mariofritzer/Trilumag/hardware/hauptplatine/vorschau.png

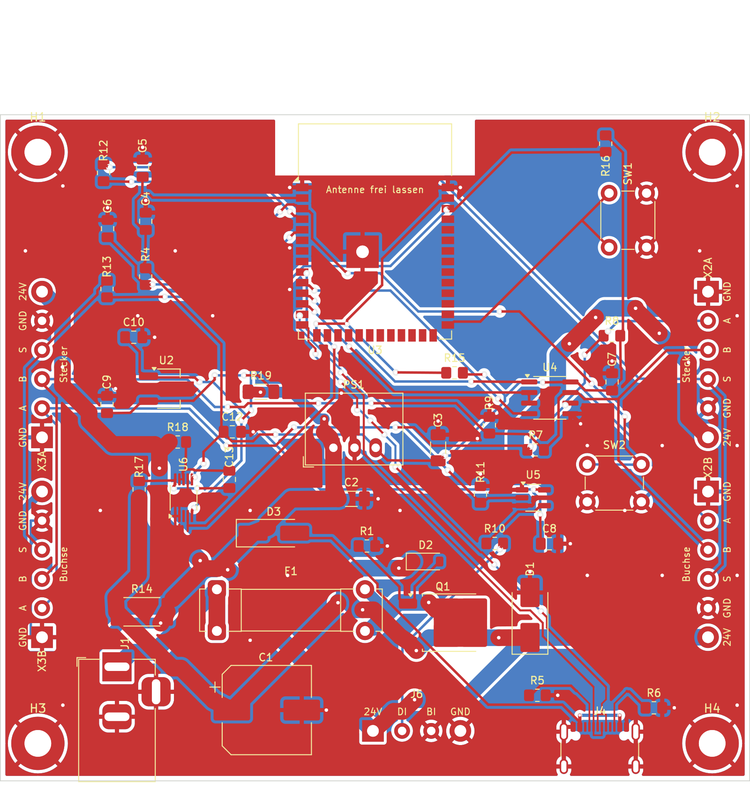
hardware/hauptplatine/vorschau.png
