mariofritzer/Trilumag/hardware/nebenplatine/vorschau.png

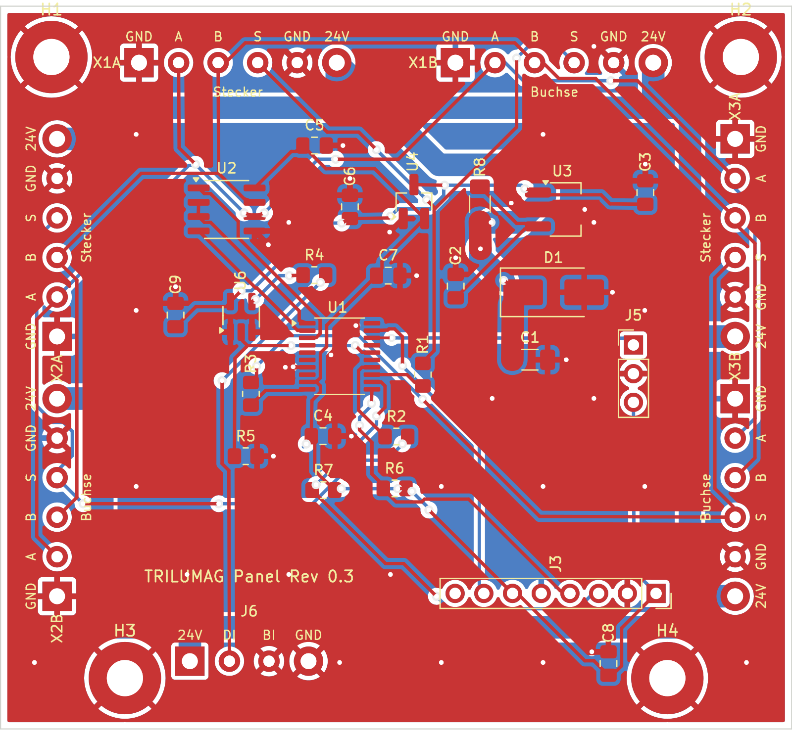
hardware/nebenplatine/vorschau.png
