mariofritzer/Trilumag/hardware/hauptplatine/stueckliste.csv

Menge | Referenzen | Wert | Footprint | Bestellhinweis
1 | C1 | 470µF 35V | CP_Elec_10x10.5 | Elko SMD 10×10,5 470 µF 35 V
1 | C2 | 10µF 50V | C_1206_3216Metric_Pad1.33x1.80mm_HandSolder
1 | C3 | 22µF | C_1206_3216Metric_Pad1.33x1.80mm_HandSolder
1 | C4 | 10µF | C_0805_2012Metric_Pad1.18x1.45mm_HandSolder
5 | C5 C7 C8 C12 C13 | 100nF | C_0805_2012Metric_Pad1.18x1.45mm_HandSolder
2 | C6 C10 | 1µF | C_0805_2012Metric_Pad1.18x1.45mm_HandSolder
1 | C9 | 1µF 50V | C_0805_2012Metric_Pad1.18x1.45mm_HandSolder
1 | D1 | SMBJ26A | D_SMB_Handsoldering | SMBJ26A
1 | D2 | 12V | D_SOD-123 | BZT52C12
1 | D3 | SS34 | D_SMA_Handsoldering | SS34
1 | F1 | 6.3A träge | Fuseholder_Clip-5x20mm_Bel_FC-203-22_Lateral_P17.80x5.00mm_D1.17mm_Horizontal | Sicherungshalter 5×20 + Feinsicherung T6,3A
1 | J1 | 24V DC 5.5/2.1 | BarrelJack_Horizontal | DC-Buchse 5,5/2,1 mm, ≥5 A
1 | J4 | USB-C | USB_C_Receptacle_GCT_USB4105-xx-A_16P_TopMnt_Horizontal | GCT USB4105-GF-A
1 | J6 | LED-Streifen 1 | Kabel_4P_LED
1 | PS1 | R-78E3.3-1.0 | Converter_DCDC_RECOM_R-78E-0.5_THT | RECOM R-78E3.3-1.0 (oder R-783.3-1.0)
1 | Q1 | AOD4185 | TO-252-2 | AOD4185 (P-MOSFET −40 V)
1 | R1 | 100k | R_0805_2012Metric_Pad1.20x1.40mm_HandSolder
2 | R4 R11 | 10k | R_0805_2012Metric_Pad1.20x1.40mm_HandSolder
2 | R5 R6 | 5.1k | R_0805_2012Metric_Pad1.20x1.40mm_HandSolder
1 | R7 | 120Ω | R_0805_2012Metric_Pad1.20x1.40mm_HandSolder
2 | R8 R9 | 680Ω | R_0805_2012Metric_Pad1.20x1.40mm_HandSolder
1 | R10 | 33Ω | R_0805_2012Metric_Pad1.20x1.40mm_HandSolder
2 | R12 R13 | 100Ω | R_0805_2012Metric_Pad1.20x1.40mm_HandSolder
1 | R14 | 5mΩ | R_2512_6332Metric_Pad1.40x3.35mm_HandSolder | Shunt 5 mΩ 2512 2 W
2 | R15 R16 | 4.7k | R_0805_2012Metric_Pad1.20x1.40mm_HandSolder
2 | R17 R18 | 10Ω | R_0805_2012Metric_Pad1.20x1.40mm_HandSolder
1 | R19 | 10Ω | R_1206_3216Metric_Pad1.30x1.75mm_HandSolder
1 | SW1 | BOOT | SW_PUSH_6mm
1 | SW2 | RESET | SW_PUSH_6mm
1 | U2 | 78L05 | SOT-89-3_Handsoldering
1 | U3 | ESP32-S3-WROOM-1-N8R2 | ESP32-S3-WROOM-1 | ESP32-S3-WROOM-1 (N8R2 oder N16R8)
1 | U4 | MAX3485 | SOIC-8_3.9x4.9mm_P1.27mm | MAX3485ESA / SP3485EN
1 | U5 | 74AHCT1G125 | SOT-23-5_HandSoldering
1 | U6 | INA226 | VSSOP-10_3x3mm_P0.5mm | INA226AIDGSR (I²C 0x40)
1 | X2A | Kante 2 Pogo Stecker | Kabel_6P_Stecker | Magnet-Pogo 6-pol. männlich
1 | X2B | Kante 2 Pogo Buchse | Kabel_6P_Buchse | Magnet-Pogo 6-pol. weiblich
1 | X3A | Kante 3 Pogo Stecker | Kabel_6P_Stecker | Magnet-Pogo 6-pol. männlich
1 | X3B | Kante 3 Pogo Buchse | Kabel_6P_Buchse | Magnet-Pogo 6-pol. weiblich
