mariofritzer/Trilumag/hardware/nebenplatine/stueckliste.csv

Menge | Referenzen | Wert | Footprint | Bestellhinweis
1 | C1 | 10µF 50V | C_1206_3216Metric_Pad1.33x1.80mm_HandSolder | X5R/X7R 1206 50 V
1 | C2 | 1µF 50V | C_0805_2012Metric_Pad1.18x1.45mm_HandSolder
3 | C3 C6 C7 | 1µF | C_0805_2012Metric_Pad1.18x1.45mm_HandSolder
4 | C4 C5 C8 C9 | 100nF | C_0805_2012Metric_Pad1.18x1.45mm_HandSolder
1 | D1 | SMBJ26A | D_SMB_Handsoldering | SMBJ26A
1 | J3 | LIS3DH-Modul | PinSocket_1x08_P2.54mm_Vertical
1 | J5 | SWD | PinHeader_1x03_P2.54mm_Vertical
1 | J6 | LED-Streifen 1 | Kabel_4P_LED
3 | R1 R2 R3 | 100Ω | R_0805_2012Metric_Pad1.20x1.40mm_HandSolder
1 | R4 | 33Ω | R_0805_2012Metric_Pad1.20x1.40mm_HandSolder
1 | R5 | 10k | R_0805_2012Metric_Pad1.20x1.40mm_HandSolder
2 | R6 R7 | 4.7k | R_0805_2012Metric_Pad1.20x1.40mm_HandSolder
1 | R8 | 10Ω | R_1206_3216Metric_Pad1.30x1.75mm_HandSolder
1 | U1 | CH32V003F4P6 | TSSOP-20_4.4x6.5mm_P0.65mm | CH32V003F4P6
1 | U2 | MAX3485 | SOIC-8_3.9x4.9mm_P1.27mm | MAX3485ESA / SP3485EN
1 | U3 | 78L05 | SOT-89-3_Handsoldering | 78L05 SOT-89 (≥30 V Eingang)
1 | U4 | XC6206P332MR | SOT-23_Handsoldering | XC6206P332MR (3,3 V)
1 | U6 | 74AHCT1G125 | SOT-23-5_HandSoldering | 74AHCT1G125 SOT-23-5
1 | X1A | Kante 1 Pogo Stecker | Kabel_6P_Stecker | Magnet-Pogo 6-pol. männlich
1 | X1B | Kante 1 Pogo Buchse | Kabel_6P_Buchse | Magnet-Pogo 6-pol. weiblich
1 | X2A | Kante 2 Pogo Stecker | Kabel_6P_Stecker | Magnet-Pogo 6-pol. männlich
1 | X2B | Kante 2 Pogo Buchse | Kabel_6P_Buchse | Magnet-Pogo 6-pol. weiblich
1 | X3A | Kante 3 Pogo Stecker | Kabel_6P_Stecker | Magnet-Pogo 6-pol. männlich
1 | X3B | Kante 3 Pogo Buchse | Kabel_6P_Buchse | Magnet-Pogo 6-pol. weiblich
