mariofritzer/Trilumag/installer/index.html

# Trilumag

Dreieckige Lichtpanels mit Magnetkontakten. Hier spielst du die Firmware für das Hauptpanel direkt aus dem Browser auf einen ESP32 und richtest gleich das WLAN ein.

## Installieren

Mit ESP32 verbinden und installieren Dieser Browser kann nicht auf USB zugreifen. Bitte Chrome, Edge oder Opera am Computer verwenden. Auf iPhone, iPad und in Firefox oder Safari geht es nicht. Die Seite muss über https geöffnet werden.

ESP32ESP32-S3ESP32-C3ESP32-C6Version __VERSION__

Der Installer erkennt selbst, welcher ESP32 angeschlossen ist, und wählt die passende Firmware.

## Ohne ESP32 ausprobieren

Die Trilumag-App läuft hier auch ganz ohne Hardware: mit einer simulierten Panelwand, die du anklipsen, einfärben und mit allen Effekten ausprobieren kannst. Das geht auch am Handy, in jedem Browser.

Simulation öffnen

Alles bleibt in deinem Browser, nichts davon steuert echte Panels. WLAN, Updates, Home Assistant und Hue gehen nur mit einem echten Hauptpanel.

## So geht’s

1. ESP32 per USB-Kabel an den Computer anschließen. Beim ESP32-S3-DevKitC die Buchse mit der Aufschrift COM oder UART nehmen.
2. Oben auf Installieren tippen und im Fenster den Anschluss auswählen, meist heißt er USB Serial, CP210x, CH340 oder USB JTAG/serial.
3. Trilumag installieren wählen. Beim ersten Mal den Speicher löschen lassen. Das Aufspielen dauert etwa eine Minute.
4. Danach fragt der Installer nach deinem WLAN. Netz auswählen, Passwort eingeben, fertig.
5. Mit Gerät besuchen öffnet sich die Trilumag-App. Später erreichst du sie unter http://trilumag.local.

## Simulation oder echte Panels

Nach dem Installieren läuft Trilumag im Simulationsmodus: Die Panels werden in der App angeklipst, ganz ohne Hardware. Unter Optionen in der App stellst du auf Bus um, sobald echte Panels über RS-485 angeschlossen sind. Dort wählst du auch dein Board, damit die Pins stimmen.

## Firmware für die Panels

Die Panels haben einen CH32V003 und werden einmalig mit dem WCH-LinkE programmiert (Pins SWIO, GND und 3V3).

panel.binpanel.hexVersion __VERSION__

1. Windows: Im WCH-LinkUtility als Chip CH32V003 wählen, panel.hex laden und auf Program klicken.
2. Linux, macOS, Windows: mit minichlink aus ch32fun: minichlink -w panel.bin flash -b
3. Ein frisch programmiertes Panel bleibt dunkel. Das ist richtig, es wartet darauf, vom Hauptpanel gefunden zu werden.

## Wenn es nicht klappt

Der ESP32 taucht nicht in der Liste auf

Anderes USB-Kabel probieren, viele Kabel laden nur und übertragen keine Daten. Unter Windows eventuell den Treiber für den USB-Chip installieren (CP210x oder CH340, steht meist auf dem Board).

Die Verbindung bricht beim Aufspielen ab

Taste BOOT gedrückt halten, kurz RESET drücken, BOOT loslassen und neu starten. Dann ist der ESP32 sicher im Programmiermodus.

Das WLAN lässt sich im Installer nicht einrichten

Kein Problem: Der ESP32 öffnet dann ein eigenes Netz Trilumag-Setup mit dem Passwort trilumag. Damit verbinden und http://192.168.4.1 öffnen, dort das WLAN eintragen.

Nur 2,4 GHz

Der ESP32 kann kein 5-GHz-WLAN. Dein Router muss ein 2,4-GHz-Netz anbieten.

Quellcode und Bauplan: github.com/mariofritzer/Trilumag · Versionsverlauf (https://github.com/mariofritzer/Trilumag/blob/main/CHANGELOG.md)
