mariofritzer/Trilumag/hardware/nebenplatine/schaltplan.pdf

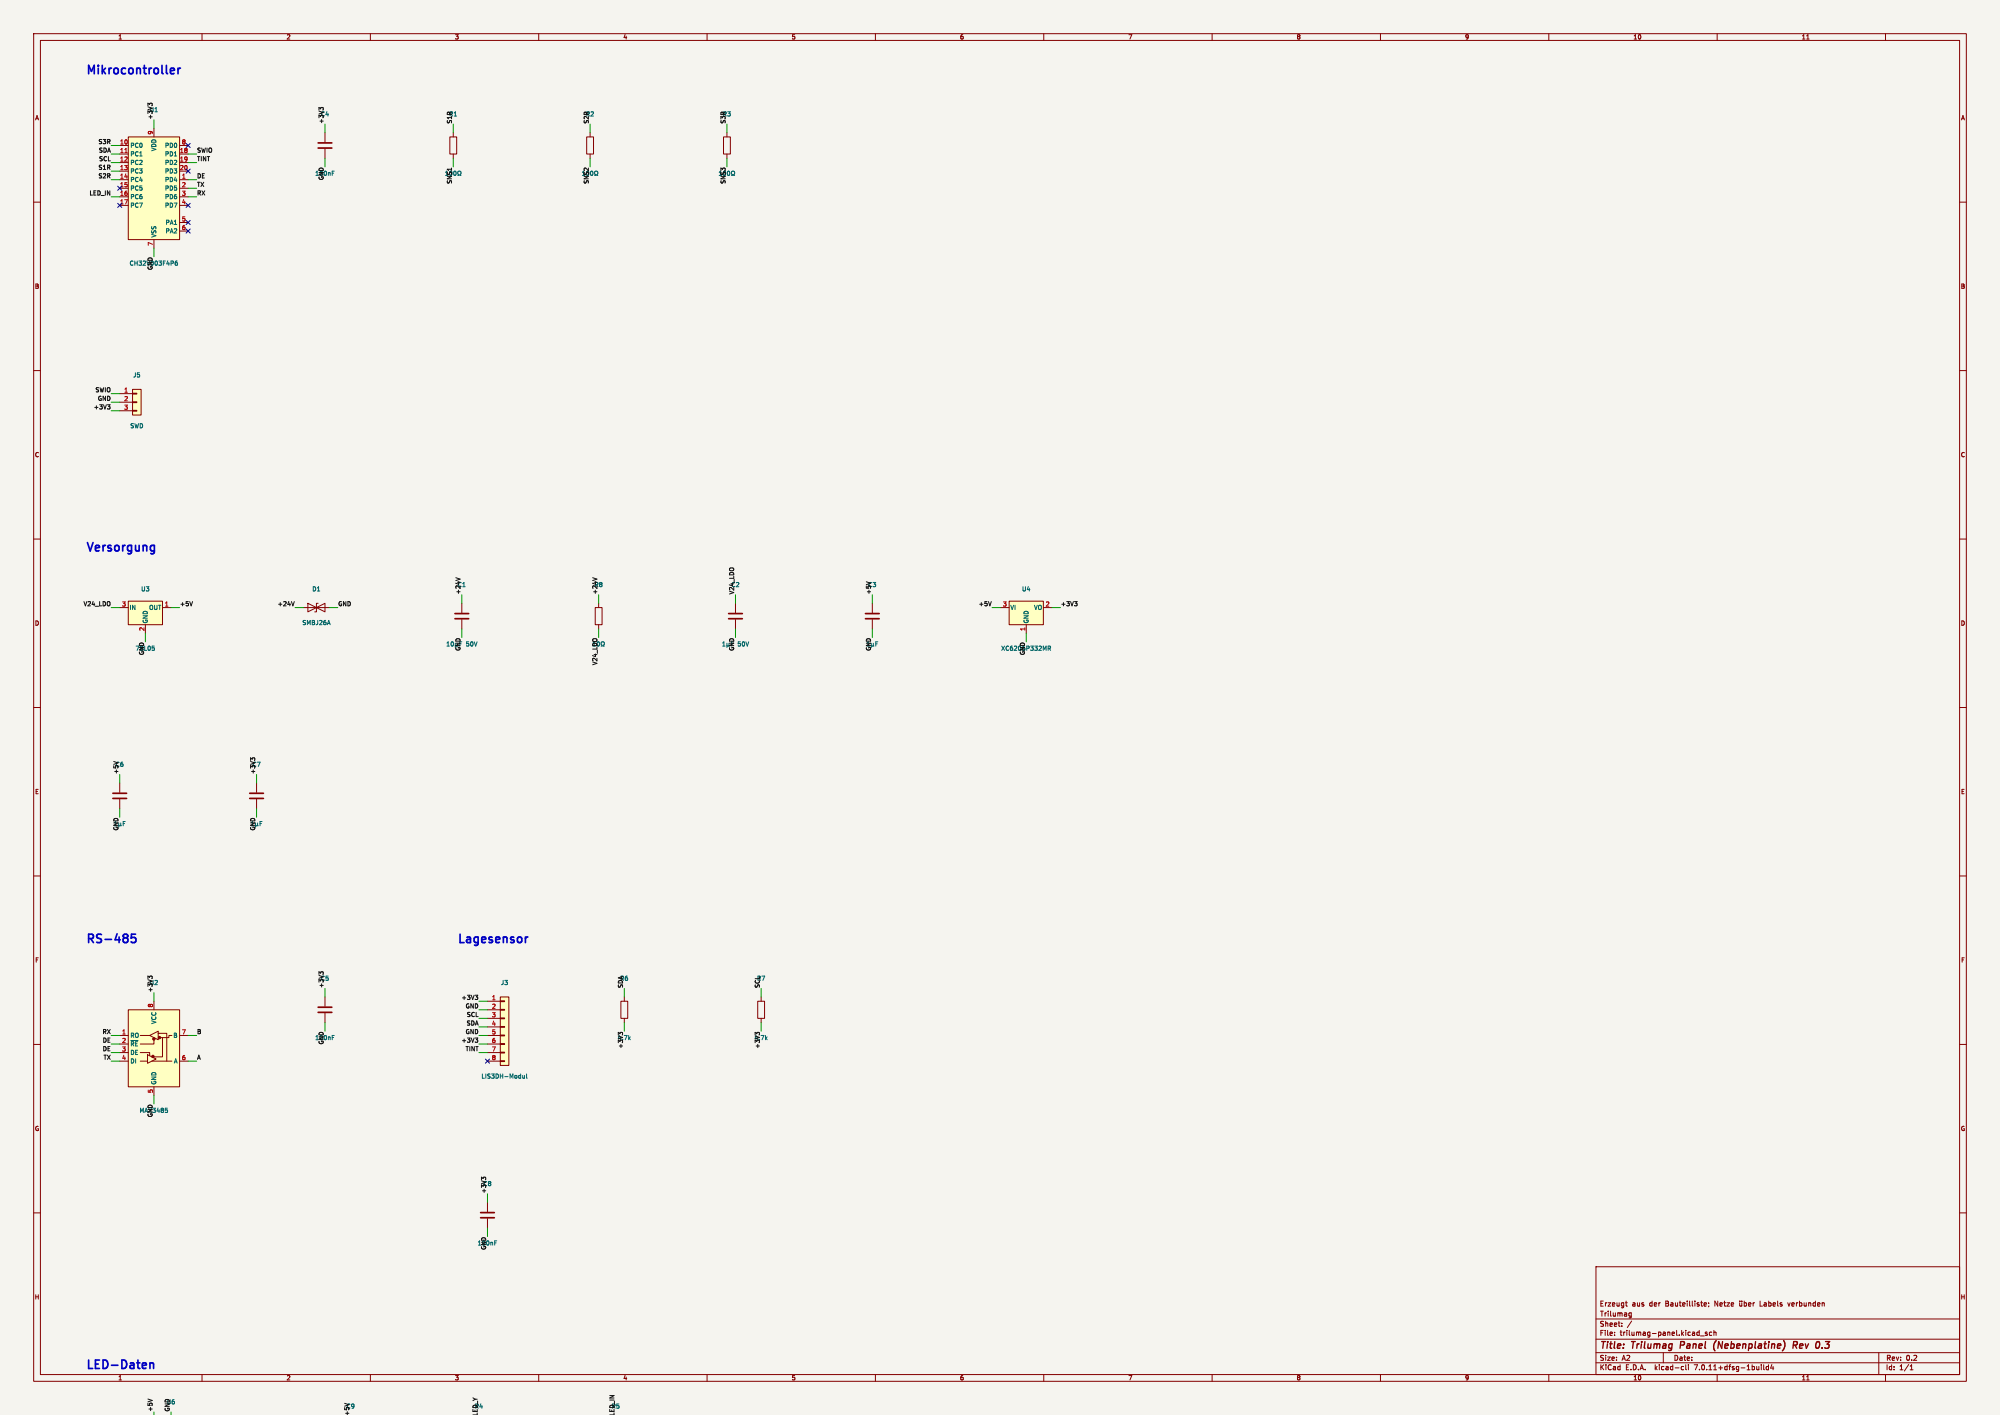
[picture p4: page 1]

File: trilumag-panel.kicad_sch Sheet: / Trilumag
