mariofritzer/Trilumag/hardware/hauptplatine/trilumag-hauptplatine.kicad_pcb

## KiCad design hardware/hauptplatine/trilumag-hauptplatine.kicad_pcb (2026-10-31)

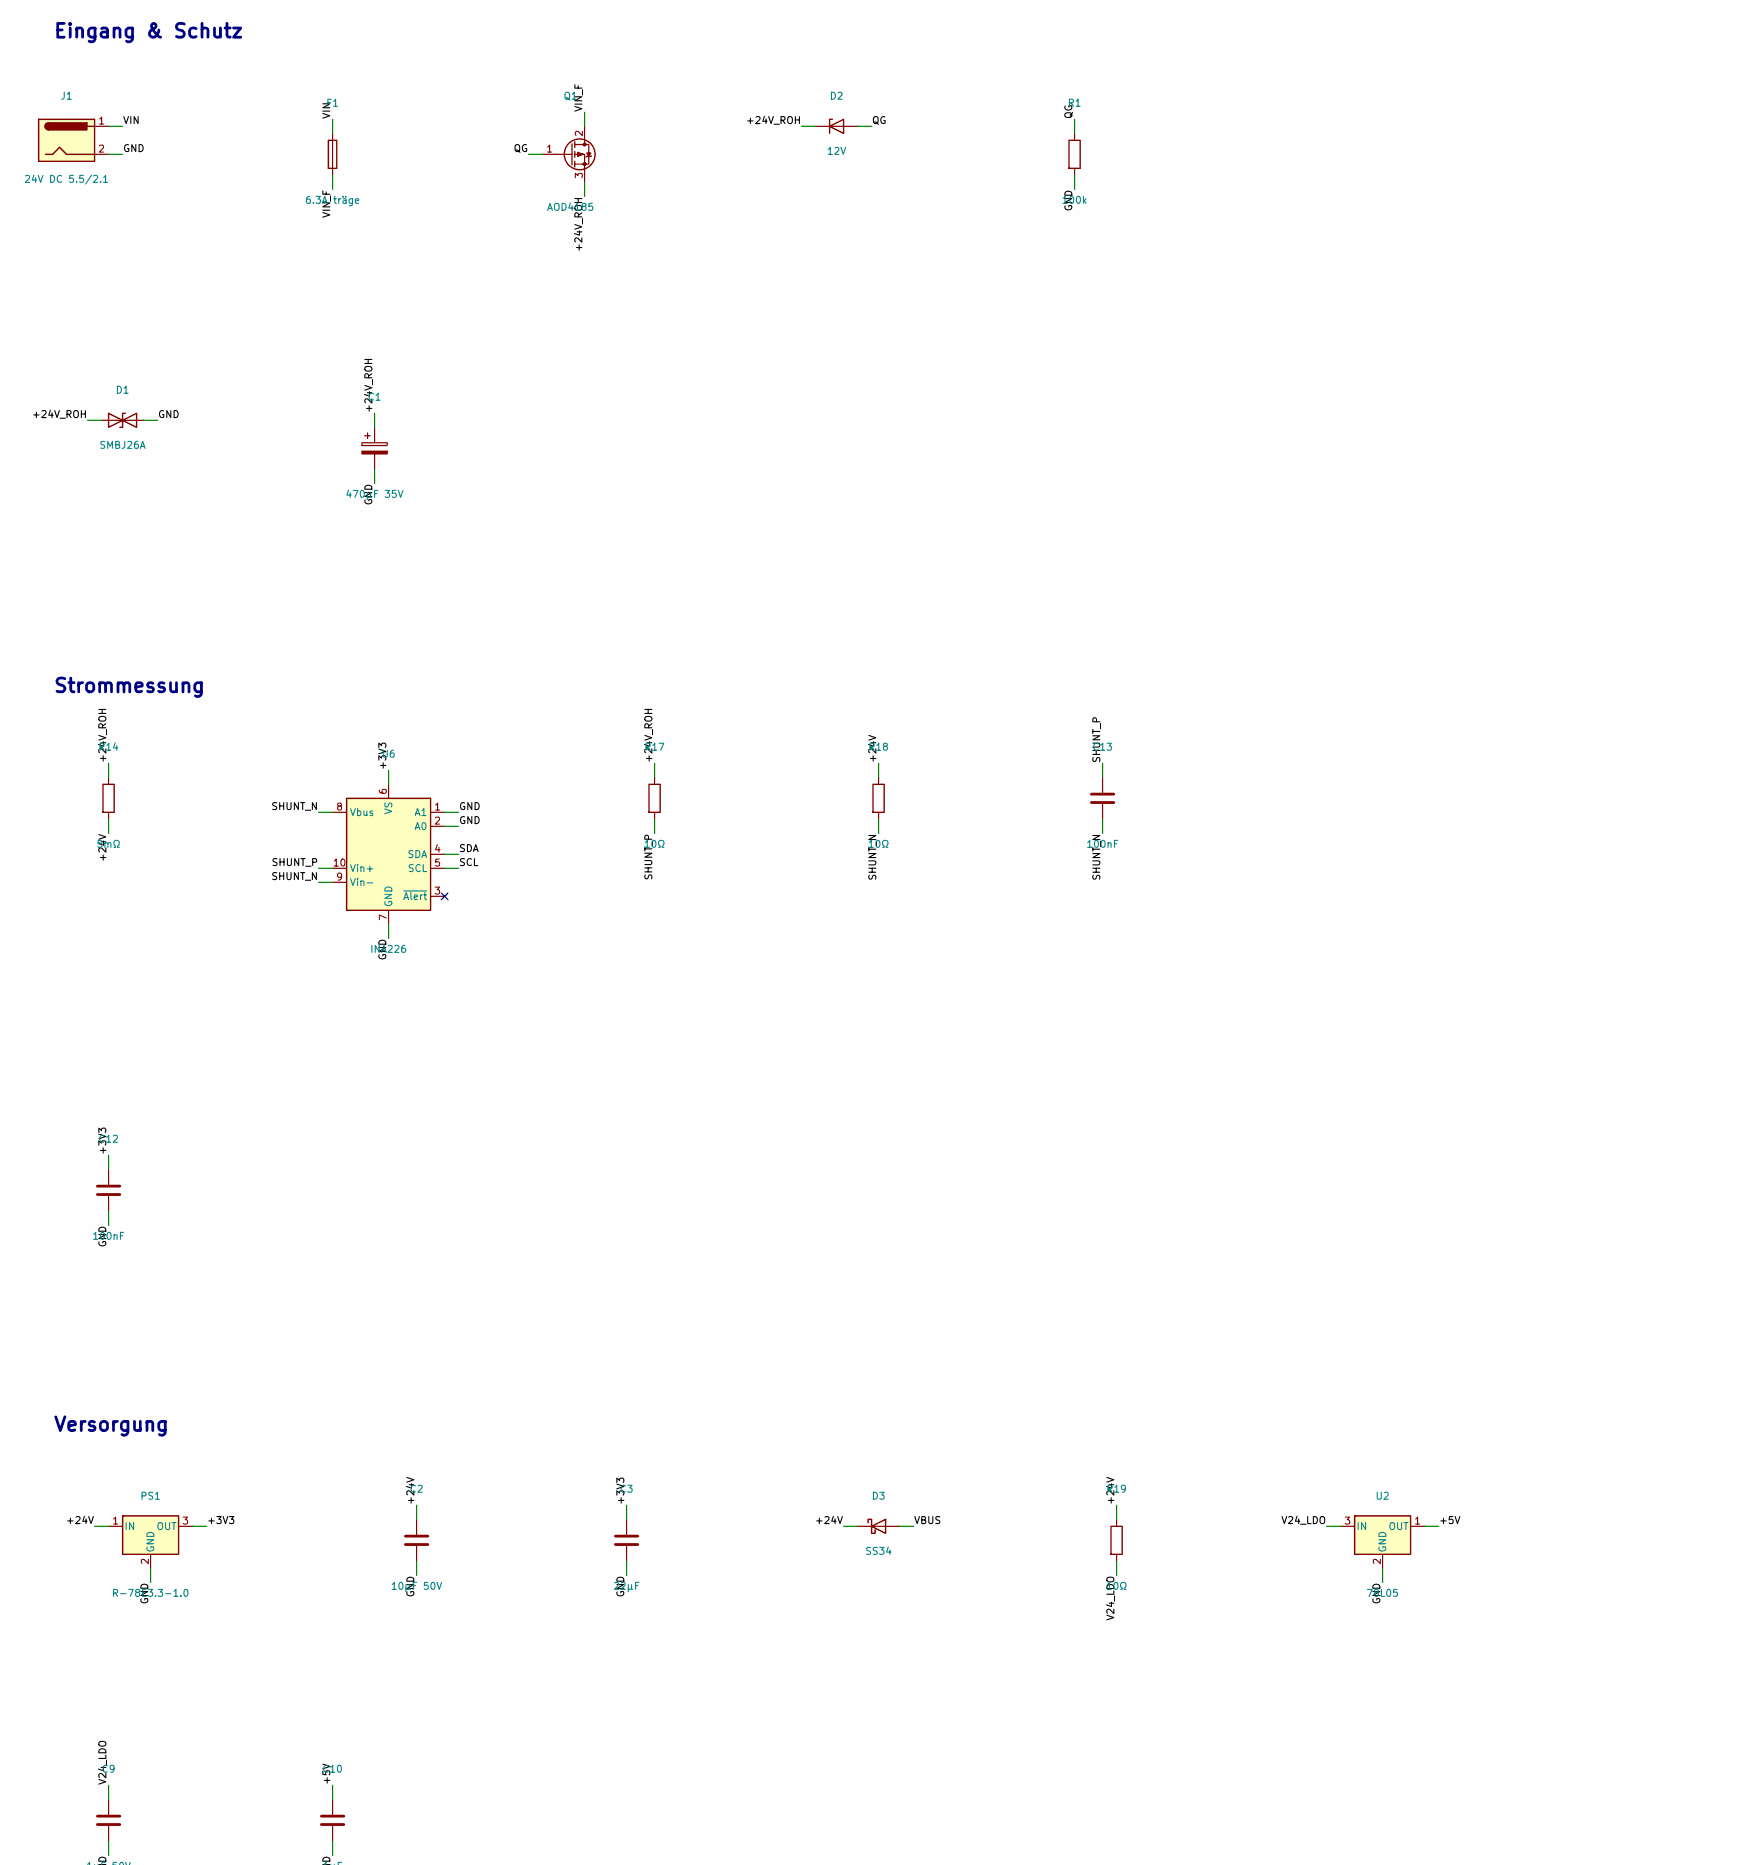
[picture p5: schematic trilumag-hauptplatine.kicad_sch, Trilumag Hauptplatine (ESP32-S3), part in row 1, column 1]

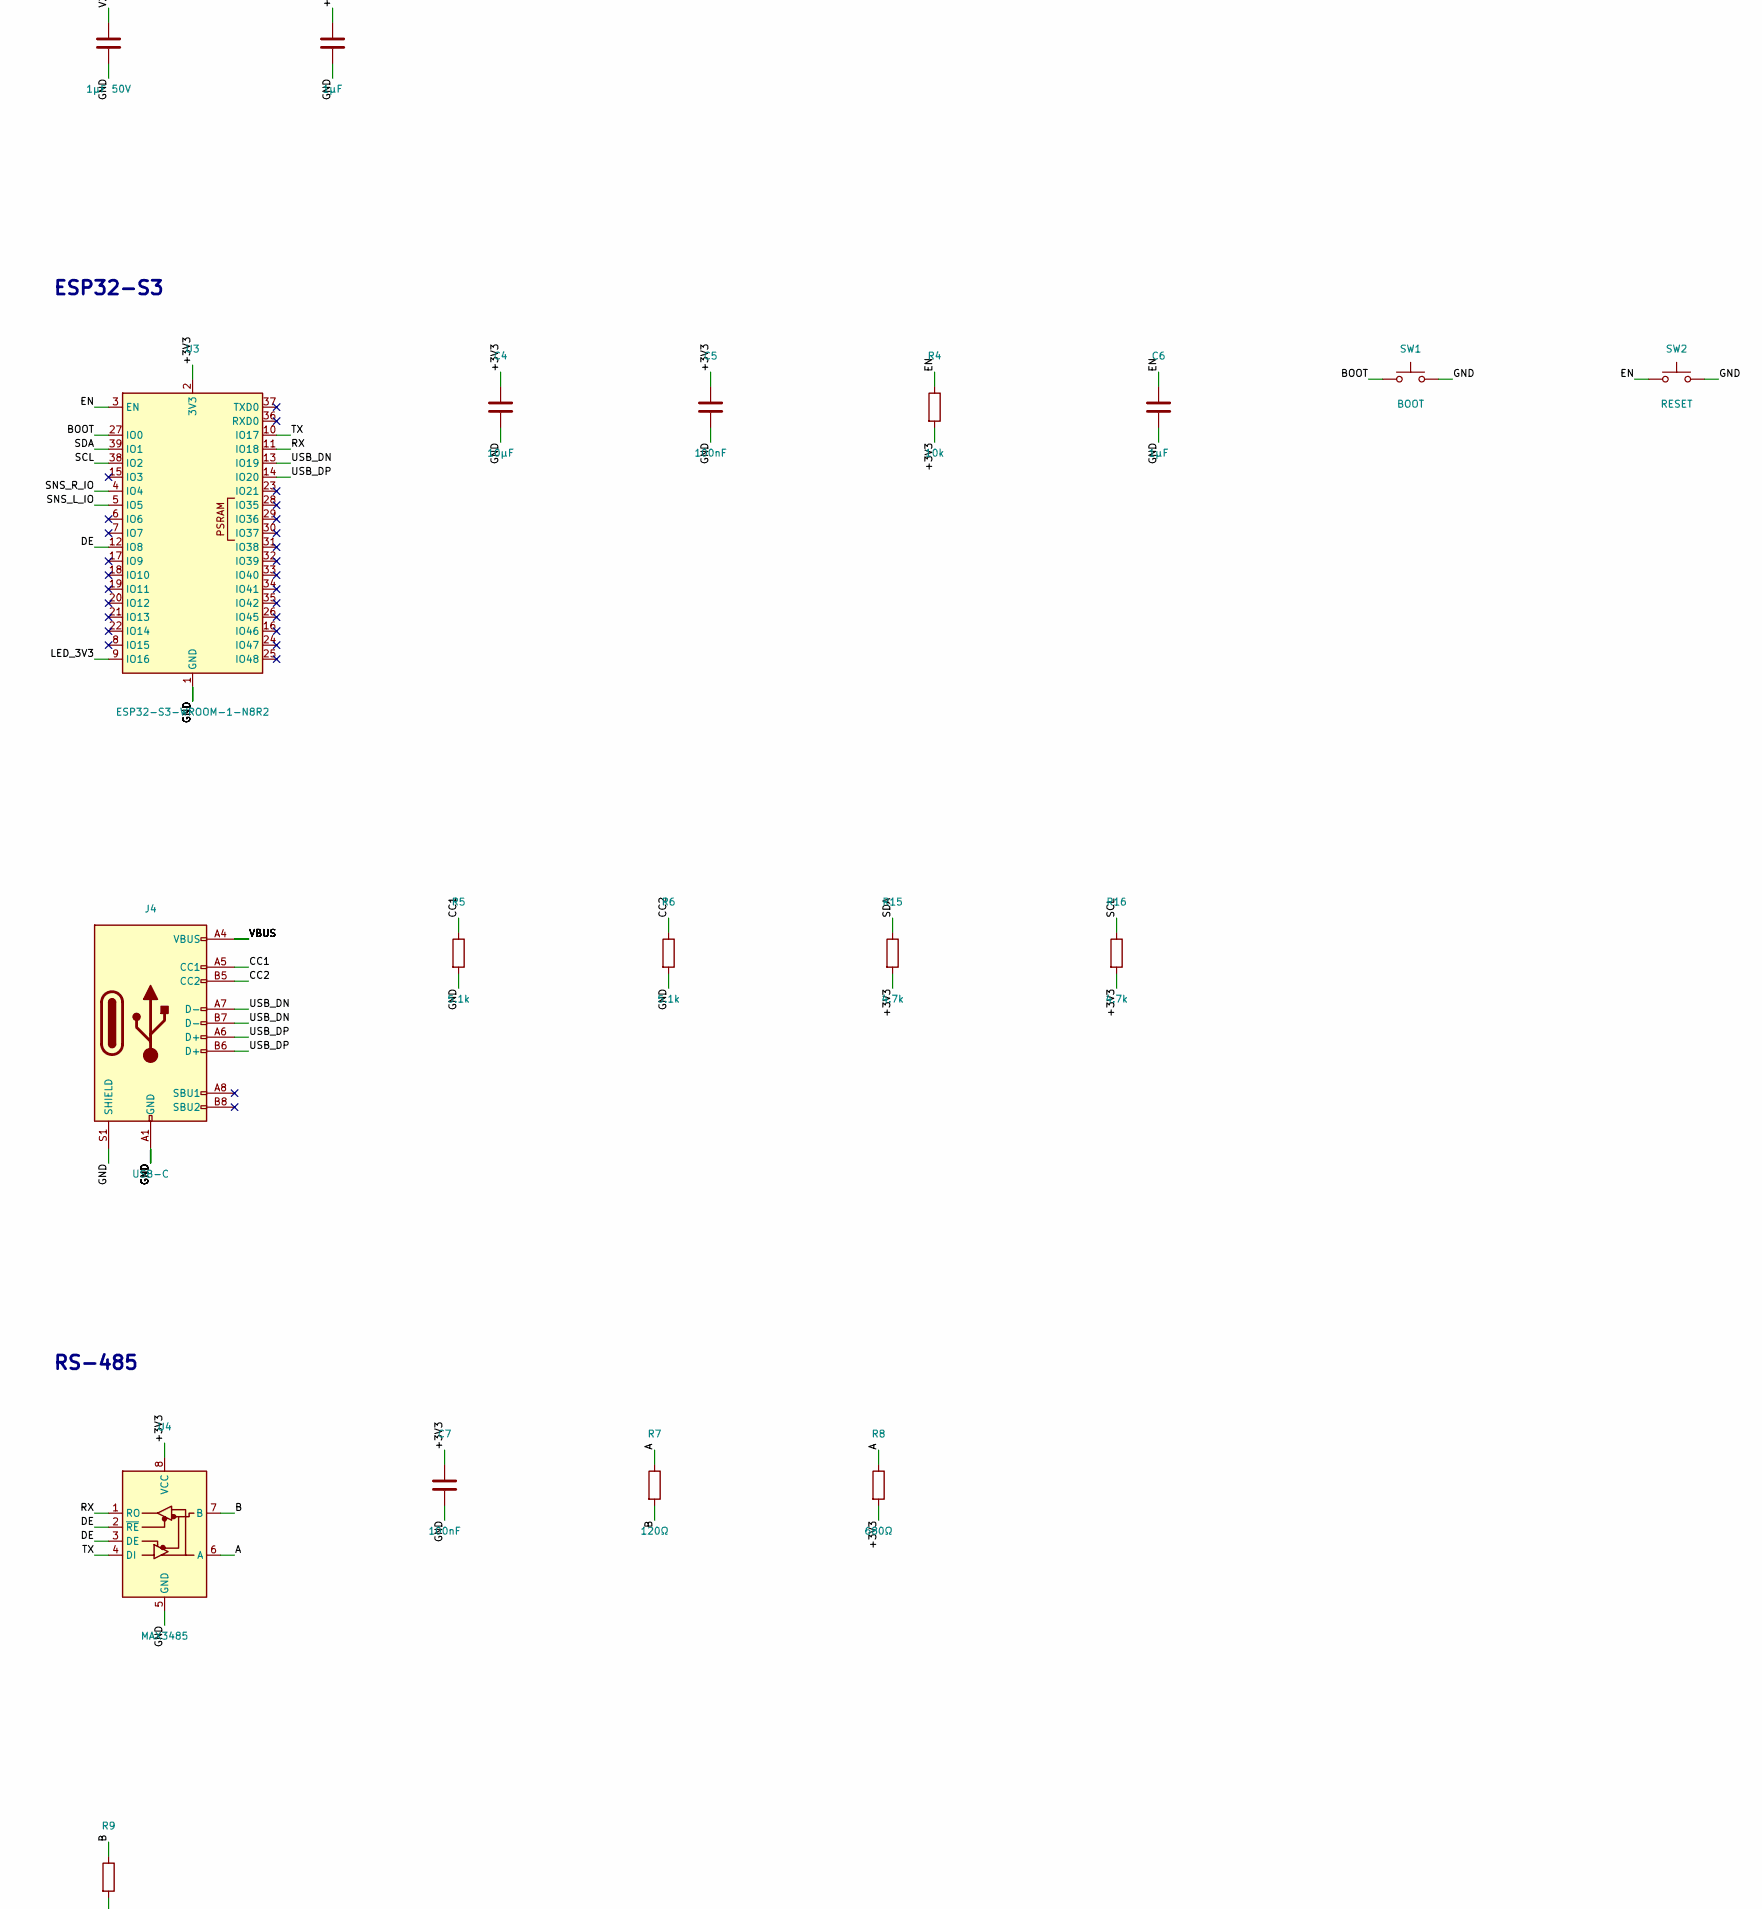
[picture p6: schematic trilumag-hauptplatine.kicad_sch, Trilumag Hauptplatine (ESP32-S3), part in row 2, column 1]

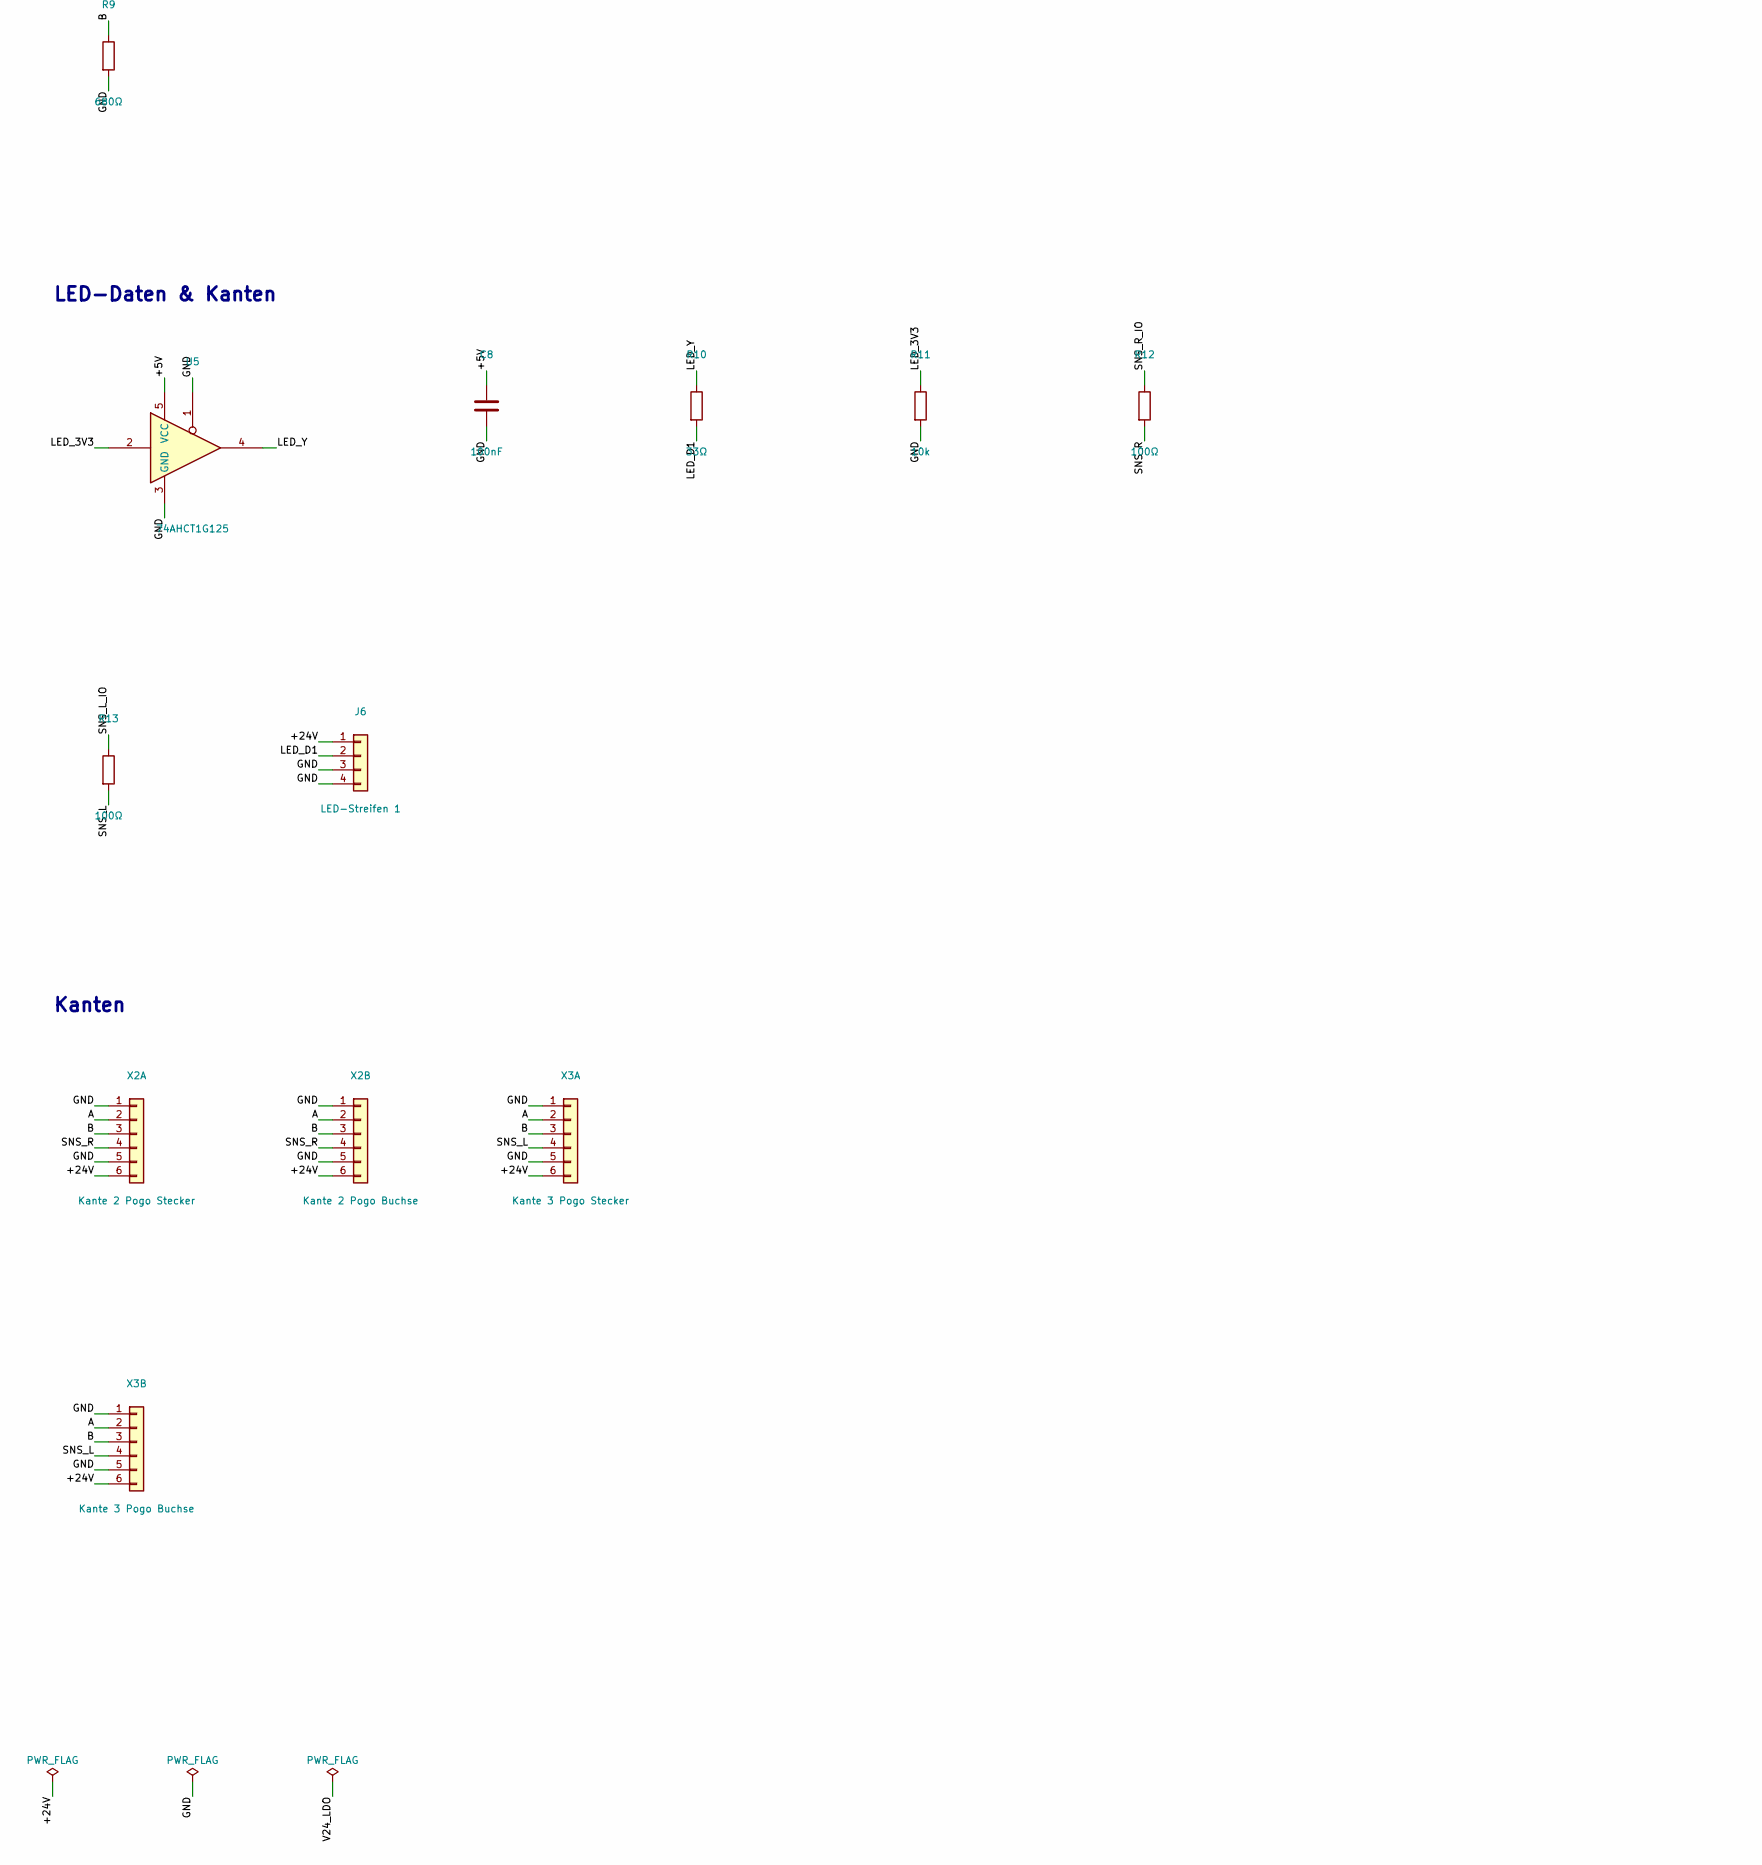
[picture p7: schematic trilumag-hauptplatine.kicad_sch, Trilumag Hauptplatine (ESP32-S3), part in row 3, column 1]

Parts:
C1: 470µF 35V; CP_Elec_10x10.5
C2: 10µF 50V; C_1206_3216Metric_Pad1.33x1.80mm_HandSolder
C3: 22µF; C_1206_3216Metric_Pad1.33x1.80mm_HandSolder
C4: 10µF; C_0805_2012Metric_Pad1.18x1.45mm_HandSolder
C5, C7, C8, C12, C13: 100nF; C_0805_2012Metric_Pad1.18x1.45mm_HandSolder
C6, C10: 1µF; C_0805_2012Metric_Pad1.18x1.45mm_HandSolder
C9: 1µF 50V; C_0805_2012Metric_Pad1.18x1.45mm_HandSolder
D1: SMBJ26A; D_SMB_Handsoldering
D2: 12V; D_SOD-123
D3: SS34; D_SMA_Handsoldering
F1: 6.3A träge; Fuseholder_Clip-5x20mm_Bel_FC-203-22_Lateral_P17.80x5.00mm_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
J1: 24V DC 5.5/2.1; BarrelJack_Horizontal
J4: USB-C; USB_C_Receptacle_GCT_USB4105-xx-A_16P_TopMnt_Horizontal
J6: LED-Streifen 1; Kabel_4P_LED
PS1: R-78E3.3-1.0; Converter_DCDC_RECOM_R-78E-0.5_THT
Q1: AOD4185; TO-252-2
R1: 100k; R_0805_2012Metric_Pad1.20x1.40mm_HandSolder
R4, R11: 10k; R_0805_2012Metric_Pad1.20x1.40mm_HandSolder
R5, R6: 5.1k; R_0805_2012Metric_Pad1.20x1.40mm_HandSolder
R7: 120Ω; R_0805_2012Metric_Pad1.20x1.40mm_HandSolder
R8, R9: 680Ω; R_0805_2012Metric_Pad1.20x1.40mm_HandSolder
R10: 33Ω; R_0805_2012Metric_Pad1.20x1.40mm_HandSolder
R12, R13: 100Ω; R_0805_2012Metric_Pad1.20x1.40mm_HandSolder
R14: 5mΩ; R_2512_6332Metric_Pad1.40x3.35mm_HandSolder
R15, R16: 4.7k; R_0805_2012Metric_Pad1.20x1.40mm_HandSolder
R17, R18: 10Ω; R_0805_2012Metric_Pad1.20x1.40mm_HandSolder
R19: 10Ω; R_1206_3216Metric_Pad1.30x1.75mm_HandSolder
SW1: BOOT; SW_PUSH_6mm
SW2: RESET; SW_PUSH_6mm
U2: 78L05; SOT-89-3_Handsoldering
U3: ESP32-S3-WROOM-1-N8R2; ESP32-S3-WROOM-1
U4: MAX3485; SOIC-8_3.9x4.9mm_P1.27mm
U5: 74AHCT1G125; SOT-23-5_HandSoldering
U6: INA226; VSSOP-10_3x3mm_P0.5mm
X2A: Kante 2 Pogo Stecker; Kabel_6P_Stecker
X2B: Kante 2 Pogo Buchse; Kabel_6P_Buchse
X3A: Kante 3 Pogo Stecker; Kabel_6P_Stecker
X3B: Kante 3 Pogo Buchse; Kabel_6P_Buchse

Connections:
+3V3: C3.1, C4.1, C5.1, C7.1, C12.1, PS1.3 (OUT), R4.2, R8.2, R15.2, R16.2, U3.2 (3V3), U4.8 (VCC), U6.6 (VS)
+5V: C8.1, C10.1, U2.1 (OUT), U5.5 (VCC)
+24V: C2.1, D3.1 (K), J6.1, PS1.1 (IN), R14.2, R18.1, R19.1, X2A.6, X2B.6, X3A.6, X3B.6
+24V_ROH: C1.1, D1.1 (A1), D2.1 (K), Q1.3 (S), R14.1, R17.1
A: R7.1, R8.1, U4.6 (A), X2A.2, X2B.2, X3A.2, X3B.2
B: R7.2, R9.1, U4.7 (B), X2A.3, X2B.3, X3A.3, X3B.3
BOOT: SW1.1, U3.27 (IO0)
CC1: J4.A5 (CC1), R5.1
CC2: J4.B5 (CC2), R6.1
DE: U3.12 (IO8), U4.2 (~RE), U4.3 (DE)
EN: C6.1, R4.1, SW2.1, U3.3 (EN)
GND: C1.2, C2.2, C3.2, C4.2, C5.2, C6.2, C7.2, C8.2, C9.2, C10.2, C12.2, D1.2 (A2), J1.2, J1.3, J4.A1 (GND), J4.A12 (GND), J4.B1 (GND), J4.B12 (GND), J4.S1 (SHIELD), J6.3, J6.4, PS1.2 (GND), R1.2, R5.2, R6.2, R9.2, R11.2, SW1.2, SW2.2, U2.2 (GND), U3.1 (GND), U3.40 (GND), U3.41 (GND), U4.5 (GND), U5.1, U5.3 (GND), U6.1 (A1), U6.2 (A0), U6.7 (GND), X2A.1, X2A.5, X2B.1, X2B.5, X3A.1, X3A.5, X3B.1, X3B.5; also elsewhere on the board
LED_3V3: R11.1, U3.9 (IO16), U5.2
LED_D1: J6.2, R10.2
LED_Y: R10.1, U5.4
QG: D2.2 (A), Q1.1 (G), R1.1
RX: U3.11 (IO18), U4.1 (RO)
SCL: R16.1, U3.38 (IO2), U6.5 (SCL)
SDA: R15.1, U3.39 (IO1), U6.4 (SDA)
SHUNT_N: C13.2, R18.2, U6.8 (Vbus), U6.9 (Vin-)
SHUNT_P: C13.1, R17.2, U6.10 (Vin+)
SNS_L: R13.2, X3A.4, X3B.4
SNS_L_IO: R13.1, U3.5 (IO5)
SNS_R: R12.2, X2A.4, X2B.4
SNS_R_IO: R12.1, U3.4 (IO4)
TX: U3.10 (IO17), U4.4 (DI)
USB_DN: J4.A7 (D-), J4.B7 (D-), U3.13 (IO19)
USB_DP: J4.A6 (D+), J4.B6 (D+), U3.14 (IO20)
V24_LDO: C9.1, R19.2, U2.3 (IN)
VBUS: D3.2 (A), J4.A4 (VBUS), J4.A9 (VBUS), J4.B4 (VBUS), J4.B9 (VBUS)
VIN: F1.1, J1.1
VIN_F: F1.2, Q1.2 (D)

Notes on the sheet:
Eingang & Schutz
Strommessung
Versorgung
ESP32-S3
RS-485
LED-Daten & Kanten
Kanten

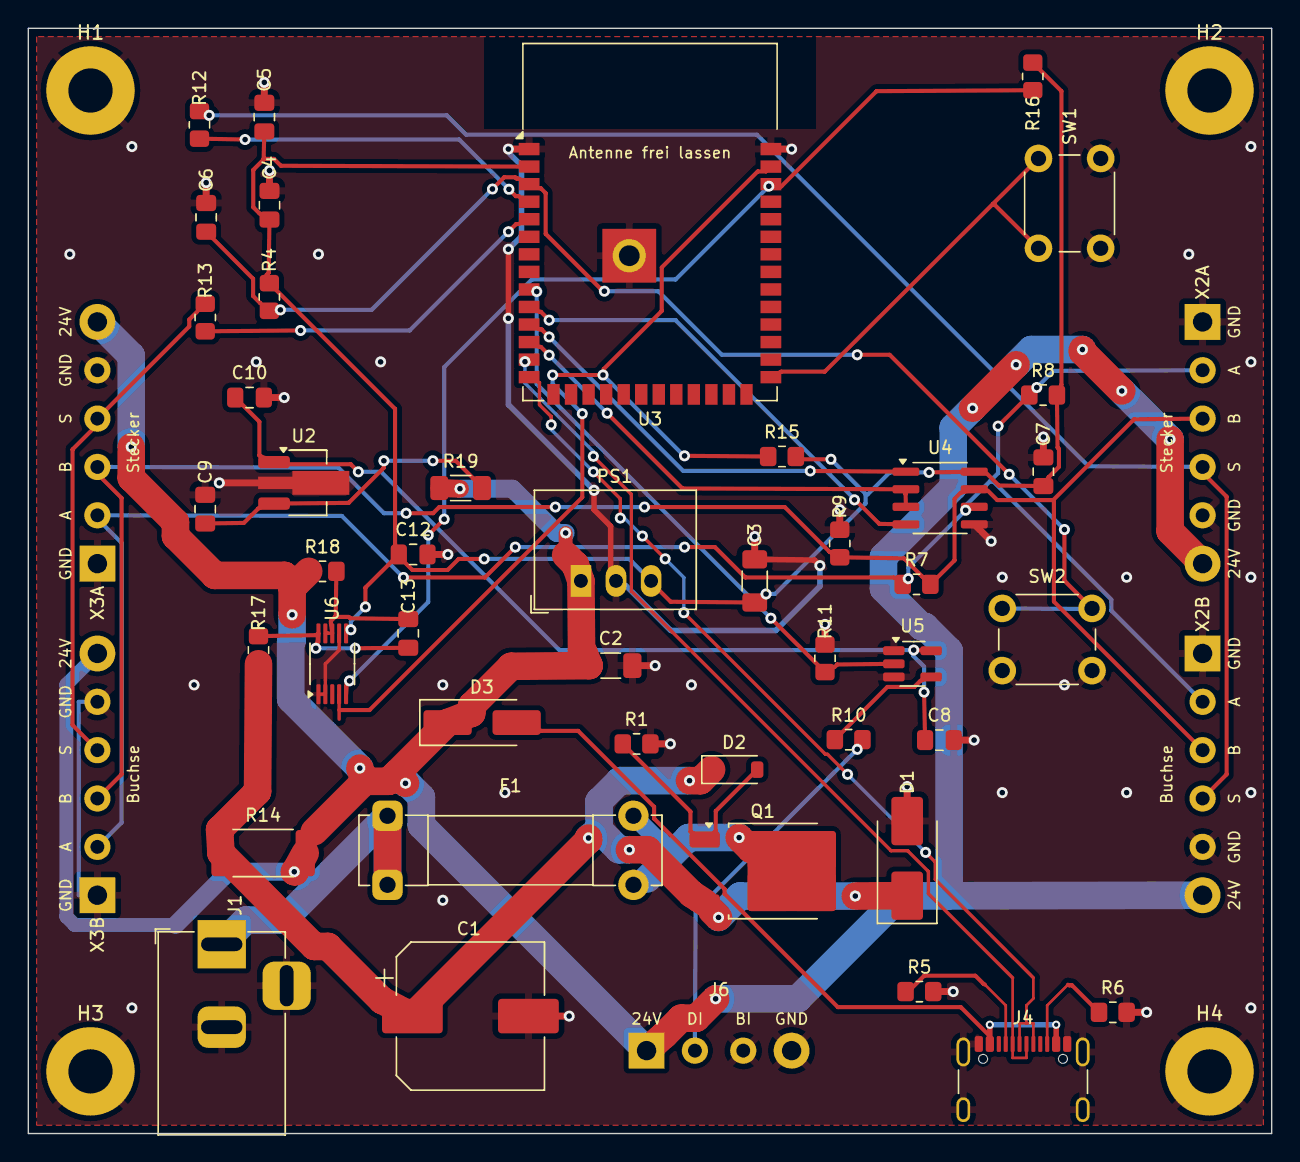
[picture p8: board trilumag-hauptplatine.kicad_pcb from above]

Board: 2 copper layers, 90.0 x 80.0 mm, 53 parts (0 on the bottom side), 32 nets.

Other parts of the board:
H1, H2, H3, H4: M3; MountingHole_3.2mm_M3_Pad

Their connections:
GND: H1.1, H2.1, H3.1, H4.1; also elsewhere on the board
