mariofritzer/Trilumag/hardware/nebenplatine/trilumag-panel.kicad_pcb

## KiCad design hardware/nebenplatine/trilumag-panel.kicad_pcb (2026-10-31)

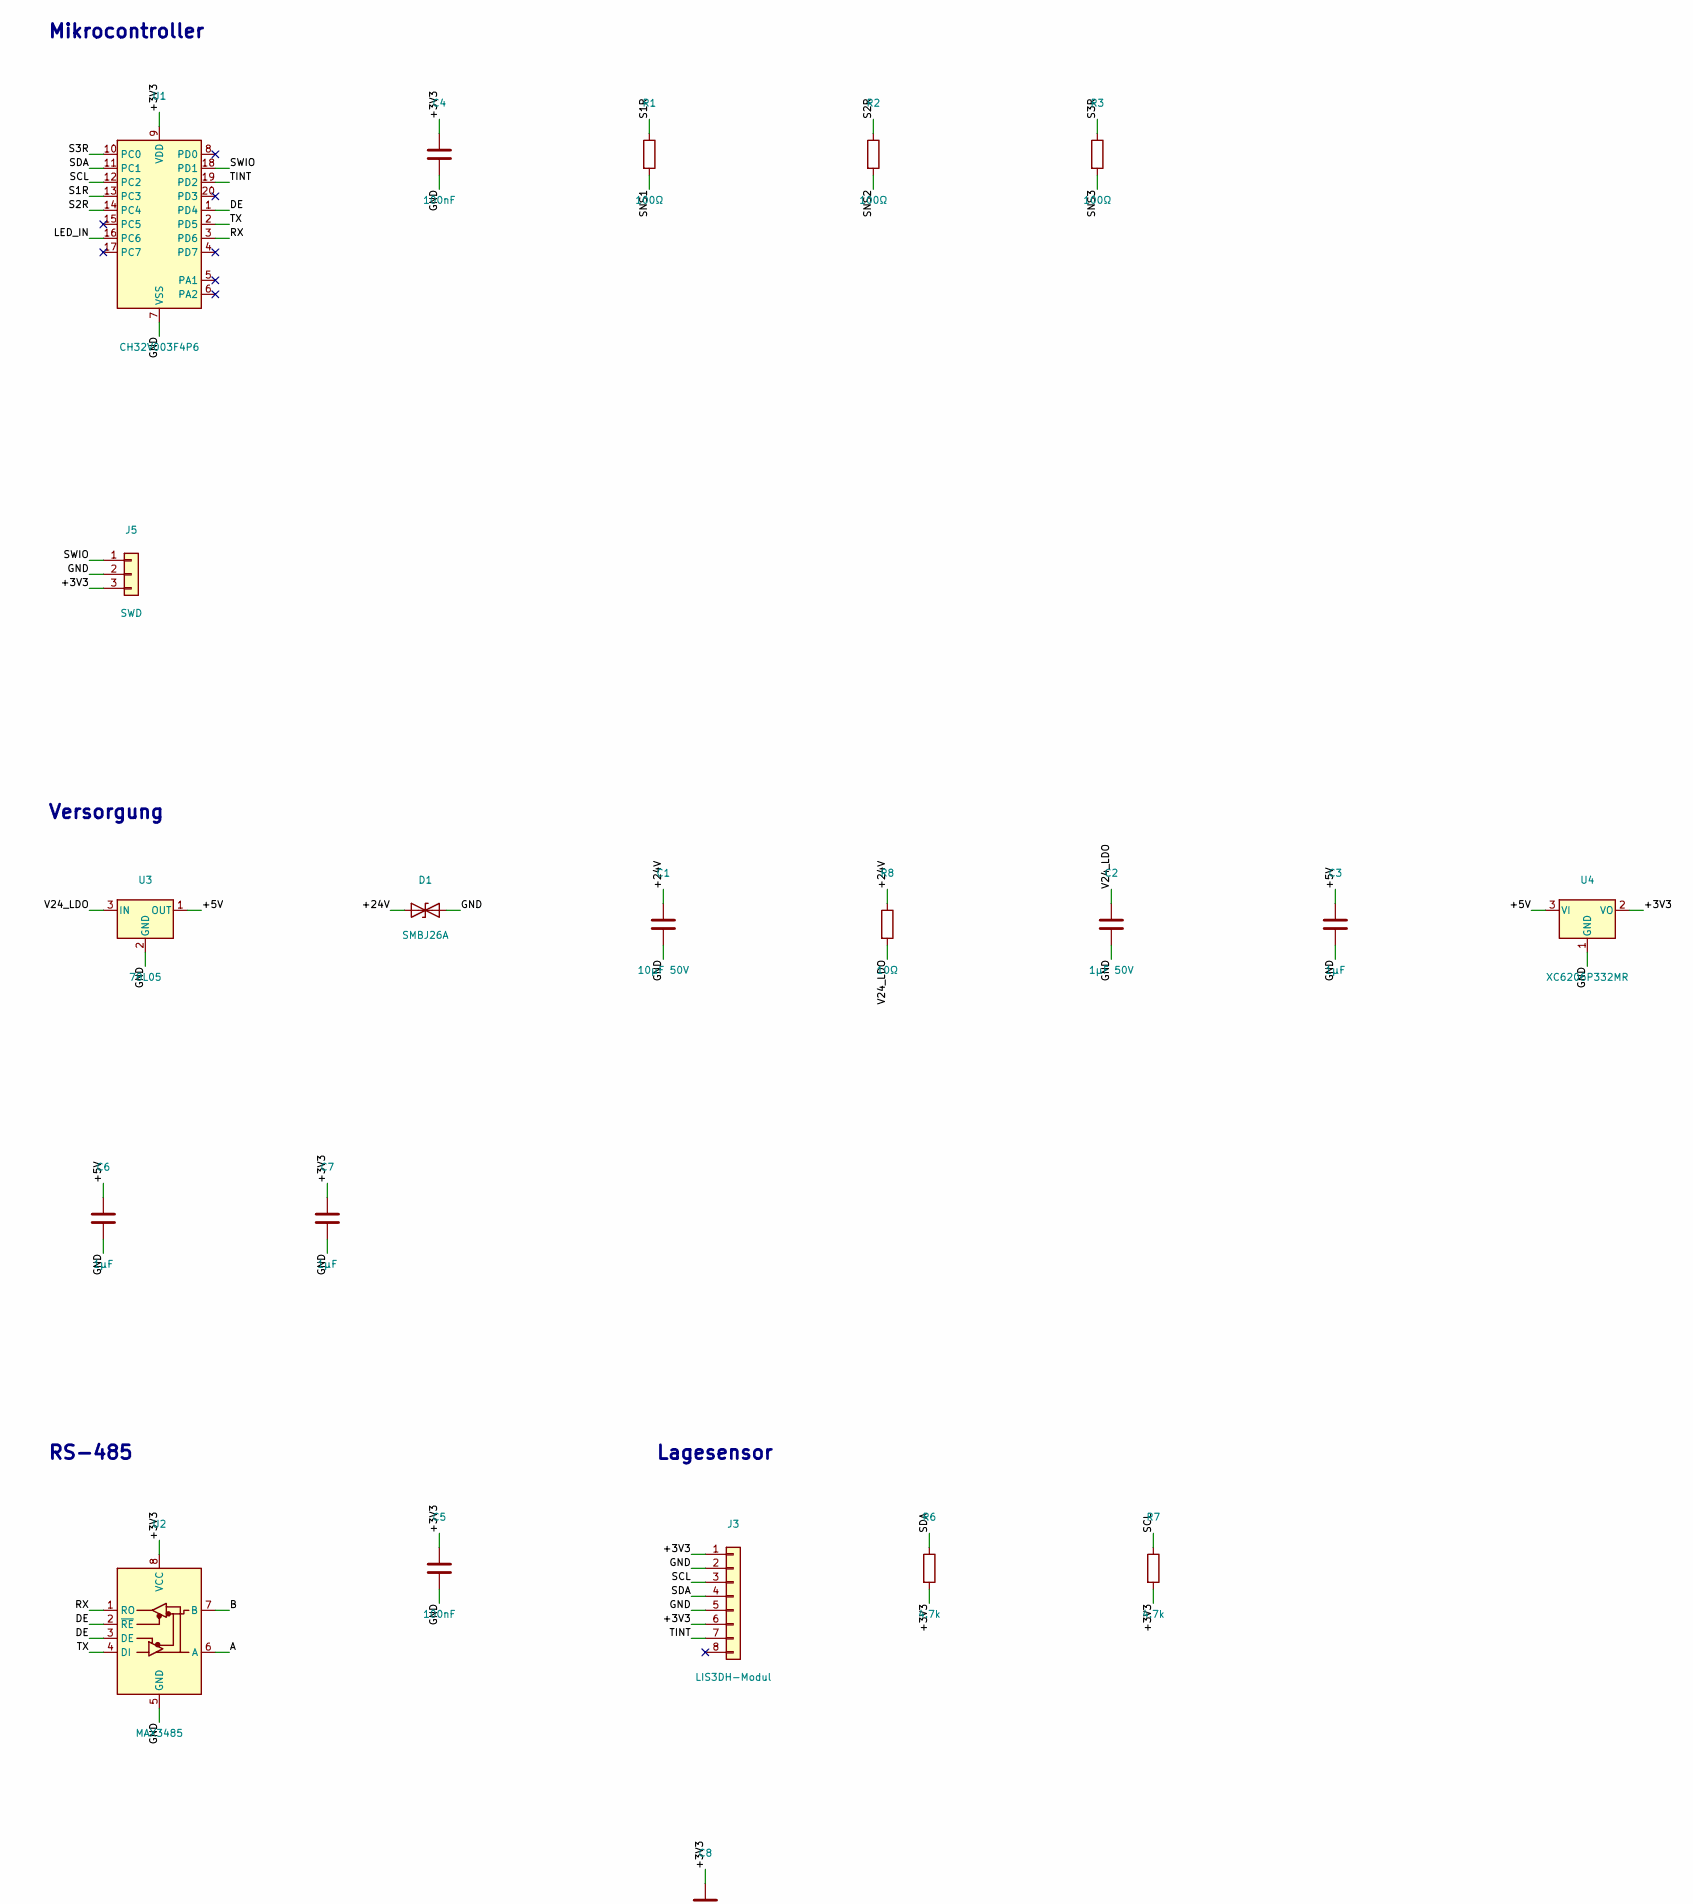
[picture p9: schematic trilumag-panel.kicad_sch, Trilumag Panel (Nebenplatine) Rev 0.3, part in row 1, column 1]

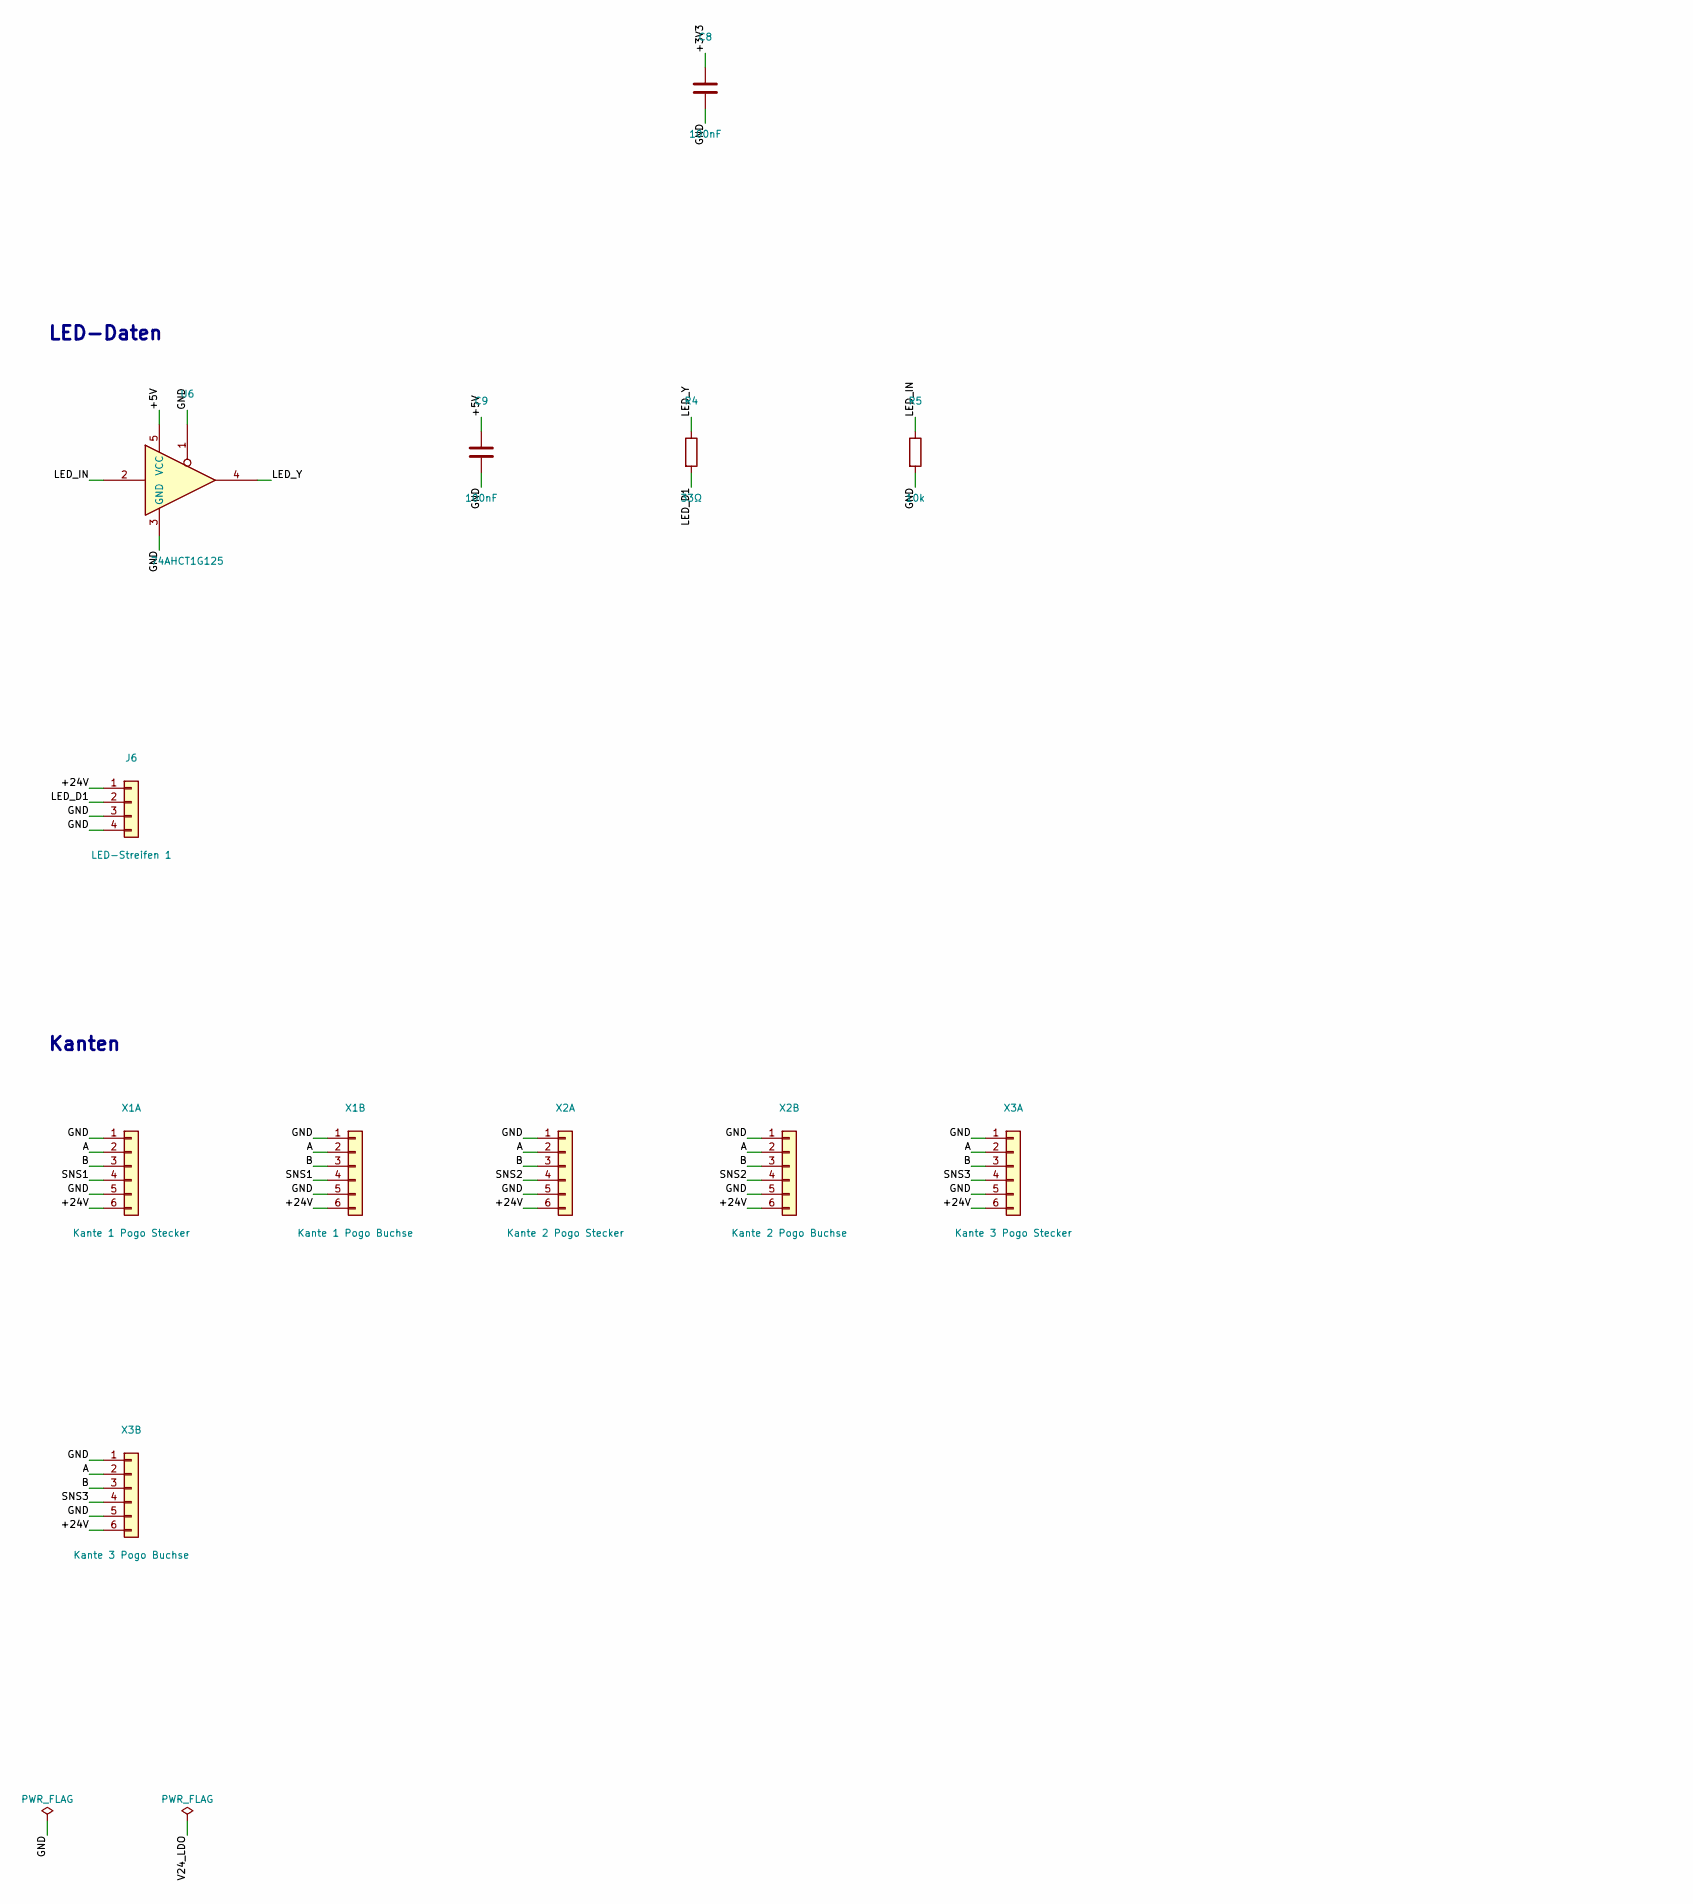
[picture p10: schematic trilumag-panel.kicad_sch, Trilumag Panel (Nebenplatine) Rev 0.3, part in row 2, column 1]

Parts:
C1: 10µF 50V; C_1206_3216Metric_Pad1.33x1.80mm_HandSolder
C2: 1µF 50V; C_0805_2012Metric_Pad1.18x1.45mm_HandSolder
C3, C6, C7: 1µF; C_0805_2012Metric_Pad1.18x1.45mm_HandSolder
C4, C5, C8, C9: 100nF; C_0805_2012Metric_Pad1.18x1.45mm_HandSolder
D1: SMBJ26A; D_SMB_Handsoldering
J3: LIS3DH-Modul; PinSocket_1x08_P2.54mm_Vertical
J5: SWD; PinHeader_1x03_P2.54mm_Vertical
J6: LED-Streifen 1; Kabel_4P_LED
R1, R2, R3: 100Ω; R_0805_2012Metric_Pad1.20x1.40mm_HandSolder
R4: 33Ω; R_0805_2012Metric_Pad1.20x1.40mm_HandSolder
R5: 10k; R_0805_2012Metric_Pad1.20x1.40mm_HandSolder
R6, R7: 4.7k; R_0805_2012Metric_Pad1.20x1.40mm_HandSolder
R8: 10Ω; R_1206_3216Metric_Pad1.30x1.75mm_HandSolder
U1: CH32V003F4P6; TSSOP-20_4.4x6.5mm_P0.65mm
U2: MAX3485; SOIC-8_3.9x4.9mm_P1.27mm
U3: 78L05; SOT-89-3_Handsoldering
U4: XC6206P332MR; SOT-23_Handsoldering
U6: 74AHCT1G125; SOT-23-5_HandSoldering
X1A: Kante 1 Pogo Stecker; Kabel_6P_Stecker
X1B: Kante 1 Pogo Buchse; Kabel_6P_Buchse
X2A: Kante 2 Pogo Stecker; Kabel_6P_Stecker
X2B: Kante 2 Pogo Buchse; Kabel_6P_Buchse
X3A: Kante 3 Pogo Stecker; Kabel_6P_Stecker
X3B: Kante 3 Pogo Buchse; Kabel_6P_Buchse

Connections:
+3V3: C4.1, C5.1, C7.1, C8.1, J3.1, J3.6, J5.3, R6.2, R7.2, U1.9 (VDD), U2.8 (VCC), U4.2 (VO)
+5V: C3.1, C6.1, C9.1, U3.1 (OUT), U4.3 (VI), U6.5 (VCC)
+24V: C1.1, D1.1 (A1), J6.1, R8.1, X1A.6, X1B.6, X2A.6, X2B.6, X3A.6, X3B.6
A: U2.6 (A), X1A.2, X1B.2, X2A.2, X2B.2, X3A.2, X3B.2
B: U2.7 (B), X1A.3, X1B.3, X2A.3, X2B.3, X3A.3, X3B.3
DE: U1.1 (PD4), U2.2 (~RE), U2.3 (DE)
GND: C1.2, C2.2, C3.2, C4.2, C5.2, C6.2, C7.2, C8.2, C9.2, D1.2 (A2), J3.2, J3.5, J5.2, J6.3, J6.4, R5.2, U1.7 (VSS), U2.5 (GND), U3.2 (GND), U4.1 (GND), U6.1, U6.3 (GND), X1A.1, X1A.5, X1B.1, X1B.5, X2A.1, X2A.5, X2B.1, X2B.5, X3A.1, X3A.5, X3B.1, X3B.5; also elsewhere on the board
LED_D1: J6.2, R4.2
LED_IN: R5.1, U1.16 (PC6), U6.2
LED_Y: R4.1, U6.4
RX: U1.3 (PD6), U2.1 (RO)
S1R: R1.1, U1.13 (PC3)
S2R: R2.1, U1.14 (PC4)
S3R: R3.1, U1.10 (PC0)
SCL: J3.3, R7.1, U1.12 (PC2)
SDA: J3.4, R6.1, U1.11 (PC1)
SNS1: R1.2, X1A.4, X1B.4
SNS2: R2.2, X2A.4, X2B.4
SNS3: R3.2, X3A.4, X3B.4
SWIO: J5.1, U1.18 (PD1)
TINT: J3.7, U1.19 (PD2)
TX: U1.2 (PD5), U2.4 (DI)
V24_LDO: C2.1, R8.2, U3.3 (IN)

Notes on the sheet:
Mikrocontroller
Versorgung
RS-485
Lagesensor
LED-Daten
Kanten
