mariofritzer/Trilumag/hardware/nebenplatine/trilumag-panel.kicad_pcb

## KiCad design hardware/nebenplatine/trilumag-panel.kicad_pcb (continued)

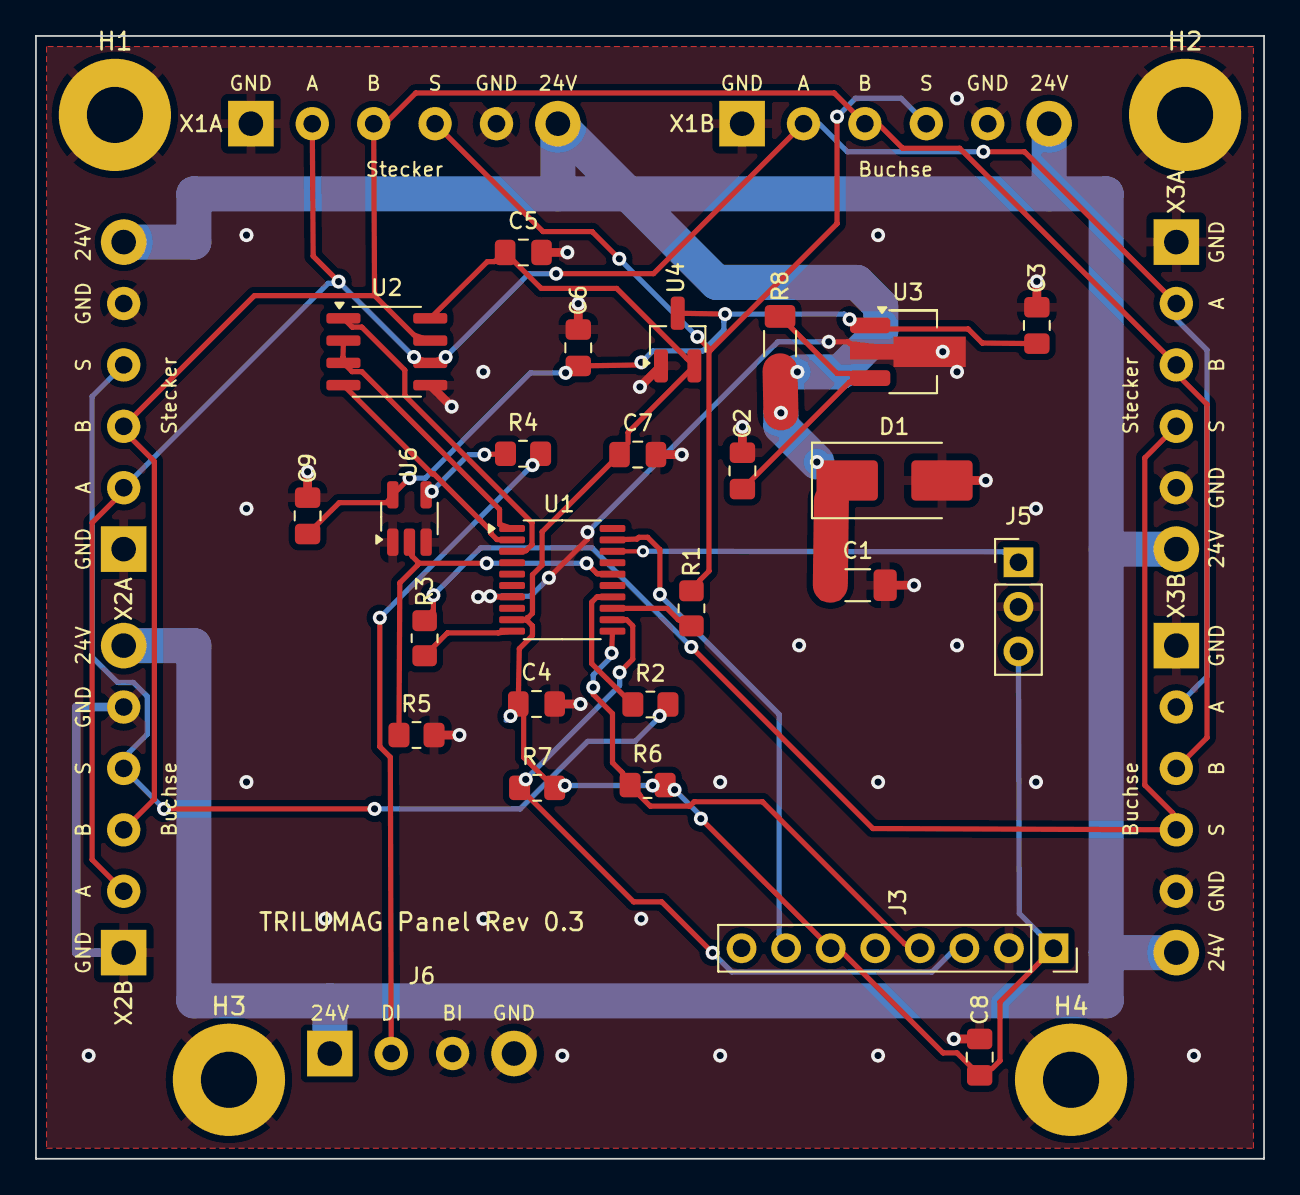
[picture p11: board trilumag-panel.kicad_pcb from above]

Board: 2 copper layers, 70.0 x 64.0 mm, 36 parts (0 on the bottom side), 23 nets.

Other parts of the board:
H1, H2, H3, H4: M3; MountingHole_3.2mm_M3_Pad

Their connections:
GND: H1.1, H2.1, H3.1, H4.1; also elsewhere on the board
