mariofritzer/Trilumag/firmware/trilumag/trilumag.ino

/*
  Trilumag – Firmware für das Hauptpanel, Version 0.4
  ---------------------------------------------------
  Läuft auf jedem ESP32 (klassischer ESP32, ESP32-S3, ESP32-C3, ESP32-C6).
  Am einfachsten über den Webinstaller: https://mariofritzer.github.io/Trilumag/

  Was sie kann:
   - WLAN-Einrichtung im Webinstaller (Improv) oder über das Setup-Netz "Trilumag-Setup"
   - Web-App unter http://trilumag.local
   - zwei Betriebsarten, umschaltbar in der App:
       Simulation: Panels werden in der App angeklipst
       Bus:        echte Panels über RS-485, Erkennung über die SNS-Leitungen (docs/protokoll.md)
   - Pinbelegung pro Board in der App einstellbar, mit Vorlagen und Prüfung
   - eigener WS2814-Strip des Hauptpanels
   - Effekte für die ganze Wand (Regenbogen, Atmen, Feuer …) mit Paletten und Intensität
   - Gesamthelligkeit und Ein/Aus für die ganze Wand, Presets (gespeicherte Szenen)
   - Web-App im Stil von WLED
   - Online-Updates von GitHub, auf Wunsch automatisch, auch Downgrades; Datei-Upload
   - Update-Absicherung: eine neue Version muss sich nach dem Start bewähren, sonst zurück zur alten
   - weiche Übergänge, Stromlimit (geschätzt oder mit Stromsensor INA226), Sichern und Wiederherstellen
   - Farben bleiben pro Panel (Chip-ID) gespeichert, auch über einen Neustart
   - HTTP-API und Home Assistant über MQTT mit Auto-Discovery, Broker in der App einstellbar

  Selbst kompilieren mit der Arduino IDE:
   - Boardverwalter: "esp32" von Espressif
   - Bibliotheken: ArduinoJson (ab 7), PubSubClient, Adafruit NeoPixel
   - ESP32-S3/C3/C6: "USB CDC On Boot" auf "Enabled" stellen
   - Partition Scheme: "Minimal SPIFFS (1.9MB APP with OTA)", sonst passen Online-Updates nicht
*/

#include <sys/time.h>
#include <WiFi.h>
#include <WebServer.h>
#include <ESPmDNS.h>
#include <Preferences.h>
#include <PubSubClient.h>
#include <ArduinoJson.h>
#include <Adafruit_NeoPixel.h>
#include <stdarg.h>
#include <math.h>
#include "webapp_gz.h"                  // die App (Quelle: webapp.h), gepackt
#include "improv.h"
#include "pins.h"
#include "ws.h"
#include "ota.h"
#include "zigbee.h"     // Philips Hue über Zigbee, nur ESP32-C6
#include "panel_fw.h"
#include "energy_types.h" // eigene Typen in einer Datei, sonst stolpern die automatischen Arduino-Prototypen   // aktuelle Panel-Firmware für Updates über den Bus (erzeugt beim Build)
#include <Wire.h>
#include <WiFiUdp.h>
#include <time.h>
#include "esp_system.h"
#include "esp_ota_ops.h"
#include "esp_timer.h"
#include <HTTPClient.h>

// ================= Voreinstellungen =================
// Alles hier lässt sich später in der App ändern. Diese Werte gelten nur, solange nichts gespeichert ist.
const char* WLAN_SSID = "";
const char* WLAN_PASS = "";
const uint8_t  MAX_ATTACHED = 30;     // höchstens so viele Panels an der Wand (inkl. Hauptpanel)
const uint32_t DETECT_MS    = 1200;   // simulierte Erkennungszeit nach dem Anklipsen
const uint32_t FX_JOIN_MS   = 5 * 1600; // bei laufendem Effekt pulsieren neue Panels erst 5-mal blau
// ====================================================

const char* FW_NAME    = "Trilumag";
const char* FW_VERSION = "0.7.0";   // die dritte Stelle setzt der Build
const char* HOSTNAME   = "trilumag";
const char* SETUP_SSID = "Trilumag-Setup";
const char* SETUP_PASS = "trilumag";

#if CONFIG_IDF_TARGET_ESP32S3
const char* CHIP_FAMILY = "ESP32-S3";
#elif CONFIG_IDF_TARGET_ESP32C3
const char* CHIP_FAMILY = "ESP32-C3";
#elif CONFIG_IDF_TARGET_ESP32S2
const char* CHIP_FAMILY = "ESP32-S2";
#elif CONFIG_IDF_TARGET_ESP32C6
const char* CHIP_FAMILY = "ESP32-C6";
#else
const char* CHIP_FAMILY = "ESP32";
#endif

// Zweiter Konsolenanschluss nur beim S3 (dort hat das DevKit eine eigene UART-Buchse)
#if ARDUINO_USB_CDC_ON_BOOT && CONFIG_IDF_TARGET_ESP32S3
#define HAS_UART_CONSOLE 1
#else
#define HAS_UART_CONSOLE 0
#endif

const uint8_t SLOTS = 40;             // Wand + Ablage

enum Dir : uint8_t { BOTTOM, RIGHT, LEFT, TOP };
// Kanten jedes Panels gegen den Uhrzeigersinn: Kante 1 unten, Kante 2 rechts, Kante 3 links (Spitze oben)
const Dir UP_EDGES[3]   = {BOTTOM, RIGHT, LEFT};
const Dir DOWN_EDGES[3] = {TOP, LEFT, RIGHT};

enum State : uint8_t { DARK = 0, PULSE = 1, ACTIVE = 2 };

struct Panel {
  bool used = false;
  bool attached = false;
  uint32_t chip = 0;
  int8_t x = 0, y = 0;
  uint8_t rot = 0;        // welche Weltkante die eigene Kante 1 ist
  int8_t parent = -1;
  uint8_t depth = 0;      // Schritte bis zum Hauptpanel
  uint8_t addr = 0;       // Kurzadresse auf dem Bus (nur Busbetrieb)
  uint8_t miss = 0;       // verpasste Antworten in Folge
  // Diagnose
  uint32_t pings = 0, missed = 0;   // Abfragen und verpasste Antworten seit dem Anklipsen
  uint16_t rtt = 0, rttMax = 0;     // Antwortzeit in µs (zuletzt, höchste)
  uint8_t fw = 0;                   // Firmware-Version des Panels (aus PING)
  uint16_t attaches = 0;            // wie oft seit dem Start erkannt
  uint32_t clips = 0;               // wie oft insgesamt angeklipst (dauerhaft gespeichert)
  uint8_t caps = 0;                 // vom Panel gemeldet: 1 = Touch-Sensor, 2 = Bootloader
  uint8_t touchSeq = 0; bool touchKnown = false;
  uint8_t upd = 0, updPct = 0, updFails = 0;   // Panel-Update: 0 nichts, 1 wartet, 2 läuft, 3 fehlgeschlagen
  uint32_t identUntil = 0;          // Panel finden: blinkt bis hierher weiß
  uint32_t litSec = 0, litSaved = 0;   // Betriebsstunden: so lange hat das Panel insgesamt geleuchtet (s)
  bool edges = false;               // Kanten einzeln: Effekte bekommen drei Farben pro Panel
  uint8_t state = DARK;
  uint32_t since = 0;
  uint32_t joinAt = 0;    // bei laufendem Effekt: bis hierher noch blau pulsieren (0 = nicht)
  bool hasColor = false;
  bool on = true;
  uint8_t r = 0, g = 0, b = 0, w = 0, bri = 255;
};

struct Config {
  bool bus = false;
  String board;
  PinSet pins;
  String order = "RGBW";
  bool autoUpdate = false; // Häkchen "Automatisch aktualisieren"
  uint16_t transMs = 700;   // Dauer weicher Übergänge
  uint16_t pwrMax = 0;      // Stromlimit in mA (0 = aus)
  uint8_t pwrCh = 12;       // mA pro Farbkanal und LED-Segment bei voller Helligkeit (WS2814 24V)
  int8_t i2cSda = -1, i2cScl = -1;   // Stromsensor INA226 (optional)
  uint16_t shuntUo = 50;    // Shunt in 0,1 mΩ (50 = 5 mΩ)
  bool mqttOn = false;     // Häkchen "MQTT aktiv"; Zugangsdaten bleiben auch ausgeschaltet gespeichert
  bool touchOn = true;      // Antippen der Panels (Beschleunigungssensor)
  uint8_t touchSens = 5;    // Empfindlichkeit 1 bis 10
  uint8_t tapA1 = 1, tapA2 = 2;   // Aktion für einmal und doppelt antippen (TapAction)
  bool panelAuto = true;    // Panels mit älterer Firmware automatisch aktualisieren
  bool zbOn = false;        // Zigbee für die Hue Bridge (nur ESP32-C6)
  String name = "Trilumag"; // Name der Wand: App, Home Assistant, WLED-Programme
  uint8_t bootMode = 0;     // nach Stromausfall: 0 wie vorher, 1 aus, 2 an, 3 Preset
  int8_t bootPreset = -1;
  bool syncOn = false;      // mit anderen Wänden im selben WLAN im Gleichtakt
  bool guard = true;        // Wächter: WLAN weg oder Hauptschleife hängt → neu verbinden bzw. neu starten
  uint8_t onAnim = 2;       // Einschalt-Animation: 0 aus, 1 langsam, 2 mittel, 3 schnell
  bool touchWave = true;    // Welle über die Wand beim Antippen
  bool daylight = false;    // Tageslicht-Kurve: abends wärmer und dunkler
  bool faultBlink = true;   // Störung (WLAN weg, Panel antwortet nicht): Hauptpanel blinkt kurz
  uint16_t viewRot = 0;     // so hängt die Wand: Drehung in Grad (Vielfache von 30), wirkt in App und Effekten
  bool viewMir = false;
  uint8_t syncGroup = 1;    // nur Wände derselben Gruppe (1 bis 9) laufen zusammen
  String mqttHost;
  uint16_t mqttPort = 1883;
  String mqttUser, mqttPass;
};

// Effekt für die ganze Wand (Liste FX[] weiter unten)
struct FxCfg { uint8_t id = 0, speed = 50, bri = 180, r = 255, g = 120, b = 30, w = 0, pal = 0, inten = 128; };

Panel P[SLOTS];
Config cfg;
FxCfg fx;
uint8_t master = 255;          // Gesamthelligkeit der Wand
bool masterOn = true;          // Ein/Aus der ganzen Wand
int8_t curPreset = -1;         // zuletzt geladenes Preset, -1 = keins oder verändert
uint8_t masterK() { return masterOn ? master : 0; }
// Der WebServer bedient nur eine Verbindung nach der anderen und wartet auf eine leere Verbindung
// bis zu 5 s. Browser öffnen solche Verbindungen gern auf Vorrat, dann hängt die App.
// Hier wird eine Verbindung, die nach 200 ms noch nichts geschickt hat, sofort freigegeben.
class AppServer : public WebServer {
public:
  using WebServer::WebServer;
  void handleClient() override {
    if (_currentStatus == HC_WAIT_READ && !_currentClient.available() && millis() - _statusChange > 200) {
      _currentClient.stop();
      _currentClient = NetworkClient();
      _currentStatus = HC_NONE;
    }
    WebServer::handleClient();
  }
};
AppServer server(80);
WiFiClient netClient;
PubSubClient mqtt(netClient);
Preferences prefs;
Adafruit_NeoPixel strip(3, -1, NEO_RGBW + NEO_KHZ800);
improv::Parser improvMain;
#if HAS_UART_CONSOLE
improv::Parser improvUart;
#endif
// WLAN-Verbindung im Hintergrund (siehe wifiLoop)
enum WifiPhase : uint8_t { W_IDLE, W_CONNECTING };
WifiPhase wPhase = W_IDLE;
uint32_t wDeadline = 0;
String wSsid, wPass;
bool wImprov = false;          // Verbindungsversuch kam aus dem Webinstaller
bool wSaveLate = false;        // verbindet es sich doch noch, die Zugangsdaten trotzdem speichern
Stream* wImprovStream = nullptr;
uint32_t lastMqttTry = 0, lastPoll = 0, lastDiscover = 0, colorsDirtyAt = 0;
bool wlanOk = false, apMode = false, colorsDirty = false;
uint8_t discoverRound = 0;

// ---------- Ausgabe ----------
void logf(const char* fmt, ...) {
  char b[320];
  va_list a; va_start(a, fmt); vsnprintf(b, sizeof b, fmt, a); va_end(a);
  Serial.print(b);
#if HAS_UART_CONSOLE
  Serial0.print(b);
#endif
}

// ---------- Diagnose: Zähler und Ereignisprotokoll ----------
struct DiagEvent { uint32_t t; char m[80]; };
const uint8_t DIAG_N = 40;
DiagEvent diagLogBuf[DIAG_N];
uint8_t diagHead = 0, diagCount = 0;
uint32_t busFramesSent = 0, busCrcErr = 0, busTimeouts = 0, busDiscovers = 0;
// schreibt ins serielle Log und ins Ereignisprotokoll der App
void diag(const char* fmt, ...) {
  char b[80];
  va_list a; va_start(a, fmt); vsnprintf(b, sizeof b, fmt, a); va_end(a);
  logf("%s\n", b);
  DiagEvent& e = diagLogBuf[diagHead];
  e.t = millis(); strncpy(e.m, b, sizeof e.m - 1); e.m[sizeof e.m - 1] = 0;
  diagHead = (diagHead + 1) % DIAG_N; if (diagCount < DIAG_N) diagCount++;
}

// Neustart-Grund: überlebt einen Software-Neustart im RTC-Speicher
RTC_NOINIT_ATTR uint32_t rstMagic, rstCode;
enum RstCode : uint8_t { R_NONE, R_UPDATE, R_APP, R_WLAN, R_HANG };
void restartWith(uint8_t code) { rstMagic = 0x7121A600; rstCode = code; ESP.restart(); }
String bootReason;                         // lesbar für Diagnose und Info
uint32_t loopBeat = 0;

void saveWifi(const String& ss, const String& pw);
void wifiStart(const String& ss, const String& pw, uint32_t timeout, bool fromImprov);
void startSetupAp();
void publishDiscovery(int i);
void publishAvail(int i, bool online);
void publishState(int i);
void publishFx();
void publishExtras();

// ---------- Raster ----------
bool isUp(int x, int y) { return ((((x + y) % 2) + 2) % 2) == 0; }
const Dir* slotEdges(bool up) { return up ? UP_EDGES : DOWN_EDGES; }
Dir worldDir(const Panel& p, uint8_t e) { return slotEdges(isUp(p.x, p.y))[(e + p.rot) % 3]; }
Dir opposite(Dir d) {
  switch (d) { case BOTTOM: return TOP; case TOP: return BOTTOM; case RIGHT: return LEFT; default: return RIGHT; }
}
void neighbor(int x, int y, Dir d, int& nx, int& ny) {
  nx = x; ny = y;
  if (d == BOTTOM) ny++; else if (d == TOP) ny--; else if (d == RIGHT) nx++; else nx--;
}
bool hasConnector(int i, uint8_t e) { return !(i == 0 && e == 0); }   // Hauptpanel: unten flach
int findAt(int x, int y) {
  for (int i = 0; i < SLOTS; i++) if (P[i].used && P[i].attached && P[i].x == x && P[i].y == y) return i;
  return -1;
}
int findChip(uint32_t c) {
  for (int i = 0; i < SLOTS; i++) if (P[i].used && P[i].chip == c) return i;
  return -1;
}
int findAddr(uint8_t a) {
  for (int i = 1; i < SLOTS; i++) if (P[i].used && P[i].attached && P[i].addr == a) return i;
  return -1;
}
int edgeFacing(int i, Dir d) {
  for (uint8_t e = 0; e < 3; e++) if (worldDir(P[i], e) == d) return e;
  return -1;
}
// Mitte von Kante e des Panels i (Seitenlänge 1) und ob sie zum Elternpanel zeigt: dd -0,33 (Eingang) oder +0,17
void edgePos(int i, int e, float& x, float& y, float& dd) {
  const Panel& p = P[i]; float dx = 0, dy = 0; dd = 0;
  if (e >= 0) {
    Dir w = worldDir(p, e);
    if (w == BOTTOM) dy = 0.289f; else if (w == TOP) dy = -0.289f;
    else { dx = w == RIGHT ? 0.25f : -0.25f; dy = isUp(p.x, p.y) ? -0.144f : 0.144f; }
    int nx, ny; neighbor(p.x, p.y, w, nx, ny);
    dd = (p.parent >= 0 && P[p.parent].x == nx && P[p.parent].y == ny) ? -0.33f : 0.17f;
  }
  x = p.x * 0.5f + dx; y = p.y * 0.866f + dy;
}
int countAttached() { int n = 0; for (int i = 0; i < SLOTS; i++) if (P[i].used && P[i].attached) n++; return n; }
String hex(uint32_t c) { char b[9]; snprintf(b, sizeof b, "%08X", c); return String(b); }
uint32_t parseHex(const char* s) { return (uint32_t)strtoul(s, nullptr, 16); }

// ---------- Farben dauerhaft merken ----------
void loadColor(int i) {
  P[i].edges = prefs.getBool(("e" + hex(P[i].chip)).c_str(), false);
  uint8_t c[6];
  if (prefs.getBytes(("c" + hex(P[i].chip)).c_str(), c, 6) == 6) {
    P[i].r = c[0]; P[i].g = c[1]; P[i].b = c[2]; P[i].w = c[3]; P[i].bri = c[4]; P[i].on = c[5];
    P[i].hasColor = true;
  }
}
void saveColors() {
  for (int i = 0; i < SLOTS; i++) {
    if (!P[i].used || !P[i].hasColor) continue;
    uint8_t c[6] = {P[i].r, P[i].g, P[i].b, P[i].w, P[i].bri, (uint8_t)P[i].on}, o[6];
    String k = "c" + hex(P[i].chip);
    if (prefs.getBytes(k.c_str(), o, 6) == 6 && !memcmp(c, o, 6)) continue;
    prefs.putBytes(k.c_str(), c, 6);
  }
  colorsDirty = false;
}

// ---------- Farbreihenfolge der LEDs ----------
const char* ORDERS[] = {"RGBW", "GRBW", "BRGW", "BGRW", "WRGB", "WGRB"};
uint16_t neoType(const String& o) {
  if (o == "GRBW") return NEO_GRBW;
  if (o == "BRGW") return NEO_BRGW;
  if (o == "BGRW") return NEO_BGRW;
  if (o == "WRGB") return NEO_WRGB;
  if (o == "WGRB") return NEO_WGRB;
  return NEO_RGBW;
}
void orderBytes(const String& o, uint8_t* out) {
  for (int k = 0; k < 4; k++) {
    char c = k < (int)o.length() ? o[k] : 'W';
    out[k] = c == 'R' ? 0 : c == 'G' ? 1 : c == 'B' ? 2 : 3;
  }
}

// ---------- Bus ----------
namespace bus {
const uint8_t SYNC = 0xA5, ALL = 0x00, BYID = 0x7F, REPLY = 0x80;
enum { C_PING = 0x01, C_COLOR = 0x02, C_EDGES = 0x03, C_FRAME = 0x04, C_PULSE = 0x05, C_ORDER = 0x06, C_FRAME3 = 0x07,
       C_TOUCH = 0x08,
       C_BEACON = 0x10, C_DISCOVER = 0x11, C_PROBE = 0x12, C_ASSIGN = 0x14, C_RESET = 0x15,
       C_BOOT = 0x20, BL_INFO = 0x21, BL_WRITE = 0x22, BL_DONE = 0x23, BL_SCAN = 0x24, BL_RUN = 0x25 };
enum { CAP_TOUCH = 1, CAP_BOOT = 2 };

HardwareSerial& port = Serial1;

uint8_t crc8(uint8_t c, uint8_t b) {
  c ^= b;
  for (int i = 0; i < 8; i++) c = (c & 0x80) ? (uint8_t)((c << 1) ^ 0x07) : (uint8_t)(c << 1);
  return c;
}

void send(uint8_t addr, uint8_t cmd, const uint8_t* d = nullptr, uint8_t len = 0) {
  while (port.available()) port.read();
  uint8_t buf[210]; uint8_t n = 0, c = 0;
  buf[n++] = SYNC; buf[n++] = addr; buf[n++] = cmd; buf[n++] = len;
  if (len) { memcpy(buf + n, d, len); n += len; }
  for (int i = 1; i < n; i++) c = crc8(c, buf[i]);
  buf[n++] = c;
  port.write(buf, n);
  port.flush();
}

void sendById(uint32_t chip, uint8_t cmd, uint8_t extra) {
  uint8_t d[5] = {(uint8_t)chip, (uint8_t)(chip >> 8), (uint8_t)(chip >> 16), (uint8_t)(chip >> 24), extra};
  send(BYID, cmd, d, 5);
}

struct Reply { uint8_t addr, cmd, len; uint8_t data[200]; };

// Wartet auf eine gültige Antwort; true, wenn eine kam
bool receive(Reply& r, uint32_t timeoutMs) {
  uint8_t f[206]; uint16_t pos = 0;
  uint32_t t0 = millis();
  while (millis() - t0 < timeoutMs) {
    while (port.available()) {
      uint8_t b = port.read();
      if (pos == 0 && b != SYNC) continue;
      f[pos++] = b;
      if (pos == 4 && f[3] > 200) { pos = 0; continue; }
      if (pos >= 4 && pos == 5 + f[3]) {
        uint8_t c = 0;
        for (int i = 1; i < pos - 1; i++) c = crc8(c, f[i]);
        if (c == f[pos - 1] && (f[1] & REPLY)) {
          r.addr = f[1] & 0x7F; r.cmd = f[2]; r.len = f[3]; memcpy(r.data, f + 4, f[3]);
          return true;
        }
        if (c != f[pos - 1]) busCrcErr++;          // gestörte Übertragung
        pos = 0;
      }
    }
    delay(0);
  }
  return false;
}

// Eigene SNS-Pins des Hauptpanels: Leuchtfeuer (Low) oder Fühler (Pull-up)
void ownBeacon(bool on) {
  int8_t pins[2] = {cfg.pins.snsR, cfg.pins.snsL};
  for (int8_t p : pins) {
    if (on) { pinMode(p, OUTPUT); digitalWrite(p, LOW); }
    else pinMode(p, INPUT_PULLUP);
  }
}

void beacons(bool on) {
  uint8_t v = on;
  send(ALL, C_BEACON, &v, 1);
  ownBeacon(on);
}

void sendColor(int i) {
  const Panel& p = P[i];
  if (!p.addr) return;
  if (p.state == ::PULSE) { send(p.addr, C_PULSE); return; }
  uint8_t c[4] = {0, 0, 0, 0};
  if (p.on && p.state == ::ACTIVE) {
    uint32_t k = (uint32_t)p.bri * masterK();
    c[0] = p.r * k / 65025; c[1] = p.g * k / 65025; c[2] = p.b * k / 65025; c[3] = p.w * k / 65025;
  }
  send(p.addr, C_COLOR, c, 4);
}

void sendOrder(uint8_t addr) {
  uint8_t o[4]; orderBytes(cfg.order, o);
  send(addr, C_ORDER, o, 4);
}

// Empfindlichkeit 1..10 als Schwelle des Sensors (16 mg je Schritt), 0 = aus
uint8_t touchThreshold() { return cfg.touchOn ? 66 - 6 * constrain((int)cfg.touchSens, 1, 10) : 0; }
void sendTouch(uint8_t addr) { uint8_t t = touchThreshold(); send(addr, C_TOUCH, &t, 1); }

void begin() {
  port.begin(250000, SERIAL_8N1, cfg.pins.rx, cfg.pins.tx);
  port.setPins(cfg.pins.rx, cfg.pins.tx, -1, cfg.pins.de);
  port.setMode(UART_MODE_RS485_HALF_DUPLEX);
  delay(50);
  send(ALL, C_RESET);
  delay(5);
  sendOrder(ALL);
  sendTouch(ALL);
  beacons(true);
  logf("[BUS] gestartet: RX %d, TX %d, DE %d, SNS rechts %d, SNS links %d\n",
       cfg.pins.rx, cfg.pins.tx, cfg.pins.de, cfg.pins.snsR, cfg.pins.snsL);
}
}  // namespace bus

void reconcile();
void simChanged();
bool timeOk();
bool safeBoot = false;         // nach wiederholten Abstürzen beim Start: Netz-Nachahmen nicht starten
uint32_t faultPanelAt = 0;     // wann zuletzt ein Panel nicht mehr geantwortet hat
// Während Updates ruhen die Abfragen an Hue und WLED: zwei verschlüsselte Verbindungen gleichzeitig brauchen zu viel Speicher
volatile bool netQuiet = false, hueInReq = false, wledInReq = false;
volatile bool otaBusy = false;   // Installation läuft: alle Verbindungen nach außen getrennt (MQTT, Hue, WLED, Wetter, Suche)
void netQuietOn() { netQuiet = true; for (int i = 0; i < 600 && (hueInReq || wledInReq); i++) delay(10); }
namespace wx { extern String place, err; extern volatile bool busy; void json(JsonObject o); }
namespace mirror { extern String ip; void json(JsonObject o); }
namespace hueb { void json(JsonObject o); void closeConn(); }
extern bool outForce, testMode;
void transition();
bool placePanel(int i, int parent, uint8_t edge, uint8_t own);

// ---------- Anklips-Zähler (dauerhaft im NVS, je Chip-ID) ----------
String clipKey(uint32_t chip) { return "n" + hex(chip); }
void clipsLoad(int i) { P[i].clips = prefs.getUInt(clipKey(P[i].chip).c_str(), 0); }
void clipCount(int i) { P[i].clips++; prefs.putUInt(clipKey(P[i].chip).c_str(), P[i].clips); }
// Beim Einschalten der ganzen Wand melden sich alle Panels als frisch versorgt. Das ist kein Anklipsen:
// Bis 5 s nach dem letzten gefundenen Panel (mindestens 15 s nach dem Start) wird nicht gezählt.
uint32_t busQuietUntil = 15000;

namespace pupd { bool busy(uint32_t chip); void loop(); }
void touchEvent(int i, uint8_t kind);
void wsKick();
void litLoad(int i);
extern uint32_t sleepEnd; uint32_t sleepLeft();
namespace wallsync { void json(JsonObject o); extern uint32_t lastSig; }

// Neues Panel gefunden: Nachbarn orten, Adresse vergeben, Farbe oder Pulsieren
void busHandleNew(uint32_t chip, uint8_t mask) {
  if (pupd::busy(chip)) return;                // startet gerade nach einem Update neu, bekommt seine alte Adresse
  int i = findChip(chip);
  if (i >= 0 && P[i].attached) { P[i].attached = false; P[i].addr = 0; }   // Panel wurde neu gestartet
  if (i < 0) {
    for (int k = 1; k < SLOTS; k++) if (!P[k].used) { i = k; break; }
    if (i < 0) { logf("[BUS] kein Platz mehr für %s\n", hex(chip).c_str()); return; }
    P[i] = Panel(); P[i].used = true; P[i].chip = chip;
    loadColor(i); clipsLoad(i); litLoad(i);
  }
  if (countAttached() >= MAX_ATTACHED) { logf("[BUS] Höchstzahl erreicht, %s wird ignoriert\n", hex(chip).c_str()); return; }

  int parent = -1, parentEdge = -1, ownEdge = -1;
  bus::beacons(false);
  delay(2);
  for (uint8_t k = 0; k < 3 && parent < 0; k++) {
    if (!(mask & (1 << k))) continue;
    bus::sendById(chip, bus::C_PROBE, k);
    bus::Reply r;
    if (!bus::receive(r, 5)) continue;
    delay(1);
    if (digitalRead(cfg.pins.snsR) == LOW) { parent = 0; parentEdge = 1; ownEdge = k; break; }
    if (digitalRead(cfg.pins.snsL) == LOW) { parent = 0; parentEdge = 2; ownEdge = k; break; }
    for (int j = 1; j < SLOTS && parent < 0; j++) {
      if (!P[j].used || !P[j].attached || !P[j].addr) continue;
      bus::send(P[j].addr, bus::C_PING);
      if (bus::receive(r, 4) && r.addr == P[j].addr && r.len >= 2 && r.data[1]) {
        for (uint8_t e = 0; e < 3; e++) if (r.data[1] & (1 << e)) { parent = j; parentEdge = e; ownEdge = k; break; }
      }
    }
  }
  bus::sendById(chip, bus::C_PROBE, 0xFF);
  { bus::Reply r; bus::receive(r, 5); }
  bus::beacons(true);

  if (parent < 0) { diag("Panel %s meldet Kontakt, Nachbar nicht gefunden (SNS prüfen)", hex(chip).substring(4).c_str()); return; }

  uint8_t addr = 0;
  for (uint8_t a = 1; a <= 0x3E; a++) if (findAddr(a) < 0) { addr = a; break; }
  if (!addr || !placePanel(i, parent, parentEdge, ownEdge)) {
    diag("Panel %s lässt sich nicht einordnen", hex(chip).substring(4).c_str()); return;
  }
  bus::sendById(chip, bus::C_ASSIGN, addr);
  bus::Reply r;
  if (!bus::receive(r, 5) || r.addr != addr) {
    diag("Panel %s hat die Adresse nicht bestätigt", hex(chip).substring(4).c_str());
    P[i].attached = false; reconcile(); return;
  }
  bool fresh = r.len >= 1 ? r.data[0] : true;   // Panel-Firmware ab 3: 1 = gerade erst Strom bekommen
  P[i].addr = addr; P[i].miss = 0; P[i].touchKnown = false;
  P[i].joinAt = (millis() + FX_JOIN_MS) | 1;
  bus::sendOrder(addr);
  bus::sendTouch(addr);
  if ((int32_t)(millis() - busQuietUntil) < 0) busQuietUntil = millis() + 5000;
  else if (fresh) clipCount(i);
  P[i].state = P[i].hasColor ? ACTIVE : PULSE;
  P[i].since = millis();
  transition();                       // weich einblenden, das nächste Bild enthält das neue Panel
  diag("Panel %s an Kante %d von %s (eigene Kante %d), Adresse %u", hex(chip).substring(4).c_str(), parentEdge + 1,
       parent == 0 ? "Haupt" : hex(P[parent].chip).substring(4).c_str(), ownEdge + 1, addr);
  P[i].pings = P[i].missed = 0; P[i].rttMax = 0; P[i].attaches++;
  publishDiscovery(i); publishAvail(i, true); publishState(i);
}

void busLoop() {
  uint32_t now = millis();
  if (now - lastPoll > 150) {
    lastPoll = now;
    bool lost = false;
    for (int i = 1; i < SLOTS; i++) {
      Panel& p = P[i];
      if (!p.used || !p.attached || !p.addr || p.upd == 2) continue;   // während des Updates im Bootloader
      uint32_t t0 = micros();
      bus::send(p.addr, bus::C_PING);
      bus::Reply r;
      p.pings++;
      if (bus::receive(r, 4) && r.addr == p.addr) {
        p.miss = 0;
        uint32_t us = micros() - t0; p.rtt = us > 65535 ? 65535 : us; if (p.rtt > p.rttMax) p.rttMax = p.rtt;
        if (r.len >= 3) p.fw = r.data[2];
        if (r.len >= 5) {                       // ab Panel-Firmware 3: Antippen und Fähigkeiten
          p.caps = r.data[4];
          if (p.touchKnown && r.data[3] != p.touchSeq && (r.data[3] & 3)) touchEvent(i, r.data[3] & 3);
          p.touchSeq = r.data[3]; p.touchKnown = true;
        }
        if (r.len >= 1 && r.data[0] == DARK && p.state != DARK) outForce = true;   // Panel hat Zustand verloren: alles neu schicken   // Panel hat Zustand verloren
      } else if (p.missed++, busTimeouts++, ++p.miss >= 3) {
        diag("Panel %s antwortet nicht mehr, gilt als abgeklipst", hex(p.chip).substring(4).c_str());
        faultPanelAt = millis() | 1;
        bus::send(p.addr, bus::C_RESET);
        p.attached = false; p.addr = 0; p.state = DARK; publishAvail(i, false); lost = true;
      }
    }
    if (lost) reconcile();
  }
  if (now - lastDiscover > 400 && countAttached() < MAX_ATTACHED) {
    lastDiscover = now;
    const uint8_t slots = 8;
    uint8_t d[2] = {++discoverRound, slots};
    busDiscovers++;
    bus::send(bus::ALL, bus::C_DISCOVER, d, 2);
    uint32_t found[8]; uint8_t masks[8]; uint8_t n = 0;
    uint32_t t0 = millis();
    bus::Reply r;
    while (n < 8) {
      uint32_t el = millis() - t0;
      if (el >= (uint32_t)slots + 4) break;
      if (bus::receive(r, slots + 4 - el) && r.cmd == bus::C_DISCOVER && r.len >= 5) {
        found[n] = (uint32_t)r.data[0] | ((uint32_t)r.data[1] << 8) | ((uint32_t)r.data[2] << 16) | ((uint32_t)r.data[3] << 24);
        masks[n++] = r.data[4];
      }
    }
    for (uint8_t k = 0; k < n; k++) busHandleNew(found[k], masks[k]);
  }
  pupd::loop();
}

// ---------- Panel-Updates über den Bus ----------
// Das Hauptpanel trägt die aktuelle Panel-Firmware (panel_fw.h) in sich. Ein Panel mit älterer Version
// springt auf BOOT in seinen Bootloader, bekommt die Firmware Seite für Seite (64 Bytes) und startet neu.
// Danach bekommt es seine alte Adresse zurück, ohne Neuerkennung. Panels, die nach einem abgebrochenen Update
// im Bootloader hängen, melden sich auf BL_SCAN und werden automatisch neu bespielt.
namespace pupd {
enum Step : uint8_t { IDLE, ENTER, INFO, WRITE, DONE, ASSIGN, SIM };
struct Job { int8_t i = -1; uint32_t chip = 0; uint8_t addr = 0; Step step = IDLE; uint16_t page = 0; uint8_t tries = 0; uint32_t at = 0; bool rescue = false; };
Job job;
uint32_t lastScan = 0;
uint8_t scanRound = 0;

bool busy(uint32_t chip) { return job.step != IDLE && job.chip == chip; }
bool canUpdate(const Panel& p) {
  if (!p.used || !p.attached || !p.fw || p.fw >= PANEL_FW_VERSION) return false;
  return cfg.bus ? (p.caps & bus::CAP_BOOT) && p.addr : true;
}

void sendBl(uint32_t chip, uint8_t cmd, const uint8_t* extra, uint8_t n) {
  uint8_t d[4 + 65] = {(uint8_t)chip, (uint8_t)(chip >> 8), (uint8_t)(chip >> 16), (uint8_t)(chip >> 24)};
  if (n) memcpy(d + 4, extra, n);
  bus::send(bus::BYID, cmd, d, 4 + n);
}

void end(bool ok, const char* why) {
  int i = job.i;
  String name = hex(job.chip).substring(4);
  if (i >= 0) {
    P[i].upd = ok ? 0 : 3; P[i].updPct = ok ? 100 : 0; P[i].miss = 0;
    if (!ok) P[i].updFails++;
    if (ok && !cfg.bus) { P[i].fw = PANEL_FW_VERSION; prefs.putUChar(("f" + hex(P[i].chip)).c_str(), PANEL_FW_VERSION); }
  }
  if (ok) diag("Panel %s hat jetzt Firmware %u", name.c_str(), PANEL_FW_VERSION);
  else diag("Update von Panel %s fehlgeschlagen: %s", name.c_str(), why);
  job = Job();
  wsKick();
}

void start(int i) {
  job = Job(); job.i = i; job.chip = P[i].chip; job.addr = P[i].addr;
  job.step = cfg.bus ? ENTER : SIM; job.at = millis();
  P[i].upd = 2; P[i].updPct = 0;
  diag("Panel %s: Update auf Firmware %u beginnt", hex(P[i].chip).substring(4).c_str(), PANEL_FW_VERSION);
}

// Ein Schritt pro Aufruf, damit App und Effekte weiterlaufen
void step() {
  if ((int32_t)(millis() - job.at) < 0) return;
  bus::Reply r;
  switch (job.step) {
  case IDLE: return;
  case SIM:                                          // Simulation: gleiche Dauer wie am Bus, etwa 15 ms pro Seite
    job.at = millis() + 15;
    if (++job.page >= PANEL_FW_PAGES) end(true, nullptr);
    break;
  case ENTER:
    bus::send(job.addr, bus::C_BOOT);
    if (bus::receive(r, 5) && r.cmd == bus::C_BOOT && r.len >= 1) {
      if (!r.data[0]) { end(false, "kein Bootloader"); return; }
      job.step = INFO; job.tries = 0; job.at = millis() + 30;
    } else if (++job.tries > 5) end(false, "antwortet nicht");
    return;
  case INFO:
    sendBl(job.chip, bus::BL_INFO, nullptr, 0);
    if (bus::receive(r, 5) && r.cmd == bus::BL_INFO) { job.step = WRITE; job.page = 0; job.tries = 0; }
    else if (++job.tries > 50) end(false, "Bootloader meldet sich nicht");
    else job.at = millis() + 20;
    return;
  case WRITE: {
    uint8_t d[65]; d[0] = job.page;
    memcpy(d + 1, PANEL_FW + job.page * 64, 64);
    sendBl(job.chip, bus::BL_WRITE, d, 65);
    if (bus::receive(r, 30) && r.cmd == bus::BL_WRITE && r.len >= 1 && r.data[0]) { job.page++; job.tries = 0; }
    else if (++job.tries > 5) { end(false, "Schreiben fehlgeschlagen"); return; }
    if (job.page >= PANEL_FW_PAGES) { job.step = DONE; job.tries = 0; }
    break;
  }
  case DONE: {
    uint8_t d[4] = {(uint8_t)PANEL_FW_PAGES, (uint8_t)PANEL_FW_CRC, (uint8_t)(PANEL_FW_CRC >> 8), PANEL_FW_VERSION};
    sendBl(job.chip, bus::BL_DONE, d, 4);
    if (bus::receive(r, 60) && r.cmd == bus::BL_DONE && r.len >= 1 && r.data[0]) {
      if (job.rescue) { end(true, nullptr); return; }  // ohne bekannte Adresse: die normale Erkennung übernimmt
      job.step = ASSIGN; job.tries = 0; job.at = millis() + 30;
    } else if (++job.tries > 3) end(false, "Prüfsumme passt nicht");
    return;
  }
  case ASSIGN:                                       // neue Firmware läuft: alte Adresse zurück
    bus::sendById(job.chip, bus::C_ASSIGN, job.addr);
    if (bus::receive(r, 5) && r.cmd == bus::C_ASSIGN && r.addr == job.addr) {
      bus::sendOrder(job.addr); bus::sendTouch(job.addr);
      if (job.i >= 0) { P[job.i].touchKnown = false; P[job.i].fw = 0; }   // Version kommt mit dem nächsten PING
      outForce = true;
      end(true, nullptr);
    } else if (++job.tries > 50) end(false, "startet nach dem Update nicht");
    else job.at = millis() + 20;
    return;
  }
  if (job.i >= 0 && job.step != IDLE) P[job.i].updPct = job.page * 100 / PANEL_FW_PAGES;
}

void loop() {
  if (job.step != IDLE) { step(); return; }
  for (int i = 1; i < SLOTS; i++) if (P[i].upd == 1) {
    if (canUpdate(P[i])) { start(i); return; }
    P[i].upd = 0;
  }
  if (cfg.panelAuto)
    for (int i = 1; i < SLOTS; i++) if (P[i].upd == 0 && P[i].updFails < 2 && canUpdate(P[i])) { start(i); return; }
  if (!cfg.bus || millis() - lastScan < 5000) return;
  lastScan = millis();                               // hängt ein Panel nach abgebrochenem Update im Bootloader?
  uint8_t d[2] = {++scanRound, 4};
  bus::send(bus::ALL, bus::BL_SCAN, d, 2);
  bus::Reply r;
  if (bus::receive(r, 8) && r.cmd == bus::BL_SCAN && r.len >= 5) {
    uint32_t chip = (uint32_t)r.data[0] | ((uint32_t)r.data[1] << 8) | ((uint32_t)r.data[2] << 16) | ((uint32_t)r.data[3] << 24);
    job = Job(); job.chip = chip; job.i = findChip(chip); job.rescue = true; job.step = INFO; job.at = millis();
    if (job.i >= 0) {
      P[job.i].upd = 2; P[job.i].updPct = 0;
      if (P[job.i].attached && P[job.i].addr) { job.addr = P[job.i].addr; job.rescue = false; }   // steht noch an der Wand: alte Adresse zurück
    }
    diag("Panel %s hängt im Bootloader, Firmware wird neu aufgespielt", hex(chip).substring(4).c_str());
  }
}
}  // namespace pupd


// ---------- Effekte ----------
// Das Hauptpanel rechnet jeden Effekt selbst und schickt etwa 25 Bilder pro Sekunde
// mit einem einzigen FRAME-Befehl an alle Panels. Die Panel-Firmware braucht dafür nichts Neues.
// color: mit der Palette "Standard" benutzt der Effekt die gewählte Effektfarbe
struct FxDef { const char* id; const char* name; bool color; };
const FxDef FX[] = {
  {"aus",         "Einfarbig",       false},
  {"regenbogen",  "Regenbogen",      false},
  {"welle",       "Regenbogenwelle", false},
  {"atmen",       "Atmen",           true},
  {"farbwechsel", "Farbwechsel",     false},
  {"funkeln",     "Funkeln",         true},
  {"ausbreiten",  "Ausbreiten",      true},
  {"feuer",       "Feuer",           false},
  {"polarlicht",  "Polarlicht",      false},
  {"lauflicht",   "Lauflicht",       true},
  {"spirale",     "Spirale",         false},
  {"gewitter",    "Gewitter",        false},
  {"kerzen",      "Kerzenlicht",     false},
  {"disco",       "Disco",           false},
  {"komet",       "Komet",           true},
  {"lava",        "Lava",            false},
  {"verlauf",     "Farbverlauf",     true},
  {"herz",        "Herzschlag",      true},
  {"plasma",      "Plasma",          false},
  {"regen",       "Regen",           false},
  {"sterne",      "Sternenhimmel",   false},
  {"feuerwerk",   "Feuerwerk",       false},
  {"matrix",      "Matrix",          false},
  {"wetter",      "Wetter",          false},
  {"raum-komet",  "Raum-Komet",      true},     // laufen über alle Wände im Raum
  {"raum-regenbogen", "Raum-Regenbogen", false},
  {"raum-welle",  "Raum-Welle",      true},
  {"raum-feuerwerk", "Raum-Feuerwerk", false},
  {"raum-pingpong", "Raum-Pingpong",  true},
  {"raum-atmen",  "Raum-Atmen",      true},
};
const uint8_t FX_COUNT = sizeof(FX) / sizeof(FX[0]);

// Paletten wie bei WLED: Farbverläufe, aus denen die Effekte ihre Farben nehmen
struct PalDef { const char* id; const char* name; uint8_t n; uint32_t c[6]; };
const PalDef PALS[] = {
  {"standard",        "Standard",        0, {0}},       // jeder Effekt mit seinen eigenen Farben
  {"regenbogen",      "Regenbogen",      6, {0xFF0000, 0xFFFF00, 0x00FF00, 0x00FFFF, 0x0000FF, 0xFF00FF}},
  {"effektfarbe",     "Effektfarbe",     0, {0}},       // dunkel, hell und aufgehellt aus der Effektfarbe
  {"ozean",           "Ozean",           5, {0x001E64, 0x0050C8, 0x00B4E6, 0x50F0FF, 0x0064B4}},
  {"lava",            "Lava",            5, {0x3C0000, 0xB40000, 0xFF3C00, 0xFFA000, 0xFF1E00}},
  {"wald",            "Wald",            5, {0x003C00, 0x1E7814, 0x64B41E, 0xA0D23C, 0x145A28}},
  {"sonnenuntergang", "Sonnenuntergang", 5, {0x3C0A64, 0xA01E64, 0xF03C32, 0xFFA028, 0xFFD264}},
  {"party",           "Party",           6, {0x5500AB, 0xFF0055, 0xFF9900, 0xFFFF00, 0x00FF99, 0x0066FF}},
  {"pastell",         "Pastell",         5, {0xFFB3BA, 0xFFDFBA, 0xFFFFBA, 0xBAFFC9, 0xBAE1FF}},
  {"eis",             "Eis",             5, {0xFFFFFF, 0xC8F0FF, 0x64C8FF, 0x1E78FF, 0xE6FAFF}},
};
const uint8_t PAL_COUNT = sizeof(PALS) / sizeof(PALS[0]);
// Eigene Paletten: 4 feste Plätze (eigen1 … eigen4) mit 2 bis 6 Farben, Index nach den eingebauten
struct CPal { bool used; String name; uint8_t n; uint32_t c[6]; };
const uint8_t CPAL_MAX = 4, PAL_ALL = PAL_COUNT + CPAL_MAX;
CPal cpal[CPAL_MAX];
// Mitgenommene Palette: kommt mit den Farben von einer anderen Wand (Gleichtakt, Raum-Effekt), ohne die eigenen zu ändern
const uint8_t PAL_X = PAL_ALL;
CPal xpal;
bool palValid(uint8_t k) { return k < PAL_COUNT || (k < PAL_ALL && cpal[k - PAL_COUNT].used) || (k == PAL_X && xpal.used); }
String palId(uint8_t k) { return k < PAL_COUNT ? String(PALS[k].id) : k == PAL_X ? String("mitgenommen") : "eigen" + String(k - PAL_COUNT + 1); }
String palName(uint8_t k) { return k < PAL_COUNT ? String(PALS[k].name) : !palValid(k) ? String("Standard") : k == PAL_X ? xpal.name : cpal[k - PAL_COUNT].name; }
namespace pl { const CPal* custom(uint8_t k) { return k == PAL_X ? (xpal.used ? &xpal : nullptr) : (k >= PAL_COUNT && k < PAL_ALL && cpal[k - PAL_COUNT].used) ? &cpal[k - PAL_COUNT] : nullptr; } }   // im Namensraum: sonst setzt Arduino den Prototyp vor CPal
#define palCustom pl::custom
// Farben einer anderen Wand übernehmen: gibt es dieselben schon als eigene Palette, die nehmen, sonst als mitgenommene
void palAdopt(uint8_t n, const uint32_t* c, const String& name);
void cpalSave() {
  JsonDocument d; JsonArray a = d.to<JsonArray>();
  for (uint8_t i = 0; i < CPAL_MAX; i++) {
    if (!cpal[i].used) { a.add(nullptr); continue; }
    JsonObject o = a.add<JsonObject>(); o["n"] = cpal[i].name; JsonArray c = o["c"].to<JsonArray>();
    for (uint8_t k = 0; k < cpal[i].n; k++) c.add(cpal[i].c[k]);
  }
  String s; serializeJson(d, s); prefs.putString("cpal", s);
}
void palAdopt(uint8_t n, const uint32_t* c, const String& name) {
  if (n < 2) return; if (n > 6) n = 6;
  for (uint8_t i = 0; i < CPAL_MAX; i++) if (cpal[i].used && cpal[i].n == n && !memcmp(cpal[i].c, c, n * 4)) { fx.pal = PAL_COUNT + i; return; }
  if (!(xpal.used && xpal.n == n && !memcmp(xpal.c, c, n * 4) && xpal.name == name)) {
    xpal.used = true; xpal.n = n; memcpy(xpal.c, c, n * 4); xpal.name = name.length() ? name.substring(0, 24) : String("Mitgenommen");
    JsonDocument d; d["n"] = xpal.name; JsonArray a = d["c"].to<JsonArray>(); for (uint8_t k = 0; k < n; k++) a.add(c[k]);
    String s; serializeJson(d, s); prefs.putString("xpal", s);
  }
  fx.pal = PAL_X;
}
// Farben der aktuellen Palette als Liste (nur eigene und mitgenommene), damit andere Wände sie übernehmen können
bool palCarry(JsonObject o) {
  const CPal* q = palCustom(fx.pal); if (!q) return false;
  JsonArray a = o["palColors"].to<JsonArray>(); for (uint8_t k = 0; k < q->n; k++) a.add(q->c[k]);
  o["palName"] = q->name; return true;
}
void cpalLoad() {
  { JsonDocument d; String x = prefs.getString("xpal", "");
    if (x.length() && !deserializeJson(d, x)) { xpal.n = 0; xpal.name = (const char*)(d["n"] | "Mitgenommen");
      for (JsonVariant v : d["c"].as<JsonArray>()) if (xpal.n < 6) xpal.c[xpal.n++] = v.as<uint32_t>();
      xpal.used = xpal.n >= 2; } }
  String s = prefs.getString("cpal", "");
  if (!s.length()) {                                   // zum Start eine Vorlage: Rot, Gold, Weiß
    cpal[0].used = true; cpal[0].name = "Rot-Gold-Weiß"; cpal[0].n = 3; cpal[0].c[0] = 0xFF0000; cpal[0].c[1] = 0xFFB000; cpal[0].c[2] = 0xFFFFFF;
    return;
  }
  JsonDocument d; if (deserializeJson(d, s)) return;
  for (uint8_t i = 0; i < CPAL_MAX; i++) {
    JsonVariant o = d[i]; cpal[i].used = o.is<JsonObject>();
    if (!cpal[i].used) continue;
    cpal[i].name = (const char*)(o["n"] | "Eigene"); cpal[i].n = 0;
    for (JsonVariant v : o["c"].as<JsonArray>()) if (cpal[i].n < 6) cpal[i].c[cpal[i].n++] = v.as<uint32_t>();
    if (cpal[i].n < 2) cpal[i].used = false;
  }
}
int palFind(const char* key) {
  for (uint8_t k = 0; k < PAL_COUNT; k++) if (!strcasecmp(key, PALS[k].id) || !strcasecmp(key, PALS[k].name)) return k;
  for (uint8_t k = PAL_COUNT; k < PAL_ALL; k++) if (palValid(k) && (!strcasecmp(key, palId(k).c_str()) || !strcasecmp(key, palName(k).c_str()))) return k;
  return -1;
}
bool fxUsesColor() { return fx.id && (fx.pal == 2 || (fx.pal == 0 && FX[fx.id].color)); }
const uint32_t FX_FRAME_MS = 40;

float fxPhase = 0, fxA[SLOTS * 3], fxB[SLOTS * 3], fxT[SLOTS * 3];   // Zustand pro Punkt (Panel oder Kante)
float fxFlash = 0, fxFlashX = 0, fxFlashY = 0;      // Gewitter: aktueller Blitz
int fxHead = 0, fxHeadE = 0; uint8_t fxPlan[3], fxPlanN = 0, fxPlanP = 0; float fxStep = 0; int fxBeat = -1;  // Komet: Kopf (Panel, Kante); Disco: Takt
float fwX = 0, fwY = 0, fwT = 9, fwH = 0;          // Feuerwerk: Mitte, Alter und Farbe der aktuellen Rakete
float wxTemp = 15; uint8_t wxKind = 0; bool wxOk = false;   // Wetter: Temperatur, 0 trocken, 1 Regen, 2 Schnee
uint16_t fxDir = 0;            // Richtung der Effekte in Grad (Lauflicht, Wellen, Lava …)
uint8_t fxC2[4] = {0, 80, 255, 0};   // zweite Farbe für den Farbverlauf
uint32_t fxFavs = 0;                 // Favoriten: Bit pro Effekt
uint8_t fxSpin = 0;            // Richtung dreht sich: 0 nein, 1 langsam, 2 schnell
float fxSpinAng = 0;
float fxAng = 0;               // aktueller Winkel (Richtung + Drehung), pro Bild berechnet
// Wandansicht: so hängt die Wand wirklich (Drehung, Spiegelung). Effekte laufen danach links/rechts, oben/unten.
void viewXY(float x, float y, float& rx, float& ry) {
  float a = cfg.viewRot * 0.01745329f, c = cosf(a), s = sinf(a);
  rx = x * c - y * s; ry = x * s + y * c;
  if (cfg.viewMir) rx = -rx;
}
// wie die Wand hängt, dann um die Effekt-Richtung gedreht: u läuft immer "in Effektrichtung"
void effXY(float x, float y, float& rx, float& ry) {
  float vx, vy; viewXY(x, y, vx, vy);
  float a = fxAng * 0.01745329f, c = cosf(a), s = sinf(a);
  rx = vx * c + vy * s; ry = -vx * s + vy * c;
}
uint32_t fxLast = 0, fxDirtyAt = 0, fxLastFrame = 0;
bool fxDirty = false;
uint8_t TGT[SLOTS][3][4];       // Ziel pro Panel und Kante (Effekt oder feste Farbe), Helligkeit schon eingerechnet
uint8_t CUR[SLOTS][3][4];       // was die Panels gerade zeigen (nach Übergang und Stromlimit)

int fxFind(const char* key) {
  for (uint8_t k = 0; k < FX_COUNT; k++) if (!strcasecmp(key, FX[k].id) || !strcasecmp(key, FX[k].name)) return k;
  return -1;
}
float frand() { return (esp_random() & 0xFFFFFF) / 16777216.0f; }

// Farbton 0..1 → RGB 0..255
void hue(float h, float* c) {
  h = h - floorf(h);
  float x = h * 6; int k = (int)x; float f = x - k;
  float q = 1 - f;
  float r = 0, g = 0, b = 0;
  switch (k % 6) {
    case 0: r = 1; g = f; break;   case 1: r = q; g = 1; break;
    case 2: g = 1; b = f; break;   case 3: g = q; b = 1; break;
    case 4: r = f; b = 1; break;   default: r = 1; b = q;
  }
  c[0] = r * 255; c[1] = g * 255; c[2] = b * 255; c[3] = 0;
}
void base(float k, float* c) { c[0] = fx.r * k; c[1] = fx.g * k; c[2] = fx.b * k; c[3] = fx.w * k; }

enum PalDefault : uint8_t { D_HUE, D_COLOR, D_FIRE, D_AURORA };
void fireColor(float h, float* c) { c[0] = 255 * h; c[1] = 85 * h * h; c[2] = 0; c[3] = 20 * h * h * h; }

// Farbe an Stelle t (0..1, wiederholt sich) aus der gewählten Palette
void pcol(float t, float* c, uint8_t def) {   // def: PalDefault (als uint8_t, wegen der automatischen Arduino-Prototypen)
  t = t - floorf(t);
  if (fx.pal == 0) {
    switch (def) {
      case D_HUE: hue(t, c); return;
      case D_COLOR: base(1, c); return;
      case D_FIRE: fireColor(0.35f + 0.65f * t, c); return;
      default: hue(0.36f + 0.36f * (0.5f + 0.5f * sinf(t * 6.2831853f)), c); return;
    }
  }
  if (fx.pal == 1) { hue(t, c); return; }
  float st[3][4];
  const float* stops[6]; uint8_t n;
  float tmp[6][4];
  if (fx.pal == 2) {                                   // aus der Effektfarbe: dunkel → Farbe → aufgehellt
    float col[4] = {(float)fx.r, (float)fx.g, (float)fx.b, (float)fx.w};
    for (int k = 0; k < 4; k++) { st[0][k] = col[k] * 0.25f; st[1][k] = col[k]; st[2][k] = col[k] * 0.6f + (k < 3 ? 102 : 0); }
    for (int k = 0; k < 3; k++) stops[k] = st[k];
    n = 3;
  } else {
    const uint32_t* cs;
    if (const CPal* q = palCustom(fx.pal)) { n = q->n; cs = q->c; }
    else { const PalDef& p = PALS[fx.pal < PAL_COUNT ? fx.pal : 1]; n = p.n; cs = p.c; }
    for (int k = 0; k < n; k++) {
      tmp[k][0] = (cs[k] >> 16) & 0xFF; tmp[k][1] = (cs[k] >> 8) & 0xFF; tmp[k][2] = cs[k] & 0xFF; tmp[k][3] = 0;
      stops[k] = tmp[k];
    }
  }
  float x = t * n; int a = (int)x % n, b = (a + 1) % n; float f = x - floorf(x);
  f = f * f * (3 - 2 * f);
  for (int k = 0; k < 4; k++) c[k] = stops[a][k] + (stops[b][k] - stops[a][k]) * f;
}
// Temperatur in °C → Farbe: -10 tiefblau, 0 hellblau, 10 türkis, 20 gelb, 30 rot
void tempColor(float t, float* c) {
  static const float T[][4] = {{-10, 0, 30, 255}, {0, 0, 150, 255}, {10, 0, 220, 140}, {20, 255, 200, 0}, {30, 255, 30, 0}};
  if (t <= T[0][0]) { c[0] = T[0][1]; c[1] = T[0][2]; c[2] = T[0][3]; c[3] = 0; return; }
  for (int k = 0; k < 4; k++) if (t <= T[k + 1][0]) {
    float f = (t - T[k][0]) / 10;
    for (int j = 0; j < 3; j++) c[j] = T[k][j + 1] + (T[k + 1][j + 1] - T[k][j + 1]) * f;
    c[3] = 0; return;
  }
  c[0] = 255; c[1] = 30; c[2] = 0; c[3] = 0;
}
void mul(float* c, float k) { for (int i = 0; i < 4; i++) c[i] *= k; }


// ---------- Raum: mehrere Wände im Grundriss ----------
// Der Grundriss (Ecken von oben, in cm, im Uhrzeigersinn) und wo jede Wand hängt, liegt auf allen Wänden gleich.
// Raum-Effekte rechnen mit der Stelle im Raum (abgewickelt entlang der Raumwände) und der gemeinsamen Uhrzeit:
// so laufen sie über alle Wände, ohne dass dafür Bilder verschickt werden.
const char* apiCall(const char* path, JsonDocument& d);
namespace room {
const uint8_t MAXC = 16, MAXD = 12;
struct Dev { String id, name, ip; uint8_t w = 0; float x = 0, y = 0, bw = 0, bh = 0; uint32_t g = 0; };
float cx[MAXC], cy[MAXC], U[MAXC + 1]; uint8_t nC = 0;
Dev dev[MAXD]; uint8_t nD = 0;
float H = 250, S = 23, Ptot = 0;
double ver = 0;
String raw;                         // alle Räume so, wie sie die App geschickt hat: {"v":…,"r":[{id,n,h,s,c,d,sc}, …]}
int me = -1;                        // diese Panelwand in ihrem Raum (-1: in keinem Raum)
// Mehrere Räume: jeder Raum hat eigene Panelwände; diese Panelwand rechnet mit dem Raum, in dem sie steht
const uint8_t MAXR = 6;
String rId[MAXR], rName[MAXR], rIp[MAXR][MAXD]; uint8_t rN[MAXR], nR = 0;
int ridx = -1;                      // Raum dieser Panelwand
// Abbildung "Stelle im Raum" → "Effekt-Strecke": lange Lücken zwischen den Wänden werden kurz
struct Seg { float u0, c0, len, k; };
Seg seg[2 * MAXD + 2]; uint8_t nS = 0; float Lc = 0, uStart = 0;
float ocx = 0, ocy = 0;             // Mitte der eigenen Panels (Wandansicht), pro Bild

// eigene Panels: Mitte der Mittelpunkte und Größe (Seitenlänge 1), wie die Wand hängt
void ownBox(float& mx, float& my, float& bw, float& bh) {
  float x0 = 1e9, x1 = -1e9, y0 = 1e9, y1 = -1e9;
  for (int i = 0; i < SLOTS; i++) if (P[i].used && P[i].attached) {
    float vx, vy; viewXY(P[i].x * 0.5f, P[i].y * 0.866f, vx, vy);
    x0 = fminf(x0, vx); x1 = fmaxf(x1, vx); y0 = fminf(y0, vy); y1 = fmaxf(y1, vy);
  }
  if (x0 > x1) { mx = my = 0; bw = bh = 1; return; }
  mx = (x0 + x1) / 2; my = (y0 + y1) / 2; bw = x1 - x0 + 1; bh = y1 - y0 + 1.16f;
}
uint32_t geoSig() {
  uint32_t h = 2166136261u ^ cfg.viewRot ^ (cfg.viewMir << 9);
  for (int i = 0; i < SLOTS; i++) if (P[i].used && P[i].attached) h = (h ^ (uint32_t)(P[i].x * 131 + P[i].y * 7 + P[i].rot * 3 + P[i].edges)) * 16777619u;
  return h ? h : 1;
}
// Panels dieser Panelwand: Mitte, Winkel der Spitze, Kanten einzeln (für den Raum) – mit Farbe für die App
void packP(JsonArray a, bool col = false) {
  float mx, my, bw, bh; ownBox(mx, my, bw, bh);
  for (int i = 0; i < SLOTS; i++) if (P[i].used && P[i].attached) {
    float vx, vy; viewXY(P[i].x * 0.5f, P[i].y * 0.866f, vx, vy);
    int ang = (isUp(P[i].x, P[i].y) ? 270 : 90) + cfg.viewRot; if (cfg.viewMir) ang = 180 - ang; ang = ((ang % 360) + 360) % 360;
    JsonArray q = a.add<JsonArray>(); q.add(roundf((vx - mx) * 100) / 100); q.add(roundf((vy - my) * 100) / 100); q.add(ang); q.add(P[i].edges ? 1 : 0);
    if (col) {
      const uint8_t* c = CUR[i][0]; char b[8];
      auto cl = [](int v) { return v > 255 ? 255 : v; };
      snprintf(b, sizeof b, "#%02X%02X%02X", cl(c[0] + c[3]), cl(c[1] + c[3]), cl(c[2] + c[3])); q.add(b);
    }
  }
}
// Geometrie dieser Panelwand für die App: [x, y, Winkel, Kanten, Farbe] je Panel
String geoJson() {
  JsonDocument d; float mx, my, bw, bh; ownBox(mx, my, bw, bh);
  d["id"] = hex(P[0].chip); d["n"] = cfg.name; d["ip"] = WiFi.localIP().toString(); d["ver"] = FW_VERSION; d["g"] = geoSig();
  d["bw"] = bw; d["bh"] = bh; d["room"] = ridx >= 0 ? rId[ridx] : String();
  packP(d["p"].to<JsonArray>(), true);
  String s; serializeJson(d, s); return s;
}
void build() {
  // Wandlängen und wo jede Raumwand in der Abwicklung beginnt
  Ptot = 0;
  for (uint8_t i = 0; i < nC; i++) { U[i] = Ptot; uint8_t j = (i + 1) % nC; Ptot += hypotf(cx[j] - cx[i], cy[j] - cy[i]); }
  U[nC] = Ptot;
  // belegte Stücke, sortiert und zusammengefasst
  float a[MAXD], b[MAXD]; uint8_t n = 0;
  for (uint8_t i = 0; i < nD; i++) if (dev[i].w < nC) { a[n] = U[dev[i].w] + dev[i].x - dev[i].bw / 2; b[n] = a[n] + fmaxf(1, dev[i].bw); n++; }
  for (uint8_t i = 0; i < n; i++) for (uint8_t j = i + 1; j < n; j++) if (a[j] < a[i]) { float t = a[i]; a[i] = a[j]; a[j] = t; t = b[i]; b[i] = b[j]; b[j] = t; }
  uint8_t m = 0; for (uint8_t i = 0; i < n; i++) { if (m && a[i] <= b[m - 1]) b[m - 1] = fmaxf(b[m - 1], b[i]); else { a[m] = a[i]; b[m] = b[i]; m++; } }
  nS = 0; Lc = 0;
  if (!m || Ptot <= 0) return;
  uStart = a[0];
  float G = 1.5f * S;                                   // längere Lücken werden so kurz wie 1,5 Panels
  for (uint8_t i = 0; i < m; i++) {
    seg[nS++] = {a[i], Lc, b[i] - a[i], 1}; Lc += b[i] - a[i];
    float nx = i + 1 < m ? a[i + 1] : a[0] + Ptot, g = nx - b[i];
    if (g > 0) { float cg = fminf(g, G); seg[nS++] = {b[i], Lc, g, cg / g}; Lc += cg; }
  }
}
// Stelle im Raum (cm entlang der Wände) → Stelle auf der Effekt-Strecke (0 … Lc)
float cu(float u) {
  if (!nS) return u;
  while (u < uStart) u += Ptot; while (u >= uStart + Ptot) u -= Ptot;
  for (uint8_t i = 0; i < nS; i++) if (u < seg[i].u0 + seg[i].len || i == nS - 1) return seg[i].c0 + fminf(u - seg[i].u0, seg[i].len) * seg[i].k;
  return 0;
}
// alte Speicherung (ein Raum ohne "r") in die neue umwandeln
void normalize(JsonDocument& d) {
  if (d["r"].is<JsonArray>() || !d["c"].is<JsonArray>()) { if (!d["r"].is<JsonArray>()) d["r"].to<JsonArray>(); return; }
  JsonDocument o; o.set(d);
  JsonArray r = d["r"].to<JsonArray>(); JsonObject q = r.add<JsonObject>();
  q["id"] = "r1"; q["n"] = "Raum";
  for (JsonPair kv : o.as<JsonObject>()) if (strcmp(kv.key().c_str(), "v") && strcmp(kv.key().c_str(), "r")) q[kv.key()] = kv.value();
  for (const char* k : {"c", "d", "h", "s"}) d.remove(k);
  if (!q["c"].size()) r.remove(0);                       // gelöschter Raum
}
bool parse(const String& js) {
  JsonDocument d; if (deserializeJson(d, js)) return false;
  normalize(d);
  ver = d["v"] | 0.0;
  nC = 0; nD = 0; me = -1; ridx = -1; nR = 0; H = 250; S = 23;
  String my = hex(P[0].chip);
  for (JsonVariant q : d["r"].as<JsonArray>()) {
    if (nR >= MAXR) break;
    rId[nR] = (const char*)(q["id"] | ""); rName[nR] = (const char*)(q["n"] | "Raum"); rN[nR] = 0;
    for (JsonVariant v : q["d"].as<JsonArray>()) {
      if (rN[nR] < MAXD) rIp[nR][rN[nR]++] = (const char*)(v["ip"] | "");
      if (my == (const char*)(v["id"] | "") && ridx < 0) ridx = nR;
    }
    nR++;
  }
  if (ridx >= 0) {
    JsonVariant q = d["r"][ridx];
    for (JsonVariant c : q["c"].as<JsonArray>()) if (nC < MAXC) { cx[nC] = c[0] | 0.0f; cy[nC] = c[1] | 0.0f; nC++; }
    H = q["h"] | 250.0f; S = constrain(q["s"] | 23.0f, 5.0f, 100.0f);
    for (JsonVariant v : q["d"].as<JsonArray>()) {
      if (nD >= MAXD) break;
      Dev& e = dev[nD]; e = Dev();
      e.id = (const char*)(v["id"] | ""); e.name = (const char*)(v["n"] | ""); e.ip = (const char*)(v["ip"] | "");
      e.w = v["w"] | 0; e.x = v["x"] | 0.0f; e.y = v["y"] | 0.0f; e.bw = v["bw"] | 0.0f; e.bh = v["bh"] | 0.0f; e.g = v["g"] | 0u;
      if (e.id == my) me = nD;
      nD++;
    }
    if (nC < 3) { nC = 0; nD = 0; me = -1; }
  }
  build();
  return true;
}
int roomFind(const String& id) { for (uint8_t i = 0; i < nR; i++) if (rId[i] == id) return i; return -1; }
void load() { size_t n = prefs.getBytesLength("room"); if (n && n < 16000) { char* b = (char*)malloc(n + 1); if (b) { prefs.getBytes("room", b, n); b[n] = 0; raw = b; free(b); parse(raw); } } }
void store() { prefs.putBytes("room", raw.c_str(), raw.length()); }

// an andere Panelwände schicken (der Reihe nach, im Hintergrund): an einen Raum (-1: den eigenen) oder an alle (-2)
struct Job { String path, body; String ips[MAXR * MAXD]; uint8_t n = 0; };
const uint8_t QN = 4; Job q[QN]; volatile uint8_t qHead = 0, qTail = 0; volatile bool sending = false;
String oldIps[MAXR * MAXD]; uint8_t nOld = 0;          // Panelwände, die bis eben in einem Raum waren (z. B. vor dem Löschen)
void sendTask(void*) {
  while (qHead != qTail) {
    Job& j = q[qHead];
    for (uint8_t i = 0; i < j.n && !netQuiet && !otaBusy; i++) {
      HTTPClient h; h.setTimeout(2500);
      if (h.begin("http://" + j.ips[i] + j.path)) { h.addHeader("Content-Type", "application/json"); h.POST(j.body); }
      h.end();
    }
    j.body = ""; qHead = (qHead + 1) % QN;
  }
  sending = false;
  vTaskDelete(nullptr);
}
void fanout(const char* path, const String& body, int room = -1) {
  if ((qTail + 1) % QN == qHead) return;                 // Warteschlange voll
  Job& j = q[qTail]; j.path = path; j.body = body; j.n = 0;
  String my = WiFi.localIP().toString();
  auto add = [&](const String& ip) { if (ip.length() < 7 || ip == my) return; for (uint8_t k = 0; k < j.n; k++) if (j.ips[k] == ip) return; if (j.n < MAXR * MAXD) j.ips[j.n++] = ip; };
  if (room == -1) room = ridx;
  for (uint8_t r = 0; r < nR; r++) if (room == -2 || r == room) for (uint8_t i = 0; i < rN[r]; i++) add(rIp[r][i]);
  for (uint8_t i = 0; i < nOld; i++) add(oldIps[i]);
  nOld = 0;
  if (!j.n) return;
  qTail = (qTail + 1) % QN;
  if (sending) return;
  sending = true;
  if (xTaskCreate(sendTask, "raum", 6144, nullptr, 1, nullptr) != pdPASS) sending = false;
}
double nowV() { if (timeOk()) { struct timeval tv; gettimeofday(&tv, nullptr); return (double)tv.tv_sec * 1000 + tv.tv_usec / 1000; } return millis(); }
// neuen Grundriss übernehmen (nur, wenn er neuer ist) und auf Wunsch an die anderen weitergeben
const char* save(JsonVariantConst lay, bool fwd) {
  double v = lay["v"] | 0.0;
  if (v < ver) return nullptr;                          // älterer Stand: ignorieren
  String js; serializeJson(lay, js);
  if (js.length() > 9000) return "Räume zu groß";              // muss in den Einstellungsspeicher passen
  if (fwd) { nOld = 0; for (uint8_t r = 0; r < nR; r++) for (uint8_t i = 0; i < rN[r] && nOld < MAXR * MAXD; i++) oldIps[nOld++] = rIp[r][i]; }
  if (!parse(js)) return "Raum unlesbar";
  { JsonDocument d; deserializeJson(d, js); normalize(d); js = ""; serializeJson(d, js); }
  raw = js; store();
  if (fwd) fanout("/api/room", "{\"action\":\"save\",\"fwd\":false,\"layout\":" + raw + "}", -2);
  return nullptr;
}
// Abgleich: jede Minute bei den anderen Wänden nachsehen, ob sie denselben Raum haben (z. B. nach einem Update
// oder wenn eine Wand beim Speichern aus war). Älteren schicken wir unseren, einen neueren übernehmen wir.
volatile bool healing = false; String healNew;
void healTask(void*) {
  String ips[MAXR * MAXD]; uint8_t n = 0; double v0 = ver; String mine = raw, myIp = WiFi.localIP().toString();
  for (uint8_t r = 0; r < nR; r++) for (uint8_t i = 0; i < rN[r]; i++) {
    const String& ip = rIp[r][i]; bool dup = ip.length() < 7 || ip == myIp;
    for (uint8_t k = 0; k < n && !dup; k++) if (ips[k] == ip) dup = true;
    if (!dup) ips[n++] = ip;
  }
  for (uint8_t i = 0; i < n && !netQuiet && !otaBusy; i++) {
    HTTPClient h; h.setTimeout(2500); String r;
    if (h.begin("http://" + ips[i] + "/api/room") && h.GET() == 200) r = h.getString();
    h.end();
    if (!r.length()) continue;
    JsonDocument f; f["layout"]["v"] = true; JsonDocument d;
    if (deserializeJson(d, r, DeserializationOption::Filter(f))) continue;
    double v = d["layout"]["v"] | 0.0;
    if (v < v0) {
      HTTPClient p; p.setTimeout(3000);
      if (p.begin("http://" + ips[i] + "/api/room")) { p.addHeader("Content-Type", "application/json"); p.POST("{\"action\":\"save\",\"fwd\":false,\"layout\":" + mine + "}"); }
      p.end();
    } else if (v > v0 && !healNew.length()) {
      JsonDocument full; if (!deserializeJson(full, r) && full["layout"].is<JsonObject>()) serializeJson(full["layout"], healNew);
    }
  }
  healing = false;
  vTaskDelete(nullptr);
}
// eigene Panels geändert (abgeklipst, gedreht …): den eigenen Eintrag im Raum nachziehen und weitergeben
void loop() {
  static uint32_t last = 0, lastHeal = 0;
  if (healNew.length() && !healing) { JsonDocument d; String js = healNew; healNew = ""; if (!deserializeJson(d, js)) save(d.as<JsonVariantConst>(), false); }
  if (nR && wlanOk && !healing && !sending && !netQuiet && !otaBusy && (!lastHeal || millis() - lastHeal > 60000)) {
    lastHeal = millis() | 1; healing = true;
    if (xTaskCreate(healTask, "raumabgl", 6144, nullptr, 1, nullptr) != pdPASS) healing = false;
  }
  if (me < 0 || millis() - last < 5000) return;
  last = millis();
  uint32_t g = geoSig(); if (dev[me].g == g) return;
  JsonDocument d; if (deserializeJson(d, raw)) return;
  normalize(d);
  String my = hex(P[0].chip);
  for (JsonVariant v : d["r"][ridx]["d"].as<JsonArray>()) if (my == (const char*)(v["id"] | "")) {
    float mx, my2, bw, bh; ownBox(mx, my2, bw, bh);
    JsonArray pa = v["p"].to<JsonArray>(); packP(pa);
    v["bw"] = roundf(bw * S); v["bh"] = roundf(bh * S); v["g"] = g; v["ip"] = WiFi.localIP().toString(); v["n"] = cfg.name;
  }
  d["v"] = (uint64_t)fmax(ver + 1, nowV());           // als ganze Zahl: Millisekunden passen nicht genau in eine Kommazahl
  save(d.as<JsonVariantConst>(), true);
}
// Sekunden seit Mitternacht (gemeinsame Uhr über das Internet), ohne Uhrzeit die Laufzeit
double tsec() { if (timeOk()) { struct timeval tv; gettimeofday(&tv, nullptr); return (double)(tv.tv_sec % 86400) + tv.tv_usec / 1e6; } return millis() / 1000.0; }
// vor jedem Bild: Mitte der eigenen Panels; ohne Raum wirkt der Effekt nur auf dieser Wand
// ----- Raum-Komet: wie der Komet einer Wand, aber über alle Wände im Raum -----
// Alle Wände bauen aus demselben Raum dasselbe Netz und rechnen denselben Weg: Schritt n hängt nur vom Raum und
// von der Uhrzeit ab, darum gibt es genau einen Kopf, ohne dass etwas gesendet wird.
// Panels mit "Kanten einzeln": alle drei Kanten nacheinander, dann über die zuletzt leuchtende Kante hinüber.
const uint16_t MAXU = 160, MAXN = 480;
const int32_t BLK = 20000;
struct Unit { float u, h, a; uint16_t n0; bool ed; uint8_t dv; int16_t acU[3]; int8_t acS[3]; int16_t jmp[2]; };
Unit un[MAXU]; uint16_t nU = 0;
uint16_t nodeU[MAXN]; int8_t nodeS[MAXN]; int32_t lastV[MAXN]; uint16_t nN = 0;
int16_t ownU[SLOTS], ownE[SLOTS][3];
uint32_t gSig = 0; bool gRoom = false;
int32_t curStep = -1; uint16_t head = 0; uint8_t plan[3], planN = 0, planP = 0;
uint32_t mix(uint32_t a, uint32_t b) { uint32_t h = a * 2654435761u ^ (b + 0x9E3779B9u + (a << 6) + (a >> 2)); h ^= h >> 15; h *= 2246822519u; h ^= h >> 13; return h; }
// Kantenmitte s: der Schwerpunkt liegt 0,144 hinter der Rastermitte (weg von der Spitze), die Kantenmitten 0,289 um ihn herum
void sideMid(const Unit& q, int s, float& u, float& h) {
  float t = q.a * 0.01745329f, a = (q.a + 60 + 120 * s) * 0.01745329f;
  float x = -0.1443f * cosf(t) + 0.2887f * cosf(a), y = -0.1443f * sinf(t) + 0.2887f * sinf(a);
  u = q.u + x * S; h = q.h - y * S;
}
void addUnit(float u, float h, float a, bool ed, uint8_t dv) {
  if (nU >= MAXU || nN + (ed ? 3 : 1) > MAXN) return;
  Unit& q = un[nU]; q.u = u; q.h = h; q.a = a; q.ed = ed; q.dv = dv; q.n0 = nN;
  for (int s = 0; s < 3; s++) { q.acU[s] = -1; q.acS[s] = -1; } q.jmp[0] = q.jmp[1] = -1;
  for (int s = 0; s < (ed ? 3 : 1); s++) { nodeU[nN] = nU; nodeS[nN] = ed ? s : -1; nN++; }
  nU++;
}
// Nachbarn in einer Wand: zwei Panels teilen eine Kante, wenn die Kantenmitten aufeinander liegen
void linkWithin(uint16_t a0, uint16_t a1) {
  for (uint16_t i = a0; i < a1; i++) for (int s = 0; s < 3; s++) {
    float u1, h1; sideMid(un[i], s, u1, h1);
    for (uint16_t j = a0; j < a1; j++) if (j != i) for (int t = 0; t < 3; t++) {
      float u2, h2; sideMid(un[j], t, u2, h2);
      if (fabsf(u1 - u2) + fabsf(h1 - h2) < 0.15f * S) { un[i].acU[s] = j; un[i].acS[s] = t; }
    }
  }
}
void jump(uint16_t a, uint16_t b) {
  if (a == b) return;
  for (int k = 0; k < 2; k++) if (un[a].jmp[k] == (int16_t)b) return;
  for (int k = 0; k < 2; k++) if (un[a].jmp[k] < 0) { un[a].jmp[k] = b; break; }
  for (int k = 0; k < 2; k++) if (un[b].jmp[k] < 0) { un[b].jmp[k] = a; break; }
}
void addP(JsonArrayConst p, float u0, float h0, uint8_t dv) {
  for (JsonVariantConst q : p) addUnit(u0 + (q[0] | 0.0f) * S, h0 - (q[1] | 0.0f) * S, q[2] | 270.0f, (q[3].is<const char*>() ? (q[4] | 0) : (q[3] | 0)) != 0, dv);
}
void graph() {
  nU = nN = 0; curStep = -1;
  for (int i = 0; i < SLOTS; i++) { ownU[i] = -1; ownE[i][0] = ownE[i][1] = ownE[i][2] = -1; }
  float mx, my, bw, bh; ownBox(mx, my, bw, bh);
  JsonDocument d; uint16_t first[MAXD], cnt[MAXD]; float lo[MAXD]; uint8_t k = 0;
  gRoom = me >= 0 && !deserializeJson(d, raw);
  if (gRoom) normalize(d);
  float ou = 0, oh = 0;                                     // wo die eigene Wand im Raum liegt
  if (gRoom) {
    for (JsonVariant v : d["r"][ridx]["d"].as<JsonArray>()) {
      if (k >= nD) break;
      const Dev& e = dev[k]; first[k] = nU;
      if (e.w < nC) addP(v["p"].as<JsonArrayConst>(), U[e.w] + e.x, e.y, k);
      cnt[k] = nU - first[k]; lo[k] = 1e9; for (uint16_t q = first[k]; q < nU; q++) lo[k] = fminf(lo[k], un[q].u);
      linkWithin(first[k], nU); k++;
    }
    // die Wände der Reihe nach entlang der Raumwände verbinden: rechtes Ende der einen mit dem linken der nächsten
    uint8_t ord[MAXD], n = 0; for (uint8_t i = 0; i < k; i++) if (cnt[i]) ord[n++] = i;
    for (uint8_t i = 0; i < n; i++) for (uint8_t j = i + 1; j < n; j++) if (lo[ord[j]] < lo[ord[i]]) { uint8_t t = ord[i]; ord[i] = ord[j]; ord[j] = t; }
    for (uint8_t i = 0; n > 1 && i < n; i++) {
      uint8_t A = ord[i], B = ord[(i + 1) % n]; float wrap = i + 1 == n ? Ptot : 0;
      uint16_t a = first[A]; for (uint16_t q = first[A]; q < first[A] + cnt[A]; q++) if (un[q].u > un[a].u) a = q;
      uint16_t b = first[B]; float best = 1e9;
      for (uint16_t q = first[B]; q < first[B] + cnt[B]; q++) { float c = (un[q].u + wrap - lo[B]) + 0.5f * fabsf(un[q].h - un[a].h); if (c < best) { best = c; b = q; } }
      jump(a, b);
    }
    ou = U[dev[me].w] + dev[me].x; oh = dev[me].y;
  } else {                                                  // ohne Raum: nur die eigenen Panels
    JsonDocument g; deserializeJson(g, geoJson());
    addP(g["p"].as<JsonArrayConst>(), 0, 0, 0); linkWithin(0, nU);
  }
  // eigene Panels und Kanten den Knoten zuordnen (nächster Punkt)
  uint16_t a0 = gRoom ? first[me] : 0, a1 = gRoom ? first[me] + cnt[me] : nU;
  for (int i = 0; i < SLOTS; i++) if (P[i].used && P[i].attached) {
    float vx, vy; viewXY(P[i].x * 0.5f, P[i].y * 0.866f, vx, vy);
    float u = ou + (vx - mx) * S, h = oh - (vy - my) * S, bd = 1e9; int bi = -1;
    for (uint16_t q = a0; q < a1; q++) { float dd = fabsf(un[q].u - u) + fabsf(un[q].h - h); if (dd < bd) { bd = dd; bi = q; } }
    if (bi < 0 || bd > 0.4f * S) continue;
    ownU[i] = bi;
    if (un[bi].ed) for (int e = 0; e < 3; e++) {
      float px, py, dd2; edgePos(i, e, px, py, dd2); viewXY(px, py, vx, vy);
      float eu = ou + (vx - mx) * S, eh = oh - (vy - my) * S, b2 = 1e9;
      for (int s = 0; s < 3; s++) { float su, sh; sideMid(un[bi], s, su, sh); float x = fabsf(su - eu) + fabsf(sh - eh); if (x < b2) { b2 = x; ownE[i][e] = un[bi].n0 + s; } }
    }
  }
  gSig = geoSig() ^ (uint32_t)ver;
}
int32_t seen(uint16_t q) { int32_t m = -1000000; const Unit& x = un[q]; for (int s = 0; s < (x.ed ? 3 : 1); s++) { if (lastV[x.n0 + s] > m) m = lastV[x.n0 + s]; } return m; }
bool onward(uint16_t q, int s) { return un[q].acU[s] >= 0 || un[q].jmp[0] >= 0; }
int32_t onwardSeen(uint16_t q, int s) { int16_t t = un[q].acU[s] >= 0 ? un[q].acU[s] : un[q].jmp[0]; return t >= 0 ? seen(t) : 0x7FFFFFFF; }
// ein Schritt des Kopfes (wie fxCompute beim Komet einer Wand)
void step() {
  uint16_t Q = nodeU[head]; const Unit& q = un[Q];
  if (q.ed && planP < planN) { head = q.n0 + plan[planP++]; return; }        // nächste Kante im Panel
  int16_t cu[5]; int8_t cs[5]; uint8_t n = 0;
  if (q.ed) { int s = nodeS[head]; if (q.acU[s] >= 0) { cu[n] = q.acU[s]; cs[n] = q.acS[s]; n++; } }
  else for (int s = 0; s < 3; s++) if (q.acU[s] >= 0) { cu[n] = q.acU[s]; cs[n] = q.acS[s]; n++; }
  for (int k = 0; k < 2; k++) if (q.jmp[k] >= 0) { cu[n] = q.jmp[k]; cs[n] = -1; n++; }      // hinüber zur nächsten Wand
  if (!n) {
    if (q.ed) { int s = nodeS[head]; plan[0] = (s + 1) % 3; plan[1] = (s + 2) % 3; planN = 2; planP = 0; return; }   // erst die anderen Kanten
    head = mix(curStep, 7) % nN; planN = planP = 0; return;
  }
  int pick = 0; int32_t best = 0x7FFFFFFF; uint32_t tie = 0;
  for (int k = 0; k < n; k++) { int32_t v = seen(cu[k]); uint32_t r = mix(curStep, cu[k]); if (v < best || (v == best && r > tie)) { best = v; tie = r; pick = k; } }
  uint16_t R = cu[pick]; const Unit& r = un[R]; int t = cs[pick];
  if (t < 0) {                                              // Sprung: Eingang ist die Kante, die zur alten Wand zeigt
    float bd = 1e9; for (int s = 0; s < 3; s++) { float su, sh; sideMid(r, s, su, sh); float x = fabsf(su - q.u) + fabsf(sh - q.h); if (x < bd) { bd = x; t = s; } }
  }
  planN = planP = 0;
  if (!r.ed) { head = r.n0; return; }
  head = r.n0 + t;
  int fwE = (t + 2) % 3, bwE = (t + 1) % 3;                 // vorwärts endet bei t+2, rückwärts bei t+1
  bool f = onward(R, fwE), b = onward(R, bwE), dirF;
  if (f && b) { int32_t sf = onwardSeen(R, fwE), sb = onwardSeen(R, bwE); dirF = sf != sb ? sf < sb : (mix(curStep, R) & 1); }
  else dirF = f ? true : b ? false : (mix(curStep, R) & 1);
  plan[0] = dirF ? (t + 1) % 3 : (t + 2) % 3; plan[1] = dirF ? fwE : bwE; planN = 2;
  if (!f && !b) plan[planN++] = t;                          // Sackgasse: zurück zur Eingangskante
}
void walkTo(int32_t t) {
  if (!nN) return;
  int32_t b0 = t - t % BLK;
  if (curStep < 0 || t < curStep || curStep < b0) {         // neu: ab Blockanfang durchrechnen
    for (uint16_t i = 0; i < nN; i++) lastV[i] = -1000000;
    head = un[mix(b0, nU) % nU].n0; planN = planP = 0; curStep = b0; lastV[head] = curStep;
  }
  while (curStep < t) { step(); curStep++; lastV[head] = curStep; }
}
float stepF = 0;
void frame() {
  float bw, bh; ownBox(ocx, ocy, bw, bh);
  if (me < 0) { Lc = fmaxf(1, bw * S); }
  if (fx.id == 24 || fx.id == 27) { if (gSig != (geoSig() ^ (uint32_t)ver) || (me >= 0) != gRoom) graph(); }
  if (fx.id == 24) {
    float rate = powf(4.0f, (fx.speed - 50) / 50.0f);
    stepF = (float)fmod(tsec() * 4 * rate, 2000000.0);
    walkTo((int32_t)stepF);
  }
}
// Helligkeit eines eigenen Panels oder einer Kante beim Raum-Kometen (1 = Kopf); tail = Schritte bis dunkel
float comet(int i, int e, float tail, bool& isHead) {
  isHead = false; int16_t q = ownU[i];
  if (q < 0 || !nN) return 0;
  int n = -1; int32_t lv;
  if (un[q].ed && e >= 0 && ownE[i][e] >= 0) { n = ownE[i][e]; lv = lastV[n]; }
  else { lv = seen(q); for (int s = 0; s < (un[q].ed ? 3 : 1); s++) if (un[q].n0 + s == head) n = head; if (n < 0) n = un[q].n0; }
  isHead = n == head;
  float age = stepF - lv;
  if (age < 1) return 1;
  return fmaxf(0, 1 - (age - 1) / tail);
}
// Raum-Feuerwerk: Rakete Nummer k explodiert an einem Panel irgendwo im Raum (für alle Panelwände gleich)
bool burst(uint32_t k, float& u, float& h, float& hue) {
  if (!nU) return false;
  const Unit& q = un[mix(k, 77) % nU]; u = q.u; h = q.h; hue = (mix(k, 5) & 0xFFFF) / 65536.0f; return true;
}
// Stelle eines Punkts dieser Panelwand im Raum: u entlang der Raumwände, h Höhe (cm)
void ownPos(float px, float py, float& u, float& h) {
  float mx, my, bw, bh; ownBox(mx, my, bw, bh);
  float vx, vy; viewXY(px, py, vx, vy);
  if (me < 0) { u = (vx - mx) * S; h = -(vy - my) * S; return; }
  u = U[dev[me].w] + dev[me].x + (vx - mx) * S; h = dev[me].y - (vy - my) * S;
}
// Stelle eines Punkts dieser Wand auf der Effekt-Strecke (cm)
float at(float px, float py) {
  float vx, vy; viewXY(px, py, vx, vy);
  if (me < 0) return (vx - ocx) * S + Lc / 2;
  return cu(U[dev[me].w] + dev[me].x + (vx - ocx) * S);
}
String json() { return "{\"me\":\"" + hex(P[0].chip) + "\",\"layout\":" + (raw.length() ? raw : String("null")) + "}"; }
}  // namespace room

void fxReset() {
  for (int i = 0; i < SLOTS * 3; i++) { fxA[i] = frand(); fxB[i] = frand(); fxT[i] = frand(); }
  fxLast = millis();
}

void fxCompute() {
  uint32_t now = millis();
  float dt = (now - fxLast) / 1000.0f; fxLast = now;
  if (dt > 0.2f) dt = 0.2f;
  float rate = powf(4.0f, (fx.speed - 50) / 50.0f);   // Tempo 1..100 → 0,25- bis 4-fach
  fxPhase += dt * rate;
  if (fxPhase > 100000) fxPhase = 0;

  if (fxSpin) { fxSpinAng += dt * (fxSpin == 1 ? 6 : 30); if (fxSpinAng >= 360) fxSpinAng -= 360; }
  fxAng = fxDir + fxSpinAng;
  float minX = 1e9, maxX = -1e9, minY = 1e9, maxY = -1e9;
  for (int i = 0; i < SLOTS; i++) if (P[i].used && P[i].attached) {
    float rx, ry; effXY(P[i].x * 0.5f, P[i].y * 0.866f, rx, ry);
    minX = fminf(minX, rx); maxX = fmaxf(maxX, rx); minY = fminf(minY, ry); maxY = fmaxf(maxY, ry);
  }
  float spanX = fmaxf(1.0f, maxX - minX);
  float cxW = (minX + maxX) / 2, cyW = (minY + maxY) / 2, maxR = fmaxf(1.0f, 0.5f * hypotf(maxX - minX, maxY - minY));
  const float TAU = 6.2831853f;
  // Gewitter: Blitze kommen und klingen schnell ab
  fxFlash = fmaxf(0, fxFlash - dt * rate * 5);
  // Feuerwerk: alle 1,5 s (bei Tempo 50) eine neue Rakete an einem zufälligen Panel
  if (fx.id == 21) {
    fwT += dt * rate;
    if (fwT > 1.6f - 0.8f * fx.inten / 255.0f) {
      int n = 0, pick = 0; for (int i = 0; i < SLOTS; i++) if (P[i].used && P[i].attached && frand() * (++n) < 1) pick = i;
      effXY(P[pick].x * 0.5f, P[pick].y * 0.866f, fwX, fwY); fwT = 0; fwH = frand();
    }
  }
  if (fx.id == 11 && frand() < dt * rate * (0.12f + 0.6f * fx.inten / 255.0f)) {
    int n = 0, pick = 0; for (int i = 0; i < SLOTS; i++) if (P[i].used && P[i].attached && frand() * (++n) < 1) pick = i;
    effXY(P[pick].x * 0.5f, P[pick].y * 0.866f, fxFlashX, fxFlashY); fxFlash = 0.7f + 0.3f * frand();
  }
  // Komet: der Kopf wandert zu einem Nachbarn weiter.
  // Panels mit "Kanten einzeln": alle drei Kanten nacheinander (im oder gegen den Uhrzeigersinn, je nachdem wo es
  // weitergeht), dann von der letzten Kante hinüber ins Nachbarpanel, z. B. 1-2, 1-3, 2-1, 2-2, 2-3, 3-1 …
  if (fx.id == 14) {
    if (!P[fxHead].used || !P[fxHead].attached) { fxHead = 0; fxHeadE = 0; fxPlanN = 0; }
    if (!P[fxHead].edges) { fxHeadE = 0; fxPlanN = 0; }
    fxStep += dt * rate * 4;
    while (fxStep >= 1) {
      fxStep -= 1;
      const Panel& h = P[fxHead];
      if (h.edges && fxPlanP < fxPlanN) { fxHeadE = fxPlan[fxPlanP++]; fxA[fxHead * 3 + fxHeadE] = 1; continue; }   // nächste Kante im Panel
      // hinüber: aus Kanten-Panels über die zuletzt leuchtende Kante, sonst über irgendeine
      int cj[3], ce[3], n = 0;
      for (uint8_t e = 0; e < 3; e++) {
        if (h.edges && e != fxHeadE) continue;
        Dir w = worldDir(h, e); int nx, ny; neighbor(h.x, h.y, w, nx, ny); int j = findAt(nx, ny);
        if (j < 0) continue;
        int ej = P[j].edges ? edgeFacing(j, opposite(w)) : 0; if (ej < 0) ej = 0;
        cj[n] = j; ce[n] = ej; n++;
      }
      int fr[3], m = 0; for (int k = 0; k < n; k++) if (fxA[cj[k] * 3 + ce[k]] < 0.5f) fr[m++] = k;
      int pick = m ? fr[(int)(frand() * m) % m] : n ? (int)(frand() * n) % n : -1;
      if (pick < 0) {                                           // hier geht es nicht weiter: erst die anderen Kanten
        if (h.edges) { fxPlan[0] = (fxHeadE + 1) % 3; fxPlan[1] = (fxHeadE + 2) % 3; fxPlanN = 2; fxPlanP = 0; }
        fxA[fxHead * 3 + fxHeadE] = 1; continue;
      }
      fxHead = cj[pick]; fxHeadE = ce[pick]; fxA[fxHead * 3 + fxHeadE] = 1; fxPlanN = fxPlanP = 0;
      const Panel& q = P[fxHead];
      if (q.edges) {                                             // Reihenfolge im neuen Panel festlegen
        auto nb = [&](int e) { int nx, ny; neighbor(q.x, q.y, worldDir(q, e), nx, ny); return findAt(nx, ny) >= 0; };
        int e0 = fxHeadE, fw = (e0 + 2) % 3, bw = (e0 + 1) % 3;     // vorwärts endet bei e0+2, rückwärts bei e0+1
        bool f = nb(fw), b = nb(bw), dirF = f && b ? frand() < 0.5f : f ? true : b ? false : frand() < 0.5f;
        fxPlan[0] = dirF ? (e0 + 1) % 3 : (e0 + 2) % 3; fxPlan[1] = dirF ? fw : bw; fxPlanN = 2;
        if (!f && !b) fxPlan[fxPlanN++] = e0;                       // Sackgasse: zurück zur Eingangskante
      }
    }
    float ik = 1 - fx.inten / 255.0f;                         // Intensität = Schweiflänge: 0 kurz … 255 sehr lang
    float dec = dt * rate * (0.1f + 2.4f * ik * ik);
    for (int s = 0; s < SLOTS * 3; s++) if (s != fxHead * 3 + fxHeadE) fxA[s] = fmaxf(0, fxA[s] - dec);
  }
  // Raum-Effekte: gemeinsame Uhr und Stelle im Raum
  double rT = 0;
  if (fx.id >= 24) { room::frame(); rT = room::tsec(); }
  int beat = (int)(fxPhase * 2);                  // Disco: zweimal pro Takt neue Farben
  bool newBeat = beat != fxBeat; fxBeat = beat;

  for (int i = 0; i < SLOTS; i++) {
    const Panel& p = P[i];
    if (!p.used || !p.attached || p.state == DARK) { memset(TGT[i], 0, sizeof TGT[i]); continue; }
    bool up = isUp(p.x, p.y);
    int points = p.edges ? 3 : 1;
    for (int e = 0; e < points; e++) {
      // Position des Punkts: Mitte des Panels oder Mitte der Kante e (Seitenlänge 1)
      float px, py, dd; edgePos(i, p.edges ? e : -1, px, py, dd);   // Kante zum Elternpanel liegt näher am Hauptpanel
      float c[4] = {0, 0, 0, 0};
      int s = i * 3 + e;                                       // eigener Zufallszustand pro Punkt
      float rx, ry; effXY(px, py, rx, ry);
      float u = (rx - minX) / spanX;                            // 0 links … 1 rechts (so wie die Wand hängt)
      float v = ry;
      float depth = p.depth + dd;
      const float K = fx.inten / 255.0f;                       // Intensität 0..1
      switch (fx.id) {
        case 1: pcol(fxPhase * 0.1f + u * K * 0.6f, c, D_HUE); break;
        case 2: pcol(fxPhase * 0.15f + u * (0.2f + 1.6f * K), c, D_HUE); break;
        case 3: {
          float lo = 0.02f + 0.45f * (1 - K);
          pcol(fxPhase * 0.05f + u * 0.3f, c, D_COLOR);
          mul(c, lo + (1 - lo) * (0.5f + 0.5f * cosf(fxPhase * TAU / 4 - (p.edges ? u * 0.6f : 0)))); break;
        }
        case 4: {
          fxT[s] += dt * rate / 3.5f;
          if (fxT[s] >= 1) { fxA[s] = fxB[s]; fxB[s] = fxA[s] + (frand() * 2 - 1) * (0.1f + 0.4f * K); fxT[s] = 0; }
          float d = fxB[s] - fxA[s]; d -= floorf(d + 0.5f);
          float t = fxT[s] * fxT[s] * (3 - 2 * fxT[s]);
          pcol(fxA[s] + d * t, c, D_HUE); break;
        }
        case 5: {
          fxA[s] = fmaxf(0, fxA[s] - dt * rate * 2.2f);
          if (frand() < dt * rate * (0.05f + 0.9f * K) / points) fxA[s] = 1;
          float a = fxA[s] * fxA[s];
          pcol(u * 0.5f + fxPhase * 0.03f, c, D_COLOR);
          mul(c, 0.18f + 0.5f * a); c[3] = fminf(255, c[3] + 255 * a); break;
        }
        case 6: {
          float w = 0.5f + 0.5f * cosf(TAU * (fxPhase * 0.5f - depth * 0.17f));
          pcol(fxPhase * 0.1f - depth * 0.08f, c, D_COLOR);
          mul(c, 0.05f + 0.95f * powf(w, 1 + 7 * (1 - K))); break;
        }
        case 7: {
          fxA[s] += (frand() - fxA[s]) * fminf(1, dt * rate * 9);
          fxB[s] += (fxA[s] - fxB[s]) * fminf(1, dt * rate * 5);
          float h = 1 - (0.2f + 0.8f * K) * (1 - fxB[s]);
          if (fx.pal == 0) fireColor(h, c); else { pcol(h * 0.5f, c, D_FIRE); mul(c, h); }
          break;
        }
        case 8: {
          float sv = 0.5f + 0.5f * sinf(u * 5.0f + fxPhase * 0.9f + v * 0.7f) * sinf(u * 2.3f - fxPhase * 0.55f);
          pcol(fxPhase * 0.04f + u * 0.48f, c, D_AURORA);
          mul(c, 1 - (0.3f + 0.7f * K) * (1 - sv)); break;
        }
        case 9: {                                              // Lauflicht: ein heller Streifen mit Schweif
          float d = u - (fxPhase * 0.2f - floorf(fxPhase * 0.2f)); d -= floorf(d);
          d = 1 - d;                                           // Abstand hinter dem Streifen
          pcol(fxPhase * 0.02f, c, D_COLOR);
          mul(c, 0.03f + 0.97f * expf(-d * (3 + 14 * K))); break;
        }
        case 10: {                                             // Spirale um die Mitte der Wand
          float a = atan2f(v - cyW, rx - cxW) / TAU, r = hypotf(rx - cxW, v - cyW) / maxR;
          pcol(a + fxPhase * 0.08f + r * (0.2f + 1.2f * K), c, D_HUE); break;
        }
        case 11: {                                             // Gewitter: dunkelblau, Blitze in der Nähe eines Panels
          float d2 = (rx - fxFlashX) * (rx - fxFlashX) + (v - fxFlashY) * (v - fxFlashY);
          float f = fxFlash * expf(-d2 / (1.5f + 3 * K)) * (0.7f + 0.3f * frand());
          if (fx.pal) { pcol(0.1f, c, D_COLOR); mul(c, 0.12f); } else { c[0] = 2; c[1] = 6; c[2] = 34; }
          c[0] += 170 * f; c[1] += 170 * f; c[2] += 255 * f; c[3] += 255 * f; break;
        }
        case 12: {                                             // Kerzenlicht: warm, ruhig flackernd
          fxA[s] += (frand() - fxA[s]) * fminf(1, dt * rate * 6);
          fxB[s] += (fxA[s] - fxB[s]) * fminf(1, dt * rate * 3);
          float h = 1 - (0.15f + 0.5f * K) * (1 - fxB[s]);
          if (fx.pal == 0) { c[0] = 255 * h; c[1] = 105 * h * h; c[2] = 12 * h; c[3] = 70 * h * h; }
          else { pcol(fxB[s] * 0.3f, c, D_FIRE); mul(c, h); }
          break;
        }
        case 13: {                                             // Disco: im Takt neue Farben
          if (newBeat && frand() < 0.3f + 0.7f * K) fxA[s] = frand();
          pcol(fxA[s], c, D_HUE); break;
        }
        case 14: {                                             // Komet: heller Kopf, der durch die Wand wandert
          float b = fxA[s];
          pcol(fxPhase * 0.03f, c, D_COLOR);
          mul(c, 0.02f + 0.98f * powf(b, 1.6f));
          if (i == fxHead && e == fxHeadE) c[3] = fminf(255, c[3] + 120);
          break;
        }
        case 16: {                                             // Farbverlauf: ruhig, in Effektrichtung, wandert mit dem Tempo
          float t = u * (0.6f + 1.4f * K) + (fx.speed > 1 ? fxPhase * 0.02f : 0);
          if (fx.pal == 0) {                                   // Standard: Effektfarbe → Farbe 2 → zurück
            float m = t - floorf(t); m = m < 0.5f ? m * 2 : 2 - m * 2; m = m * m * (3 - 2 * m);
            const float a1[4] = {(float)fx.r, (float)fx.g, (float)fx.b, (float)fx.w};
            for (int ch = 0; ch < 4; ch++) c[ch] = a1[ch] + (fxC2[ch] - a1[ch]) * m;
          } else pcol(t * 0.5f, c, D_COLOR);
          break;
        }
        case 15: {                                             // Lava: langsam fließende Blasen
          float sv = 0.5f + 0.5f * sinf(u * 4.0f + fxPhase * 0.35f + 1.5f * sinf(v * 1.8f - fxPhase * 0.25f));
          pcol(sv * 0.5f + fxPhase * 0.02f, c, D_FIRE);
          mul(c, 0.2f + 0.8f * powf(sv, 1 + 2 * K)); break;
        }
        case 17: {                                             // Herzschlag: doppelter Puls, läuft vom Hauptpanel nach außen
          float t = fxPhase * 0.8f - depth * (0.03f + 0.08f * K); t -= floorf(t);
          float b = expf(-(t * t) / 0.003f) + 0.65f * expf(-((t - 0.2f) * (t - 0.2f)) / 0.003f);
          pcol(fxPhase * 0.02f, c, D_COLOR);
          mul(c, 0.06f + 0.94f * fminf(1, b)); break;
        }
        case 18: {                                             // Plasma: ineinander fließende Farben
          float sv = sinf(u * (3 + 5 * K) + fxPhase * 0.6f) + sinf(v * 2.2f - fxPhase * 0.45f) + sinf((u + v) * 2.5f + fxPhase * 0.3f);
          pcol(sv * 0.17f + fxPhase * 0.03f, c, D_HUE); break;
        }
        case 19: {                                             // Regen: einzelne Tropfen blitzen auf, darunter dunkles Blau
          fxA[s] = fmaxf(0, fxA[s] - dt * rate * 3.5f);
          if (frand() < dt * rate * (0.15f + 1.6f * K) / points) fxA[s] = 1;
          float a = fxA[s] * fxA[s];
          if (fx.pal == 0) { c[0] = 4 + 40 * a; c[1] = 10 + 110 * a; c[2] = 40 + 215 * a; c[3] = 60 * a; }
          else { pcol(u * 0.4f + fxPhase * 0.02f, c, D_COLOR); mul(c, 0.12f + 0.88f * a); }
          break;
        }
        case 20: {                                             // Sternenhimmel: dunkel, einzelne Sterne funkeln langsam
          float tw = 0.5f + 0.5f * sinf(fxPhase * (0.6f + fxB[s]) + fxA[s] * TAU);
          float star = fxB[s] > 0.55f - 0.35f * K ? powf(tw, 6) : 0;
          if (fx.pal == 0) { c[0] = 2 + 60 * star; c[1] = 3 + 70 * star; c[2] = 18 + 90 * star; c[3] = 200 * star; }
          else { pcol(fxA[s], c, D_COLOR); mul(c, 0.05f + 0.95f * star); }
          break;
        }
        case 21: {                                             // Feuerwerk: Ring breitet sich von der Rakete aus und verglüht
          float d = hypotf(rx - fwX, v - fwY), r = fwT * 2.6f, life = fmaxf(0, 1 - fwT / 1.4f);
          float a = expf(-(d - r) * (d - r) / 0.25f) * life + (fwT < 0.12f && d < 0.4f ? 1 : 0);
          pcol(fwH + d * 0.08f, c, D_HUE);
          mul(c, fminf(1, a)); c[3] = fminf(255, c[3] + (fwT < 0.15f ? 255 * a : 40 * a * life)); break;
        }
        case 22: {                                             // Matrix: grüne Ströme fallen nach unten
          float off = sinf(roundf(rx * 2) * 12.9898f) * 43758.5f; off -= floorf(off);
          float d = v * 0.35f - fxPhase * 0.35f + off; d -= floorf(d);
          float b = powf(1 - d, 3 + 8 * K);
          if (fx.pal == 0) { c[0] = 0; c[1] = 20 + 235 * b; c[2] = 30 * b * b; c[3] = d > 0.96f ? 160 : 0; }
          else { pcol(off, c, D_COLOR); mul(c, 0.05f + 0.95f * b); }
          break;
        }
        case 23: {                                             // Wetter: Farbe nach Außentemperatur, dazu Regen- oder Schneetropfen
          float tc[4]; tempColor(wxOk ? wxTemp : 15, tc);
          float br = 0.55f + 0.15f * sinf(fxPhase * 0.5f - u * 2);
          for (int ch = 0; ch < 4; ch++) c[ch] = tc[ch] * br;
          if (wxOk && wxKind) {
            fxA[s] = fmaxf(0, fxA[s] - dt * rate * 2.5f);
            if (frand() < dt * rate * (0.2f + 1.2f * K) / points) fxA[s] = 1;
            float a = fxA[s] * fxA[s];
            if (wxKind == 1) { c[0] *= 1 - a; c[1] = c[1] * (1 - a) + 90 * a; c[2] = c[2] * (1 - a) + 255 * a; }
            else { c[0] += 120 * a; c[1] += 120 * a; c[2] += 140 * a; c[3] += 220 * a; }
          }
          break;
        }
        case 24: {                                             // Raum-Komet: irrt wie der Komet durch alle Wände im Raum
          float ik = 1 - K, tail = 4 / (0.1f + 2.4f * ik * ik);   // Intensität = Schweiflänge wie beim Komet
          bool hd; float b = room::comet(i, p.edges ? e : -1, tail, hd);
          pcol((float)fmod(room::stepF * 0.0075, 1.0), c, D_COLOR);
          mul(c, 0.02f + 0.98f * powf(b, 1.6f));
          if (hd) c[3] = fminf(255, c[3] + 120);
          break;
        }
        case 25: {                                             // Raum-Regenbogen: Farben ziehen durch den ganzen Raum
          float W = room::S * (3 + 25 * (1 - K));
          pcol(room::at(px, py) / W - (float)fmod(rT * rate * 0.15, 1000.0), c, D_HUE); break;
        }
        case 27: {                                             // Raum-Feuerwerk: Raketen explodieren an Panels im ganzen Raum
          float S = room::S, period = (1.6f - 0.8f * K);
          double bt = rT * rate; uint32_t k0 = (uint32_t)(bt / period);
          float u, h; room::ownPos(px, py, u, h);
          for (uint32_t k = k0 > 0 ? k0 - 1 : 0; k <= k0; k++) {
            float bu, bh, bhue; if (!room::burst(k, bu, bh, bhue)) break;
            float age = (float)(bt - k * (double)period), du = fabsf(u - bu);
            if (room::Ptot > 0) { du = fmodf(du, room::Ptot); du = fminf(du, room::Ptot - du); }
            float d = hypotf(du, h - bh) / S, rad = age * 5, f = fmaxf(0, 1 - age / 1.6f);
            float a = expf(-(d - rad) * (d - rad) / 0.6f) * f * f;
            if (a < 0.01f) continue;
            float cc[4]; if (fx.pal) pcol(bhue, cc, D_HUE); else hue(bhue, cc);
            for (int ch = 0; ch < 4; ch++) c[ch] += cc[ch] * a;
            if (d < 0.6f && age < 0.25f) c[3] += 200 * (1 - age / 0.25f);   // heller Blitz in der Mitte
          }
          break;
        }
        case 28: {                                             // Raum-Pingpong: ein Lichtpunkt springt zwischen den Panelwänden hin und her
          float S = room::S, L = fmaxf(S, room::Lc);
          float pos = (float)fmod(rT * rate * S * 4, 2.0 * L); if (pos > L) pos = 2 * L - pos;
          float d = fabsf(room::at(px, py) - pos) / S;
          pcol((float)fmod(rT * rate * 0.05, 1.0), c, D_COLOR);
          mul(c, 0.02f + 0.98f * expf(-d * d / (0.3f + 3 * K * K)));
          break;
        }
        case 29: {                                             // Raum-Atmen: Atmen, das als Welle von der Mitte durch den Raum läuft
          float S = room::S, L = fmaxf(S, room::Lc), dist = fabsf(room::at(px, py) - L / 2);
          float b = 0.5f + 0.5f * cosf(6.2831853f * ((float)fmod(rT * rate * 0.2, 1000.0) - dist / (S * (6 + 20 * (1 - K)))));
          pcol((float)fmod(rT * rate * 0.01, 1.0), c, D_COLOR);
          mul(c, 0.04f + 0.96f * b * b);
          break;
        }
        case 26: {                                             // Raum-Welle: helle Wellen laufen durch den Raum
          float W = room::S * (4 + 20 * (1 - K)), uu = room::at(px, py);
          float b = 0.5f + 0.5f * sinf(6.2831853f * (uu / W - (float)fmod(rT * rate * 0.25, 1000.0)));
          pcol(uu / (W * 4), c, D_COLOR); mul(c, 0.05f + 0.95f * b * b); break;
        }
      }
      float k = p.on ? masterK() / 255.0f : 0;
      for (int ch = 0; ch < 4; ch++) TGT[i][e][ch] = (uint8_t)fminf(255, fmaxf(0, c[ch] * k));
    }
    if (!p.edges) { memcpy(TGT[i][1], TGT[i][0], 4); memcpy(TGT[i][2], TGT[i][0], 4); }
  }
}

// ---------- Ausgabe ----------
// Alles, was die Panels zeigen, läuft hier durch: Ziel berechnen (Effekt, feste Farbe oder Pulsieren),
// Stromlimit anwenden, weich überblenden und als FRAME an alle Panels schicken (etwa 25-mal pro Sekunde,
// aber nur, wenn sich etwas ändert, sonst einmal pro Sekunde zur Sicherheit).
uint8_t FROM[SLOTS][3][4], SENT[SLOTS][3][4];
bool isPulse[SLOTS];
uint32_t transStart = 0, transDur = 0, lastKeep = 0;
bool transOn = false;
bool outForce = true, testMode = false;
float powerScale = 1, measScale = 1;

// ---------- Spiel "Simon sagt" ----------
// Die Wand zeigt eine Folge von Panels, man tippt sie nach; jede Runde ein Panel mehr.
namespace game {
enum Ph : uint8_t { G_OFF, G_SHOW, G_INPUT, G_FAIL, G_WIN };   // nicht INPUT: das ist ein Arduino-Makro
Ph ph = G_OFF;
int8_t pan[SLOTS]; uint8_t nPan = 0;      // mitspielende Panels (mit Sensor, ohne Hauptpanel)
uint8_t seq[100]; uint8_t len = 0, pos = 0, best = 0;
uint32_t t0 = 0; int8_t lit = -1; uint32_t litUntil = 0;
bool active() { return ph != G_OFF; }
uint16_t stepMs() { return len < 12 ? 650 - len * 30 : 290; }
void hueOf(uint8_t k, uint8_t* c) {
  float h = (float)k / nPan * 6; int s = (int)h; float f = h - s, q = 1 - f; float r, g, b;
  switch (s % 6) { case 0: r = 1; g = f; b = 0; break; case 1: r = q; g = 1; b = 0; break; case 2: r = 0; g = 1; b = f; break;
                   case 3: r = 0; g = q; b = 1; break; case 4: r = f; g = 0; b = 1; break; default: r = 1; g = 0; b = q; }
  c[0] = r * 255; c[1] = g * 255; c[2] = b * 255; c[3] = 0;
}
void next() { if (len < sizeof seq) seq[len++] = esp_random() % nPan; pos = 0; ph = G_SHOW; t0 = millis(); }
const char* start() {
  nPan = 0;
  for (int i = 1; i < SLOTS; i++) if (P[i].used && P[i].attached && P[i].state != DARK && (P[i].caps & 1)) pan[nPan++] = i;
  if (nPan < 2) return "Zum Spielen braucht es mindestens 2 Panels mit Sensor";
  if (!cfg.touchOn) return "Bitte zuerst unter Antippen „Panels reagieren auf Antippen“ einschalten";
  best = prefs.getUChar("simon", 0);
  len = 0; next(); t0 = millis() + 600;
  diag("Spiel gestartet");
  return nullptr;
}
void stop() { ph = G_OFF; lit = -1; outForce = true; }
void over() {
  uint8_t score = len ? len - 1 : 0;
  if (score > best) { best = score; prefs.putUChar("simon", best); }
  diag("Spiel vorbei: %u Runden geschafft", score);
  ph = G_FAIL; t0 = millis();
}
void tap(int slot) {
  if (ph != G_INPUT) return;
  int8_t k = -1; for (uint8_t j = 0; j < nPan; j++) if (pan[j] == slot) k = j;
  if (k < 0) return;
  lit = k; litUntil = millis() + 250;
  if (k != seq[pos]) { over(); return; }
  if (++pos >= len) { ph = G_WIN; t0 = millis(); }
  else t0 = millis();                                      // Zeit für den nächsten Tipp läuft neu
}
// läuft mit jedem Bild: Ablauf weiterschalten und die Wand zeichnen
void draw(uint8_t TG[][3][4]) {
  if (ph == G_OFF) return;
  uint32_t now = millis();
  int32_t t = (int32_t)(now - t0);
  if (ph == G_SHOW && t >= 0 && t / (stepMs() + 180) >= len) { ph = G_INPUT; t0 = now; }
  if (ph == G_INPUT && t > 8000) over();                      // 8 s ohne Tipp: vorbei
  if (ph == G_WIN && t > 700) { next(); t0 = now + 300; }
  if (ph == G_FAIL && t > 1800) { stop(); return; }
  t = (int32_t)(now - t0);
  for (int i = 0; i < SLOTS; i++) for (int e = 0; e < 3; e++) for (int c = 0; c < 4; c++) TG[i][e][c] = 0;
  for (uint8_t j = 0; j < nPan; j++) {
    uint8_t c[4]; hueOf(j, c); float k = 0.08f;
    if (ph == G_SHOW && t >= 0) { uint16_t st = stepMs(); int n = t / (st + 180); if (n < len && seq[n] == j && t % (st + 180) < st) k = 1; }
    if (ph == G_INPUT && lit == j && now < litUntil) k = 1;
    if (ph == G_WIN) k = 0.5f + 0.5f * ((t / 120) % 2);
    if (ph == G_FAIL) { c[0] = 255; c[1] = c[2] = c[3] = 0; k = (t / 250) % 2 ? 0.1f : 1; }
    for (int e = 0; e < 3; e++) for (int ch = 0; ch < 4; ch++) TG[pan[j]][e][ch] = c[ch] * k;
  }
  // Hauptpanel zeigt die Runde: weiß, je weiter, desto heller
  for (int e = 0; e < 3; e++) TG[0][e][3] = ph == G_FAIL ? 0 : 20 + (len > 20 ? 200 : len * 10);
}
uint8_t level() { return len ? len - (ph == G_SHOW || ph == G_WIN ? 1 : 0) : 0; }
void json(JsonObject o) { o["on"] = active(); o["level"] = level(); o["ph"] = (int)ph; o["best"] = best ? best : prefs.getUChar("simon", 0); }
}  // namespace game

// Tageslicht-Kurve nach Uhrzeit: (Stunde, Helligkeit, Wärme), dazwischen linear
const float DAYC[][3] = {{0, 0.35f, 1}, {6, 0.35f, 1}, {7.5f, 1, 0}, {18, 1, 0}, {21, 0.75f, 0.7f}, {23, 0.45f, 1}, {24, 0.35f, 1}};
void dayCurveAt(float h, float& dim, float& warm) {
  for (uint8_t k = 0; k + 1 < sizeof DAYC / sizeof DAYC[0]; k++)
    if (h >= DAYC[k][0] && h <= DAYC[k + 1][0]) {
      float f = (h - DAYC[k][0]) / (DAYC[k + 1][0] - DAYC[k][0]);
      dim = DAYC[k][1] + (DAYC[k + 1][1] - DAYC[k][1]) * f; warm = DAYC[k][2] + (DAYC[k + 1][2] - DAYC[k][2]) * f; return;
    }
  dim = 1; warm = 0;
}
void dayCurve(float& dim, float& warm) {
  time_t t = time(nullptr); struct tm lt; localtime_r(&t, &lt);
  dayCurveAt(lt.tm_hour + lt.tm_min / 60.0f, dim, warm);
}
float sleepScale = 1;                     // Sleep-Timer: blendet zum Ende hin aus
// Wellen beim Antippen: laufen vom angetippten Panel als Ring über die Wand
struct Ripple { uint32_t t0; float x, y; bool room; };   // room: x/y sind Stelle im Raum (cm entlang der Raumwände, Höhe)
Ripple ripples[3];
const float RIPPLE_SPEED = 4.5f;          // Panels pro Sekunde
// Einschalt-Animation: Panel für Panel vom Hauptpanel nach außen
uint32_t onAnimAt = 0; bool lastMasterOn = false;
const uint16_t ON_STEP[4] = {0, 420, 210, 90}, ON_FADE[4] = {0, 600, 350, 180};   // ms je Abstand und Einblenddauer
// Signal (Benachrichtigung): die ganze Wand blinkt ein paar Mal in einer Farbe, danach läuft alles weiter
uint32_t sigAt = 0; uint8_t sigCol[4] = {0, 0, 255, 0}, sigBlinks = 3; uint16_t sigMs = 700;
// Fortschritt: die Wand füllt sich vom Hauptpanel aus (0 = aus)
float progVal = 0; uint8_t progCol[4] = {0, 255, 40, 0};
// Zeit seit t in ms; nie negativ (t wird mit "| 1" gesetzt und kann daher 1 ms in der Zukunft liegen)
uint32_t since(uint32_t t, uint32_t now) { int32_t d = (int32_t)(now - t); return d < 0 ? 0 : (uint32_t)d; }
bool overlayActive() {
  uint32_t now = millis();
  if (transOn) return true;                          // weiche Übergänge auch in der App zeigen
  for (const Ripple& r : ripples) if (r.t0 && now - r.t0 < 9500) return true;
  return (onAnimAt && now - onAnimAt < 6000) || sigAt || progVal > 0 || game::active();
}
int freeRipple() { int k = 0; for (int j = 1; j < 3; j++) if (ripples[j].t0 < ripples[k].t0) k = j; return k; }
// Welle von einer Stelle im Raum; t: Uhrzeit (Sekunden seit Mitternacht), zu der angetippt wurde (-1: jetzt)
void roomRipple(float u, float h, double t) {
  if (!cfg.touchWave || room::me < 0) return;
  double late = t >= 0 && timeOk() ? room::tsec() - t : 0;
  if (late < 0 || late > 3) late = 0;
  int k = freeRipple(); ripples[k].t0 = (millis() - (uint32_t)(late * 1000)) | 1; ripples[k].x = u; ripples[k].y = h; ripples[k].room = true;
}
void addRipple(int i) {
  if (!cfg.touchWave || i < 0 || i >= SLOTS) return;
  if (room::me >= 0) {                                   // im Raum: Welle läuft über alle Panelwände
    float u, h; room::ownPos(P[i].x * 0.5f, P[i].y * 0.866f, u, h);
    roomRipple(u, h, -1);
    char b[96]; snprintf(b, sizeof b, "{\"action\":\"tap\",\"fwd\":false,\"u\":%.1f,\"h\":%.1f,\"t\":%.3f}", u, h, room::tsec());
    room::fanout("/api/room", b);
    return;
  }
  int k = freeRipple();
  ripples[k].t0 = millis() | 1; ripples[k].x = P[i].x * 0.5f; ripples[k].y = P[i].y * 0.866f; ripples[k].room = false;
}
uint32_t estMa = 0;                       // geschätzter Strom aller LEDs und Panels in mA (bei 24 V)
const uint8_t SEG_PER_PANEL = 3;          // LED-Segmente pro Panel (eins pro Kante)
const uint16_t IDLE_PANEL_MA = 12, IDLE_MAIN_MA = 25;

// ab jetzt vom aktuellen Bild weich zum neuen Ziel überblenden
void transition() {
  memcpy(FROM, CUR, sizeof CUR);
  transDur = cfg.transMs;
  transStart = millis();
  transOn = transDur > 0;
  outForce = true;
  fxLastFrame = 0;
}

void computeTargets() {
  uint32_t now = millis();
  if (fx.id) fxCompute();
  for (int i = 0; i < SLOTS; i++) {
    const Panel& p = P[i];
    isPulse[i] = false;
    if (!p.used || !p.attached || p.state == DARK || !masterOn) { memset(TGT[i], 0, sizeof TGT[i]); continue; }
    bool joining = fx.id && p.joinAt && (int32_t)(now - p.joinAt) < 0;
    if (joining || (!fx.id && p.state == PULSE)) {               // blau pulsieren wie bisher die Panels selbst
      uint32_t t = (now - (joining ? p.joinAt - FX_JOIN_MS : p.since)) % 1600;
      t = t < 800 ? t : 1600 - t;
      uint8_t lv = (uint8_t)(6 + (t * 26) / 800);
      for (int e = 0; e < 3; e++) { TGT[i][e][0] = 0; TGT[i][e][1] = 0; TGT[i][e][2] = lv; TGT[i][e][3] = 0; }
      isPulse[i] = true;
      continue;
    }
    if (fx.id) continue;                                         // Effektbild steht schon in TGT
    uint32_t k = p.on ? (uint32_t)p.bri * master : 0;
    uint8_t c[4] = {(uint8_t)(p.r * k / 65025), (uint8_t)(p.g * k / 65025), (uint8_t)(p.b * k / 65025), (uint8_t)(p.w * k / 65025)};
    for (int e = 0; e < 3; e++) memcpy(TGT[i][e], c, 4);
  }
  // Fortschritt: Panels nach Abstand zum Hauptpanel (bei gleichem Abstand von links nach rechts) der Reihe nach füllen
  if (progVal > 0) {
    int8_t ord[SLOTS]; float key[SLOTS]; int n = 0;
    for (int i = 0; i < SLOTS; i++) {
      if (!P[i].used || !P[i].attached) continue;
      float rx, ry; viewXY(P[i].x * 0.5f, P[i].y * 0.866f, rx, ry);
      float k = P[i].depth * 1000 + rx;
      int j = n++; while (j > 0 && key[j - 1] > k) { key[j] = key[j - 1]; ord[j] = ord[j - 1]; j--; }
      key[j] = k; ord[j] = i;
    }
    float lit = progVal / 100.0f * n, kb = (masterOn ? master : 150) / 255.0f;
    for (int j = 0; j < n; j++) {
      int i = ord[j]; isPulse[i] = false;
      float a = fminf(1, fmaxf(0, lit - j));
      for (int e = 0; e < 3; e++) {
        float ae = a;
        if (P[i].edges) { int ein = -1; for (int k = 0; k < 3; k++) { float x, y, dd; edgePos(i, k, x, y, dd); if (dd < 0) ein = k; }
          int rank = e == ein ? 0 : (ein < 0 ? e : 1); if (ein >= 0 && e != ein) for (int k = 0; k < e; k++) if (k != ein) rank++;
          ae = fminf(1, fmaxf(0, a * 3 - rank)); }
        ae = 0.06f + 0.94f * ae;                                   // noch nicht erreicht: ganz schwach
        for (int c = 0; c < 4; c++) TGT[i][e][c] = (uint8_t)(progCol[c] * ae * kb);
      }
    }
  }
  // Signal: Farbe an, normales Bild, Farbe an … (auch bei ausgeschalteter Wand)
  if (sigAt) {
    uint32_t ph = since(sigAt, now) / (sigMs / 2);
    if (ph >= (uint32_t)sigBlinks * 2) sigAt = 0;
    else if (ph % 2 == 0) for (int i = 0; i < SLOTS; i++) {
      if (!P[i].used || !P[i].attached) continue;
      isPulse[i] = false;
      for (int e = 0; e < 3; e++) memcpy(TGT[i][e], sigCol, 4);
    }
  }
  // Einschalt-Animation: beim Einschalten leuchten die Panels der Reihe nach auf, nach Abstand zum Hauptpanel
  if (masterOn && !lastMasterOn && cfg.onAnim) { onAnimAt = now | 1; transOn = false; }
  lastMasterOn = masterOn;
  if (onAnimAt) {
    uint32_t t = since(onAnimAt, now); bool done = true;
    for (int i = 0; i < SLOTS; i++) {
      if (!P[i].used || !P[i].attached || isPulse[i]) continue;
      for (int e = 0; e < 3; e++) {
        float x, y, dd = 0; if (P[i].edges) edgePos(i, e, x, y, dd);
        int32_t local = (int32_t)t - (int32_t)((P[i].depth + dd + (P[i].edges ? 0.33f : 0)) * ON_STEP[cfg.onAnim]);
        float k = local <= 0 ? 0 : fminf(1, (float)local / ON_FADE[cfg.onAnim]);
        if (k < 1) { done = false; k = k * k * (3 - 2 * k); for (int c = 0; c < 4; c++) TGT[i][e][c] = (uint8_t)(TGT[i][e][c] * k); }
      }
    }
    if (done || !masterOn) onAnimAt = 0;
  }
  // Wellen beim Antippen: heller Ring, der sich ausbreitet und dabei verblasst
  for (Ripple& r : ripples) {
    if (!r.t0) continue;
    float t = since(r.t0, now) / 1000.0f, rad = t * RIPPLE_SPEED;
    float life = r.room ? fminf(9, fmaxf(3.5f, room::Ptot / 2 / (RIPPLE_SPEED * room::S) + 1.5f)) : 3.5f;
    if (t > life) { r.t0 = 0; continue; }
    float fade = 1 - t / life;
    for (int i = 0; i < SLOTS; i++) {
      if (!P[i].used || !P[i].attached || P[i].state == DARK) continue;
      for (int e = 0; e < 3; e++) {
        float x, y, dd; edgePos(i, P[i].edges ? e : -1, x, y, dd);
        float d;
        if (r.room) {                                        // Abstand im Raum (entlang der Raumwände), in Panel-Seitenlängen
          float u, h; room::ownPos(x, y, u, h); float du = fabsf(u - r.x);
          if (room::Ptot > 0) { du = fmodf(du, room::Ptot); du = fminf(du, room::Ptot - du); }
          d = hypotf(du, h - r.y) / room::S;
        } else d = hypotf(x - r.x, y - r.y);
        float a = expf(-(d - rad) * (d - rad) / (P[i].edges ? 0.12f : 0.35f)) * fade;
        if (a < 0.02f) continue;
        TGT[i][e][0] = (uint8_t)fminf(255, TGT[i][e][0] + 90 * a); TGT[i][e][1] = (uint8_t)fminf(255, TGT[i][e][1] + 90 * a);
        TGT[i][e][2] = (uint8_t)fminf(255, TGT[i][e][2] + 110 * a); TGT[i][e][3] = (uint8_t)fminf(255, TGT[i][e][3] + 230 * a);
      }
    }
  }
  game::draw(TGT);
  // Störungsanzeige: Hauptpanel blinkt alle 10 s zweimal kurz (orange: WLAN weg, rot: ein Panel antwortet nicht mehr)
  if (cfg.faultBlink && masterOn && !game::active()) {
    bool wifiBad = !wlanOk && wSsid.length() && !apMode;
    bool panelBad = faultPanelAt && now - faultPanelAt < 120000;
    uint32_t fp = now % 10000;
    if ((wifiBad || panelBad) && (fp < 150 || (fp >= 300 && fp < 450)))
      for (int e = 0; e < 3; e++) { TGT[0][e][0] = 255; TGT[0][e][1] = panelBad ? 0 : 90; TGT[0][e][2] = 0; TGT[0][e][3] = 0; }
  }
  // Tageslicht-Kurve: abends wärmer (weniger Blau und Grün) und dunkler, tagsüber unverändert
  if (cfg.daylight && timeOk()) {
    float dim, warm; dayCurve(dim, warm);
    if (dim < 0.999f || warm > 0.001f) {
      const float k[4] = {dim, dim * (1 - 0.3f * warm), dim * (1 - 0.8f * warm), dim * (1 - 0.15f * warm)};
      for (int i = 0; i < SLOTS; i++) if (P[i].used && P[i].attached && !isPulse[i]) for (int e = 0; e < 3; e++) for (int c = 0; c < 4; c++) TGT[i][e][c] = (uint8_t)(TGT[i][e][c] * k[c]);
    }
  }
  // Stromlimit: Strom schätzen und bei Bedarf alles gleichmäßig dunkler machen (wie WLED)
  uint32_t led = 0, idle = 0;
  for (int i = 0; i < SLOTS; i++) {
    if (!P[i].used || !P[i].attached) continue;
    idle += i == 0 ? IDLE_MAIN_MA : IDLE_PANEL_MA;
    for (int e = 0; e < 3; e++) led += (uint32_t)(TGT[i][e][0] + TGT[i][e][1] + TGT[i][e][2] + TGT[i][e][3]) * cfg.pwrCh / 255;
  }
  powerScale = 1;
  if (cfg.pwrMax && led) {
    float avail = (float)cfg.pwrMax - idle;
    powerScale = avail <= 0 ? 0 : fminf(1, avail / led);
  }
  float sc = powerScale * measScale * sleepScale;
  estMa = idle + (uint32_t)(led * sc);
  if (sc < 0.999f) for (int i = 0; i < SLOTS; i++) if (!isPulse[i]) for (int e = 0; e < 3; e++) for (int c = 0; c < 4; c++) TGT[i][e][c] = (uint8_t)(TGT[i][e][c] * sc);
  // Panel finden: blinkt dreimal pro Sekunde weiß, auch wenn die Wand aus ist
  for (int i = 0; i < SLOTS; i++) {
    if (!P[i].identUntil) continue;
    if ((int32_t)(now - P[i].identUntil) >= 0 || !P[i].attached) { P[i].identUntil = 0; continue; }
    bool lit = (P[i].identUntil - now) % 333 > 166;
    for (int e = 0; e < 3; e++) { TGT[i][e][0] = TGT[i][e][1] = TGT[i][e][2] = lit ? 90 : 0; TGT[i][e][3] = lit ? 200 : 0; }
  }
}

// FRAME: eine Farbe pro Panel; FRAME3: drei Farben pro Panel (ab Panel-Firmware 2).
// Panels mit Kanten einzeln und alter Firmware bekommen ihre drei Farben zusätzlich per EDGES.
void sendOutput(bool force) {
  bool mainChanged = force || memcmp(SENT[0], CUR[0], sizeof CUR[0]);
  if (cfg.pins.led >= 0 && mainChanged) {
    for (int k = 0; k < 3; k++) strip.setPixelColor(k, strip.Color(CUR[0][k][0], CUR[0][k][1], CUR[0][k][2], CUR[0][k][3]));   // Pixel k = Kante k
    strip.show();
  }
  memcpy(SENT[0], CUR[0], sizeof CUR[0]);
  if (!cfg.bus) { memcpy(SENT, CUR, sizeof CUR); return; }
  bool changed = force, anyEdges = false, allNew = true;
  uint8_t lo = 0xFF, hi = 0;
  for (int i = 1; i < SLOTS; i++) {
    const Panel& p = P[i];
    if (!p.used || !p.attached || !p.addr) continue;
    if (p.addr < lo) lo = p.addr; if (p.addr > hi) hi = p.addr;
    if (memcmp(SENT[i], CUR[i], sizeof CUR[i])) changed = true;
    if (p.edges) anyEdges = true;
    if (p.fw < 2) allNew = false;
  }
  if (lo > hi || !changed) return;
  if (anyEdges && allNew) {
    for (uint8_t first = lo; first <= hi; first += 16) {        // 16 Panels × 12 Byte pro Rahmen
      uint8_t n = (hi - first + 1) > 16 ? 16 : (hi - first + 1);
      uint8_t d[2 + 16 * 12] = {first, n};
      for (int i = 1; i < SLOTS; i++) {
        const Panel& p = P[i];
        if (!p.used || !p.attached || p.addr < first || p.addr >= first + n) continue;
        memcpy(d + 2 + 12 * (p.addr - first), CUR[i], 12);
      }
      bus::send(bus::ALL, bus::C_FRAME3, d, 2 + 12 * n);
      busFramesSent++;
    }
  } else {
    for (uint8_t first = lo; first <= hi; first += 48) {        // höchstens 48 Panels pro Rahmen (Datenlänge bis 200 Byte)
      uint8_t n = (hi - first + 1) > 48 ? 48 : (hi - first + 1);
      uint8_t d[2 + 48 * 4] = {first, n};
      for (int i = 1; i < SLOTS; i++) {
        const Panel& p = P[i];
        if (!p.used || !p.attached || p.addr < first || p.addr >= first + n) continue;
        memcpy(d + 2 + 4 * (p.addr - first), CUR[i][0], 4);
      }
      bus::send(bus::ALL, bus::C_FRAME, d, 2 + 4 * n);
      busFramesSent++;
    }
    for (int i = 1; i < SLOTS; i++) {                            // Kanten einzeln mit alter Panel-Firmware
      const Panel& p = P[i];
      if (p.used && p.attached && p.addr && p.edges && (force || memcmp(SENT[i], CUR[i], sizeof CUR[i]))) bus::send(p.addr, bus::C_EDGES, &CUR[i][0][0], 12);
    }
  }
  memcpy(SENT, CUR, sizeof CUR);
}

void outLoop() {
  uint32_t now = millis();
  if (testMode || now - fxLastFrame < FX_FRAME_MS) return;
  fxLastFrame = now;
  computeTargets();
  float e = 1;
  if (transOn) {
    e = (float)(uint32_t)(now - transStart) / transDur;
    if (e >= 1) { e = 1; transOn = false; } else e = e * e * (3 - 2 * e);
  }
  for (int i = 0; i < SLOTS; i++) for (int k = 0; k < 3; k++) for (int c = 0; c < 4; c++)
    CUR[i][k][c] = e >= 1 ? TGT[i][k][c] : (uint8_t)(FROM[i][k][c] + (TGT[i][k][c] - FROM[i][k][c]) * e + 0.5f);
  bool keep = now - lastKeep > 1000;               // einmal pro Sekunde alles neu schicken, falls ein Panel neu gestartet ist
  if (keep) lastKeep = now;
  sendOutput(outForce || keep);
  outForce = false;
}

// ---------- Energieverbrauch (gemessen oder geschätzt) ----------
// Wh pro Tag (31), Monat (24) und Jahr (10), dazu gesamt. Datum per NTP, Zeitzone Österreich.
EnergyLog en;
double enPending = 0;                     // Wh, solange die Uhrzeit noch unbekannt ist
bool enDirty = false;

// ---------- Stromsensor INA226 (optional, I²C) ----------
namespace ina {
const uint8_t ADDR = 0x40;
bool ok = false;
float volts = 0, amps = 0;
uint32_t last = 0;
bool wr(uint8_t reg, uint16_t v) { Wire.beginTransmission(ADDR); Wire.write(reg); Wire.write(v >> 8); Wire.write(v & 0xFF); return Wire.endTransmission() == 0; }
bool rd(uint8_t reg, uint16_t& v) {
  Wire.beginTransmission(ADDR); Wire.write(reg);
  if (Wire.endTransmission(false) != 0) return false;
  if (Wire.requestFrom((int)ADDR, 2) != 2) return false;
  v = (uint16_t)(Wire.read() << 8); v |= Wire.read(); return true;
}
bool started = false;
void begin() {
  ok = false; amps = volts = 0;
  if (started) { Wire.end(); started = false; }
  if (cfg.i2cSda < 0 || cfg.i2cScl < 0) return;
  const int8_t used[6] = {cfg.pins.rx, cfg.pins.tx, cfg.pins.de, cfg.pins.led, cfg.pins.snsR, cfg.pins.snsL};
  for (int8_t u : used) if (u == cfg.i2cSda || u == cfg.i2cScl) { logf("[STROM] Sensor-Pin %d ist schon belegt\n", u); return; }
  Wire.begin(cfg.i2cSda, cfg.i2cScl, 400000);
  started = true;
  uint16_t id = 0;
  ok = rd(0xFE, id) && id == 0x5449 && wr(0x00, 0x4527);    // Kennung "TI", 16-fach gemittelt, laufend messen
  logf("[STROM] INA226 %s (SDA %d, SCL %d)\n", ok ? "gefunden" : "nicht gefunden", cfg.i2cSda, cfg.i2cScl);
}
void loop() {
  if (!ok || millis() - last < 250) return;
  last = millis();
  uint16_t sv, bv;
  if (!rd(0x01, sv) || !rd(0x02, bv)) return;
  amps = (int16_t)sv * 2.5f / (cfg.shuntUo * 0.1f) / 1000.0f;   // µV / mΩ = mA
  volts = bv * 1.25e-3f;
  // Regelung nach Messung: liegt der echte Strom über dem Limit, dunkler; sonst langsam zurück
  if (cfg.pwrMax) {
    float lim = cfg.pwrMax / 1000.0f;
    if (amps > lim * 1.03f) measScale = fmaxf(0.1f, measScale * 0.92f);
    else if (amps < lim * 0.95f && measScale < 1) measScale = fminf(1, measScale * 1.03f);
  } else measScale = 1;
}
}  // namespace ina

void sendToPanel(int i);
void fxStart(int id) {
  if (id < 0 || id >= FX_COUNT) return;
  bool was = fx.id;
  fx.id = id;
  fxDirty = true; fxDirtyAt = millis();
  if (id && id != was) { fxReset(); fxPhase = 0; }   // jeder Effekt beginnt von vorn, nicht mitten in einer dunklen Phase
  fxLastFrame = 0;                                      // nächstes Bild sofort, nicht erst nach 40 ms
  transition();                                         // weich vom alten zum neuen Bild
  logf("[FX] %s\n", FX[fx.id].name);
  publishFx();
}

void fxSave() {
  prefs.putBytes("fx2", &fx, sizeof fx);
  if (prefs.getUShort("fxDir", 0) != fxDir) prefs.putUShort("fxDir", fxDir);
  if (prefs.getUChar("fxSpin", 0) != fxSpin) prefs.putUChar("fxSpin", fxSpin);
  { uint8_t o[4] = {0, 80, 255, 0}; prefs.getBytes("fxC2", o, 4); if (memcmp(o, fxC2, 4)) prefs.putBytes("fxC2", fxC2, 4); }
  if (prefs.getUChar("master", 255) != master) prefs.putUChar("master", master);
  if (prefs.getBool("mOn", true) != masterOn) prefs.putBool("mOn", masterOn);
  fxDirty = false;
}
void fxLoad() {
  cpalLoad();
  FxCfg f;
  if (prefs.getBytes("fx2", &f, sizeof f) == sizeof f && f.id < FX_COUNT && f.pal <= PAL_X) { fx = f; if (!palValid(fx.pal)) fx.pal = 0; }
  master = prefs.getUChar("master", 255); masterOn = prefs.getBool("mOn", true);
  fxDir = prefs.getUShort("fxDir", 0) % 360; fxSpin = prefs.getUChar("fxSpin", 0) % 3;
  prefs.getBytes("fxC2", fxC2, 4);
  fxFavs = prefs.getUInt("favs", 0);
  fxReset();
}

// Befehl {"effect":"regenbogen","speed":50,"intensity":128,"palette":"ozean","brightness":180,"color":{...}}
void resendAll();
void applyFx(JsonVariantConst cmd) {
  curPreset = -1;
  if (cmd["speed"].is<int>()) fx.speed = constrain(cmd["speed"].as<int>(), 1, 100);
  if (cmd["intensity"].is<int>()) fx.inten = constrain(cmd["intensity"].as<int>(), 0, 255);
  if (!cmd["color2"].isNull()) { JsonVariantConst c2 = cmd["color2"]; fxC2[0] = c2["r"] | fxC2[0]; fxC2[1] = c2["g"] | fxC2[1]; fxC2[2] = c2["b"] | fxC2[2]; fxC2[3] = c2["w"] | fxC2[3]; }
  if (cmd["direction"].is<int>()) fxDir = ((cmd["direction"].as<int>() % 360) + 360) % 360;
  if (cmd["spin"].is<int>()) { fxSpin = constrain(cmd["spin"].as<int>(), 0, 2); if (!fxSpin) fxSpinAng = 0; }
  if (cmd["brightness"].is<int>()) { master = constrain(cmd["brightness"].as<int>(), 1, 255); resendAll(); }
  if (cmd["palColors"].is<JsonArrayConst>()) {           // Farben von einer anderen Wand: genau diese verwenden
    uint32_t c[6]; uint8_t n = 0;
    for (JsonVariantConst v : cmd["palColors"].as<JsonArrayConst>()) if (n < 6) c[n++] = v.as<uint32_t>();
    palAdopt(n, c, cmd["palName"] | "");
  } else if (cmd["palette"].is<const char*>()) { int p = palFind(cmd["palette"].as<const char*>()); if (p >= 0) fx.pal = p; }
  else if (cmd["palette"].is<int>()) { int p = cmd["palette"].as<int>(); if (p >= 0 && p < PAL_ALL && palValid(p)) fx.pal = p; }
  JsonVariantConst c = cmd["color"];
  if (!c.isNull()) { fx.r = c["r"] | fx.r; fx.g = c["g"] | fx.g; fx.b = c["b"] | fx.b; fx.w = c["w"] | fx.w; }
  int id = fx.id;
  if (cmd["effect"].is<const char*>()) id = fxFind(cmd["effect"].as<const char*>());
  else if (cmd["effect"].is<int>()) id = cmd["effect"].as<int>();
  if (id >= 0 && id != fx.id) fxStart(id);
  else { fxDirty = true; fxDirtyAt = millis(); fxLastFrame = 0; publishFx(); }
}

// ---------- Ausgabe an ein Panel ----------
// Panel i hat sich geändert: weich zum neuen Zustand überblenden (die Ausgabe schickt es mit dem nächsten Bild)
void sendToPanel(int i) { (void)i; transition(); }

// ---------- Farbtemperatur ----------
// Kelvin (1500 bis 10000) in RGBW: Schwarzkörper-Farbe, der gemeinsame Weißanteil geht auf die weiße LED
void kelvinRgbw(int k, uint8_t* o) {
  float t = constrain(k, 1500, 10000) / 100.0f, r, g, b;
  r = t <= 66 ? 255 : 329.698727446f * powf(t - 60, -0.1332047592f);
  g = t <= 66 ? 99.4708025861f * logf(t) - 161.1195681661f : 288.1221695283f * powf(t - 60, -0.0755148492f);
  b = t >= 66 ? 255 : (t <= 19 ? 0 : 138.5177312231f * logf(t - 10) - 305.0447927307f);
  r = fminf(255, fmaxf(0, r)); g = fminf(255, fmaxf(0, g)); b = fminf(255, fmaxf(0, b));
  float w = fminf(r, fminf(g, b));
  o[0] = r - w; o[1] = g - w; o[2] = b - w; o[3] = w;
}
// "kelvin" (App) oder "color_temp" (Home Assistant, in Kelvin) wird zu einer normalen Farbe
void kelvinToColor(JsonDocument& d) {
  int k = d["kelvin"] | (int)(d["color_temp"] | 0);
  if (k < 1000) return;
  uint8_t c[4]; kelvinRgbw(k, c);
  JsonObject o = d["color"].to<JsonObject>(); o["r"] = c[0]; o["g"] = c[1]; o["b"] = c[2]; o["w"] = c[3];
  d.remove("kelvin"); d.remove("color_temp");
}

// ---------- MQTT / Home Assistant ----------
String tBase(int i) { return "trilumag/" + hex(P[i].chip); }

void publishState(int i) {
  if (!mqtt.connected()) return;
  const Panel& p = P[i];
  JsonDocument d;
  d["state"] = (masterOn && p.on && p.state != DARK) ? "ON" : "OFF";
  d["brightness"] = p.bri;
  d["color_mode"] = "rgbw";
  JsonObject c = d["color"].to<JsonObject>();
  c["r"] = p.r; c["g"] = p.g; c["b"] = p.b; c["w"] = p.w;
  char buf[192]; size_t n = serializeJson(d, buf, sizeof buf);
  mqtt.publish((tBase(i) + "/state").c_str(), (const uint8_t*)buf, n, true);
}

void publishAvail(int i, bool online) {
  if (!mqtt.connected()) return;
  mqtt.publish((tBase(i) + "/avail").c_str(), online ? "online" : "offline", true);
}

void publishDiscovery(int i) {
  if (!mqtt.connected()) return;
  String id = hex(P[i].chip);
  JsonDocument d;
  d["name"] = (i == 0) ? String("Hauptpanel") : "Panel " + id.substring(4);
  d["unique_id"] = "trilumag_" + id;
  d["schema"] = "json";
  d["command_topic"] = tBase(i) + "/set";
  d["state_topic"] = tBase(i) + "/state";
  d["brightness"] = true;
  { JsonArray cm = d["supported_color_modes"].to<JsonArray>(); cm.add("rgbw"); cm.add("color_temp"); }
  d["color_temp_kelvin"] = true; d["min_kelvin"] = 2200; d["max_kelvin"] = 6500;
  JsonArray av = d["availability"].to<JsonArray>();
  av.add<JsonObject>()["topic"] = "trilumag/bridge/avail";
  av.add<JsonObject>()["topic"] = tBase(i) + "/avail";
  d["availability_mode"] = "all";
  JsonObject dev = d["device"].to<JsonObject>();
  dev["identifiers"].to<JsonArray>().add("trilumag_" + hex(P[0].chip));
  dev["name"] = cfg.name;
  dev["manufacturer"] = "DIY";
  dev["model"] = "Panel v0.1";
  dev["sw_version"] = FW_VERSION;
  char buf[1400]; size_t n = serializeJson(d, buf, sizeof buf);
  mqtt.publish(("homeassistant/light/trilumag_" + id + "/config").c_str(), (const uint8_t*)buf, n, true);
}

void publishAllLight() {
  JsonDocument d;
  d["name"] = "Alle Panels";
  d["unique_id"] = "trilumag_alle_" + hex(P[0].chip);
  d["schema"] = "json";
  d["command_topic"] = "trilumag/alle/set";
  d["brightness"] = true;
  { JsonArray cm = d["supported_color_modes"].to<JsonArray>(); cm.add("rgbw"); cm.add("color_temp"); }
  d["color_temp_kelvin"] = true; d["min_kelvin"] = 2200; d["max_kelvin"] = 6500;
  d["state_topic"] = "trilumag/alle/state";
  d["effect"] = true;
  JsonArray el = d["effect_list"].to<JsonArray>();
  for (uint8_t k = 0; k < FX_COUNT; k++) el.add(FX[k].name);
  d["availability_topic"] = "trilumag/bridge/avail";
  JsonObject dev = d["device"].to<JsonObject>();
  dev["identifiers"].to<JsonArray>().add("trilumag_" + hex(P[0].chip));
  dev["name"] = cfg.name;
  char buf[1400]; size_t n = serializeJson(d, buf, sizeof buf);
  mqtt.publish(("homeassistant/light/trilumag_alle_" + hex(P[0].chip) + "/config").c_str(), (const uint8_t*)buf, n, true);

  publishExtras();
}

// Gerät, zu dem alle Einträge in Home Assistant gehören
void haDevice(JsonDocument& d) {
  d["availability_topic"] = "trilumag/bridge/avail";
  JsonObject dev = d["device"].to<JsonObject>();
  dev["identifiers"].to<JsonArray>().add("trilumag_" + hex(P[0].chip));
  dev["name"] = cfg.name;
}
void haPublish(const char* comp, const char* key, JsonDocument& d) {
  char buf[1400]; size_t n = serializeJson(d, buf, sizeof buf);
  String t = String("homeassistant/") + comp + "/trilumag_" + key + "_" + hex(P[0].chip) + "/config";
  mqtt.publish(t.c_str(), (const uint8_t*)buf, n, true);
}

// Tempo, Intensität, Palette und Presets als eigene Einträge in Home Assistant
void publishPresetEntity();
void publishExtras() {
  { JsonDocument t;                    // zeigt „Update läuft“, solange die Wand eine neue Firmware installiert
    t["name"] = "Status"; t["unique_id"] = "trilumag_status_" + hex(P[0].chip);
    t["state_topic"] = "trilumag/bridge/status"; t["icon"] = "mdi:update"; t["entity_category"] = "diagnostic";
    haDevice(t); t.remove("availability_topic"); haPublish("sensor", "status", t); }
  { JsonDocument t;
    t["name"] = "Effekt-Tempo"; t["unique_id"] = "trilumag_tempo_" + hex(P[0].chip);
    t["command_topic"] = "trilumag/tempo/set"; t["state_topic"] = "trilumag/tempo/state";
    t["min"] = 1; t["max"] = 100; t["step"] = 1; t["mode"] = "slider"; t["icon"] = "mdi:speedometer";
    haDevice(t); haPublish("number", "tempo", t); }
  { JsonDocument t;
    t["name"] = "Effekt-Intensität"; t["unique_id"] = "trilumag_intensitaet_" + hex(P[0].chip);
    t["command_topic"] = "trilumag/intensitaet/set"; t["state_topic"] = "trilumag/intensitaet/state";
    t["min"] = 0; t["max"] = 255; t["step"] = 1; t["mode"] = "slider"; t["icon"] = "mdi:tune-variant";
    haDevice(t); haPublish("number", "intensitaet", t); }
  { JsonDocument t;
    t["name"] = "Palette"; t["unique_id"] = "trilumag_palette_" + hex(P[0].chip);
    t["command_topic"] = "trilumag/palette/set"; t["state_topic"] = "trilumag/palette/state";
    JsonArray o = t["options"].to<JsonArray>();
    for (uint8_t k = 0; k < PAL_ALL; k++) if (palValid(k)) o.add(palName(k));
    t["icon"] = "mdi:palette";
    haDevice(t); haPublish("select", "palette", t); }
  publishPresetEntity();
  { JsonDocument t;                                 // Antippen als Ereignis für Automationen
    t["name"] = "Antippen"; t["unique_id"] = "trilumag_touch_" + hex(P[0].chip);
    t["state_topic"] = "trilumag/touch"; t["icon"] = "mdi:gesture-tap";
    JsonArray et = t["event_types"].to<JsonArray>(); et.add("einmal"); et.add("doppelt");
    haDevice(t); haPublish("event", "touch", t); }
  { JsonDocument t;                                 // Signal: notify.send_message mit "blau 3"
    t["name"] = "Signal"; t["unique_id"] = "trilumag_signal_" + hex(P[0].chip);
    t["command_topic"] = "trilumag/signal/set"; t["icon"] = "mdi:bell-ring";
    haDevice(t); haPublish("notify", "signal", t); }
  { JsonDocument t;                                 // Fortschritt 0..100 % (0 = aus)
    t["name"] = "Fortschritt"; t["unique_id"] = "trilumag_fortschritt_" + hex(P[0].chip);
    t["command_topic"] = "trilumag/fortschritt/set"; t["state_topic"] = "trilumag/fortschritt/state";
    t["min"] = 0; t["max"] = 100; t["step"] = 1; t["unit_of_measurement"] = "%"; t["mode"] = "slider"; t["icon"] = "mdi:progress-helper";
    haDevice(t); haPublish("number", "fortschritt", t); }
  { JsonDocument t;                                 // Zähler für das Energie-Dashboard
    t["name"] = "Energie"; t["unique_id"] = "trilumag_energie_" + hex(P[0].chip);
    t["state_topic"] = "trilumag/energie/state"; t["device_class"] = "energy"; t["unit_of_measurement"] = "kWh";
    t["state_class"] = "total_increasing"; t["suggested_display_precision"] = 2;
    haDevice(t); haPublish("sensor", "energie", t); }
  // Strom und Leistung (gemessen mit INA226, sonst geschätzt)
  const char* keys[3] = {"strom", "leistung", "spannung"};
  const char* names[3] = {"Strom", "Leistung", "Spannung"};
  const char* cls[3] = {"current", "power", "voltage"};
  const char* units[3] = {"A", "W", "V"};
  const char* tpl[3] = {"{{ value_json.a }}", "{{ value_json.w }}", "{{ value_json.v }}"};
  for (int k = 0; k < 3; k++) {
    String topic = String("homeassistant/sensor/trilumag_") + keys[k] + "_" + hex(P[0].chip) + "/config";
    if (k == 2 && !ina::ok) { mqtt.publish(topic.c_str(), "", true); continue; }   // Spannung nur mit Sensor
    JsonDocument t;
    t["name"] = String(names[k]) + (ina::ok ? "" : " (geschätzt)");
    t["unique_id"] = String("trilumag_") + keys[k] + "_" + hex(P[0].chip);
    t["state_topic"] = "trilumag/strom/state"; t["value_template"] = tpl[k];
    t["device_class"] = cls[k]; t["unit_of_measurement"] = units[k]; t["state_class"] = "measurement";
    haDevice(t); haPublish("sensor", keys[k], t);
  }
}

void publishPower() {
  if (!mqtt.connected()) return;
  float a = ina::ok ? ina::amps : estMa / 1000.0f;
  float v = ina::ok ? ina::volts : 24.0f;
  char b[96]; snprintf(b, sizeof b, "{\"a\":%.2f,\"w\":%.1f,\"v\":%.2f}", a, a * v, v);
  mqtt.publish("trilumag/strom/state", b, true);
  snprintf(b, sizeof b, "%.3f", en.total / 1000.0);
  mqtt.publish("trilumag/energie/state", b, true);
}
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
