mariofritzer/Trilumag/firmware/trilumag/webapp_gz.h

#pragma once
// Automatisch erzeugt aus webapp.h mit .github/scripts/webapp_gz.py – nicht von Hand ändern.
// 213234 Bytes, gepackt 64283 Bytes
const size_t WEBAPP_GZ_LEN = 64283;
const uint8_t WEBAPP_GZ[] PROGMEM = {
0x1F,0x8B,0x08,0x00,0x00,0x00,0x00,0x00,0x02,0x03,0x9C,0x56,0xE7,0x76,0xA3,0xBA,0x13,0xFF,0x9E,0xA7,0xD0,0x3A,0x27,0xC7,
0xC9,0x2E,0xB2,0x01,0x97,0x4D,0x44,0xBC,0xFF,0x5E,0x6E,0xEF,0x5F,0x6E,0x17,0x30,0x60,0x6D,0x84,0xC4,0x11,0x22,0xB6,0xD7,
0x27,0xEF,0x7E,0x47,0x88,0x38,0x38,0xDB,0x37,0xC5,0x9E,0x22,0xCD,0xCC,0x6F,0x1A,0x5C,0x3F,0xC9,0x75,0x66,0x77,0x35,0x90,
0xB5,0xAD,0xE4,0x8B,0x93,0x6B,0xF7,0x45,0x24,0x57,0xE5,0x6A,0x94,0xC3,0xE8,0xC5,0xF5,0x1A,0x78,0x8E,0xE2,0x0A,0x2C,0x27,
0xD9,0x9A,0x9B,0x06,0xEC,0x6A,0xD4,0xDA,0x82,0x5E,0xA2,0xB2,0x93,0x2A,0x5E,0xC1,0x6A,0x74,0x2B,0x60,0x53,0x6B,0x63,0x47,
0x24,0xD3,0xCA,0x82,0xC2,0x53,0x1B,0x91,0xDB,0xF5,0x2A,0x87,0x5B,0x91,0x01,0xED,0x98,0x40,0x28,0x61,0x05,0x97,0xB4,0xC9,
0xB8,0x84,0x55,0x14,0xDC,0xDF,0xA2,0x85,0xB0,0xAB,0x4C,0xDF,0x82,0x19,0xA1,0xB3,0x81,0x59,0xBB,0x86,0x0A,0x68,0xA6,0xA5,
0x36,0x03,0xCB,0xA7,0x51,0x14,0xB9,0x83,0x56,0x58,0x09,0x2F,0x7E,0x34,0x42,0xB6,0x15,0x2F,0xAF,0xA7,0x1D,0x8F,0x72,0x29,
0xD4,0x0D,0x31,0x20,0x57,0x23,0x81,0x77,0x46,0xC4,0x01,0x44,0x1A,0xCF,0xC0,0xB4,0xB9,0x2D,0x9F,0x6D,0x2B,0x39,0x22,0x6B,
0x03,0x05,0x82,0xE4,0x96,0xB3,0x23,0x4D,0x70,0x36,0xFB,0x17,0x92,0x04,0x49,0xD5,0xAC,0xC6,0x6B,0x6B,0x6B,0x36,0x9D,0x6E,
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
0x19,0xED,0x6F,0x4C,0xE6,0x89,0x9B,0x7C,0x8F,0x77,0xB0,0xD6,0x32,0x4C,0x64,0x07,0xC5,0x3B,0x99,0x60,0x1F,0x0D,0xDD,0xF7,
0x26,0x71,0x38,0x11,0xF6,0x21,0x4A,0xD6,0xAD,0x60,0xCC,0x21,0xA1,0x2E,0x43,0x0F,0x67,0x0E,0x46,0xBA,0x60,0x8F,0xA2,0xEA,
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
};
