mariofritzer/Trilumag/firmware/trilumag/panel_fw.h

#pragma once
// Automatisch erzeugt aus firmware/panel/panel.bin – nicht von Hand ändern.
// Panel-Firmware Version 3, 4952 Bytes, 78 Seiten
const uint8_t PANEL_FW_VERSION = 3;
const uint16_t PANEL_FW_PAGES = 78;
const uint16_t PANEL_FW_CRC = 0x6086;
const uint8_t PANEL_FW[] = {
  0x6F, 0x00, 0xA0, 0x7E, 0x00, 0x00, 0x00, 0x00, 0xB0, 0x08, 0x00, 0x00, 0x5C, 0x08, 0x00, 0x00,
  0x00, 0x00, 0x00, 0x00, 0x00, 0x00, 0x00, 0x00, 0x00, 0x00, 0x00, 0x00, 0x00, 0x00, 0x00, 0x00,
  0x00, 0x00, 0x00, 0x00, 0x00, 0x00, 0x00, 0x00, 0x00, 0x00, 0x00, 0x00, 0x00, 0x00, 0x00, 0x00,
  0x5C, 0x08, 0x00, 0x00, 0x00, 0x00, 0x00, 0x00, 0x5C, 0x08, 0x00, 0x00, 0x00, 0x00, 0x00, 0x00,
  0x5C, 0x08, 0x00, 0x00, 0x5C, 0x08, 0x00, 0x00, 0x5C, 0x08, 0x00, 0x00, 0x5C, 0x08, 0x00, 0x00,
  0x5C, 0x08, 0x00, 0x00, 0x5C, 0x08, 0x00, 0x00, 0x5C, 0x08, 0x00, 0x00, 0x5C, 0x08, 0x00, 0x00,
  0xD6, 0x10, 0x00, 0x00, 0x5C, 0x08, 0x00, 0x00, 0x5C, 0x08, 0x00, 0x00, 0x5C, 0x08, 0x00, 0x00,
  0x5C, 0x08, 0x00, 0x00, 0x5C, 0x08, 0x00, 0x00, 0x5C, 0x08, 0x00, 0x00, 0x5C, 0x08, 0x00, 0x00,
  0x58, 0x11, 0x00, 0x00, 0x5C, 0x08, 0x00, 0x00, 0x5C, 0x08, 0x00, 0x00, 0x5C, 0x08, 0x00, 0x00,
  0x5C, 0x08, 0x00, 0x00, 0x5C, 0x08, 0x00, 0x00, 0x5C, 0x08, 0x00, 0x00, 0x00, 0x00, 0x00, 0x00,
  0x2A, 0x86, 0x01, 0x45, 0x93, 0xF6, 0x15, 0x00, 0x91, 0xC2, 0x32, 0x95, 0x85, 0x81, 0x06, 0x06,
  0xF5, 0xF9, 0x82, 0x80, 0x00, 0x00, 0x00, 0x00, 0x63, 0x4E, 0x05, 0x02, 0x63, 0xC3, 0x05, 0x04,
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
  0x04, 0x00, 0x23, 0xA6, 0x04, 0x00, 0x85, 0x06, 0xC1, 0x04, 0x91, 0xBF, 0x92, 0x47, 0x81, 0xC7,
  0x09, 0x47, 0x63, 0x59, 0xD7, 0x0A, 0x02, 0xD2, 0xD2, 0x47, 0xC1, 0x04, 0x85, 0x06, 0x03, 0xC7,
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
};
