mariofritzer/Trilumag/firmware/trilumag/cacerts.h

#pragma once
// Stammzertifikate für Online-Updates von GitHub (Pages und Releases).
// Der Build prüft bei jedem Lauf, dass die echten Zertifikatsketten damit aufgehen,
// und ergänzt dabei "DigiCert Global Root CA", falls der Build-Rechner es kennt.

const char CA_CERTS[] =
  // ISRG Root X1
  "-----BEGIN CERTIFICATE-----\n"
  "MIIFazCCA1OgAwIBAgIRAIIQz7DSQONZRGPgu2OCiwAwDQYJKoZIhvcNAQELBQAw\n"
  "TzELMAkGA1UEBhMCVVMxKTAnBgNVBAoTIEludGVybmV0IFNlY3VyaXR5IFJlc2Vh\n"
  "cmNoIEdyb3VwMRUwEwYDVQQDEwxJU1JHIFJvb3QgWDEwHhcNMTUwNjA0MTEwNDM4\n"
  "WhcNMzUwNjA0MTEwNDM4WjBPMQswCQYDVQQGEwJVUzEpMCcGA1UEChMgSW50ZXJu\n"
  "ZXQgU2VjdXJpdHkgUmVzZWFyY2ggR3JvdXAxFTATBgNVBAMTDElTUkcgUm9vdCBY\n"
  "MTCCAiIwDQYJKoZIhvcNAQEBBQADggIPADCCAgoCggIBAK3oJHP0FDfzm54rVygc\n"
  "h77ct984kIxuPOZXoHj3dcKi/vVqbvYATyjb3miGbESTtrFj/RQSa78f0uoxmyF+\n"
  "0TM8ukj13Xnfs7j/EvEhmkvBioZxaUpmZmyPfjxwv60pIgbz5MDmgK7iS4+3mX6U\n"
  "A5/TR5d8mUgjU+g4rk8Kb4Mu0UlXjIB0ttov0DiNewNwIRt18jA8+o+u3dpjq+sW\n"
  "T8KOEUt+zwvo/7V3LvSye0rgTBIlDHCNAymg4VMk7BPZ7hm/ELNKjD+Jo2FR3qyH\n"
  "B5T0Y3HsLuJvW5iB4YlcNHlsdu87kGJ55tukmi8mxdAQ4Q7e2RCOFvu396j3x+UC\n"
  "B5iPNgiV5+I3lg02dZ77DnKxHZu8A/lJBdiB3QW0KtZB6awBdpUKD9jf1b0SHzUv\n"
  "KBds0pjBqAlkd25HN7rOrFleaJ1/ctaJxQZBKT5ZPt0m9STJEadao0xAH0ahmbWn\n"
  "OlFuhjuefXKnEgV4We0+UXgVCwOPjdAvBbI+e0ocS3MFEvzG6uBQE3xDk3SzynTn\n"
  "jh8BCNAw1FtxNrQHusEwMFxIt4I7mKZ9YIqioymCzLq9gwQbooMDQaHWBfEbwrbw\n"
  "qHyGO0aoSCqI3Haadr8faqU9GY/rOPNk3sgrDQoo//fb4hVC1CLQJ13hef4Y53CI\n"
  "rU7m2Ys6xt0nUW7/vGT1M0NPAgMBAAGjQjBAMA4GA1UdDwEB/wQEAwIBBjAPBgNV\n"
  "HRMBAf8EBTADAQH/MB0GA1UdDgQWBBR5tFnme7bl5AFzgAiIyBpY9umbbjANBgkq\n"
  "hkiG9w0BAQsFAAOCAgEAVR9YqbyyqFDQDLHYGmkgJykIrGF1XIpu+ILlaS/V9lZL\n"
  "ubhzEFnTIZd+50xx+7LSYK05qAvqFyFWhfFQDlnrzuBZ6brJFe+GnY+EgPbk6ZGQ\n"
  "3BebYhtF8GaV0nxvwuo77x/Py9auJ/GpsMiu/X1+mvoiBOv/2X/qkSsisRcOj/KK\n"
  "NFtY2PwByVS5uCbMiogziUwthDyC3+6WVwW6LLv3xLfHTjuCvjHIInNzktHCgKQ5\n"
  "ORAzI4JMPJ+GslWYHb4phowim57iaztXOoJwTdwJx4nLCgdNbOhdjsnvzqvHu7Ur\n"
  "TkXWStAmzOVyyghqpZXjFaH3pO3JLF+l+/+sKAIuvtd7u+Nxe5AW0wdeRlN8NwdC\n"
  "jNPElpzVmbUq4JUagEiuTDkHzsxHpFKVK7q4+63SM1N95R1NbdWhscdCb+ZAJzVc\n"
  "oyi3B43njTOQ5yOf+1CceWxG1bQVs5ZufpsMljq4Ui0/1lvh+wjChP4kqKOJ2qxq\n"
  "4RgqsahDYVvTH9w7jXbyLeiNdd8XM2w9U/t7y0Ff/9yi0GE44Za4rF2LN9d11TPA\n"
  "mRGunUHBcnWEvgJBQl9nJEiU0Zsnvgc/ubhPgXRR4Xq37Z0j4r7g1SgEEzwxA57d\n"
  "emyPxgcYxn/eR44/KJ4EBs+lVDR3veyJm+kXQ99b21/+jh5Xos1AnX5iItreGCc=\n"
  "-----END CERTIFICATE-----\n"
  // ISRG Root X2
  "-----BEGIN CERTIFICATE-----\n"
  "MIICGzCCAaGgAwIBAgIQQdKd0XLq7qeAwSxs6S+HUjAKBggqhkjOPQQDAzBPMQsw\n"
  "CQYDVQQGEwJVUzEpMCcGA1UEChMgSW50ZXJuZXQgU2VjdXJpdHkgUmVzZWFyY2gg\n"
  "R3JvdXAxFTATBgNVBAMTDElTUkcgUm9vdCBYMjAeFw0yMDA5MDQwMDAwMDBaFw00\n"
  "MDA5MTcxNjAwMDBaME8xCzAJBgNVBAYTAlVTMSkwJwYDVQQKEyBJbnRlcm5ldCBT\n"
  "ZWN1cml0eSBSZXNlYXJjaCBHcm91cDEVMBMGA1UEAxMMSVNSRyBSb290IFgyMHYw\n"
  "EAYHKoZIzj0CAQYFK4EEACIDYgAEzZvVn4CDCuwJSvMWSj5cz3es3mcFDR0HttwW\n"
  "+1qLFNvicWDEukWVEYmO6gbf9yoWHKS5xcUy4APgHoIYOIvXRdgKam7mAHf7AlF9\n"
  "ItgKbppbd9/w+kHsOdx1ymgHDB/qo0IwQDAOBgNVHQ8BAf8EBAMCAQYwDwYDVR0T\n"
  "AQH/BAUwAwEB/zAdBgNVHQ4EFgQUfEKWrt5LSDv6kviejM9ti6lyN5UwCgYIKoZI\n"
  "zj0EAwMDaAAwZQIwe3lORlCEwkSHRhtFcP9Ymd70/aTSVaYgLXTWNLxBo1BfASdW\n"
  "tL4ndQavEi51mI38AjEAi/V3bNTIZargCyzuFJ0nN6T5U6VR5CmD1/iQMVtCnwr1\n"
  "/q4AaOeMSQ+2b1tbFfLn\n"
  "-----END CERTIFICATE-----\n"
  // DigiCert Global Root G2
  "-----BEGIN CERTIFICATE-----\n"
  "MIIDjjCCAnagAwIBAgIQAzrx5qcRqaC7KGSxHQn65TANBgkqhkiG9w0BAQsFADBh\n"
  "MQswCQYDVQQGEwJVUzEVMBMGA1UEChMMRGlnaUNlcnQgSW5jMRkwFwYDVQQLExB3\n"
  "d3cuZGlnaWNlcnQuY29tMSAwHgYDVQQDExdEaWdpQ2VydCBHbG9iYWwgUm9vdCBH\n"
  "MjAeFw0xMzA4MDExMjAwMDBaFw0zODAxMTUxMjAwMDBaMGExCzAJBgNVBAYTAlVT\n"
  "MRUwEwYDVQQKEwxEaWdpQ2VydCBJbmMxGTAXBgNVBAsTEHd3dy5kaWdpY2VydC5j\n"
  "b20xIDAeBgNVBAMTF0RpZ2lDZXJ0IEdsb2JhbCBSb290IEcyMIIBIjANBgkqhkiG\n"
  "9w0BAQEFAAOCAQ8AMIIBCgKCAQEAuzfNNNx7a8myaJCtSnX/RrohCgiN9RlUyfuI\n"
  "2/Ou8jqJkTx65qsGGmvPrC3oXgkkRLpimn7Wo6h+4FR1IAWsULecYxpsMNzaHxmx\n"
  "1x7e/dfgy5SDN67sH0NO3Xss0r0upS/kqbitOtSZpLYl6ZtrAGCSYP9PIUkY92eQ\n"
  "q2EGnI/yuum06ZIya7XzV+hdG82MHauVBJVJ8zUtluNJbd134/tJS7SsVQepj5Wz\n"
  "tCO7TG1F8PapspUwtP1MVYwnSlcUfIKdzXOS0xZKBgyMUNGPHgm+F6HmIcr9g+UQ\n"
  "vIOlCsRnKPZzFBQ9RnbDhxSJITRNrw9FDKZJobq7nMWxM4MphQIDAQABo0IwQDAP\n"
  "BgNVHRMBAf8EBTADAQH/MA4GA1UdDwEB/wQEAwIBhjAdBgNVHQ4EFgQUTiJUIBiV\n"
  "5uNu5g/6+rkS7QYXjzkwDQYJKoZIhvcNAQELBQADggEBAGBnKJRvDkhj6zHd6mcY\n"
  "1Yl9PMWLSn/pvtsrF9+wX3N3KjITOYFnQoQj8kVnNeyIv/iPsGEMNKSuIEyExtv4\n"
  "NeF22d+mQrvHRAiGfzZ0JFrabA0UWTW98kndth/Jsw1HKj2ZL7tcu7XUIOGZX1NG\n"
  "Fdtom/DzMNU+MeKNhJ7jitralj41E6Vf8PlwUHBHQRFXGU7Aj64GxJUTFy8bJZ91\n"
  "8rGOmaFvE7FBcf6IKshPECBV1/MUReXgRPTqh5Uykw7+U0b6LJ3/iyK5S9kJRaTe\n"
  "pLiaWN0bfVKfjllDiIGknibVb63dDcY3fe0Dkhvld1927jyNxF1WW6LZZm6zNTfl\n"
  "MrY=\n"
  "-----END CERTIFICATE-----\n"
  // DigiCert Global Root G3
  "-----BEGIN CERTIFICATE-----\n"
  "MIICPzCCAcWgAwIBAgIQBVVWvPJepDU1w6QP1atFcjAKBggqhkjOPQQDAzBhMQsw\n"
  "CQYDVQQGEwJVUzEVMBMGA1UEChMMRGlnaUNlcnQgSW5jMRkwFwYDVQQLExB3d3cu\n"
  "ZGlnaWNlcnQuY29tMSAwHgYDVQQDExdEaWdpQ2VydCBHbG9iYWwgUm9vdCBHMzAe\n"
  "Fw0xMzA4MDExMjAwMDBaFw0zODAxMTUxMjAwMDBaMGExCzAJBgNVBAYTAlVTMRUw\n"
  "EwYDVQQKEwxEaWdpQ2VydCBJbmMxGTAXBgNVBAsTEHd3dy5kaWdpY2VydC5jb20x\n"
  "IDAeBgNVBAMTF0RpZ2lDZXJ0IEdsb2JhbCBSb290IEczMHYwEAYHKoZIzj0CAQYF\n"
  "K4EEACIDYgAE3afZu4q4C/sLfyHS8L6+c/MzXRq8NOrexpu80JX28MzQC7phW1FG\n"
  "fp4tn+6OYwwX7Adw9c+ELkCDnOg/QW07rdOkFFk2eJ0DQ+4QE2xy3q6Ip6FrtUPO\n"
  "Z9wj/wMco+I+o0IwQDAPBgNVHRMBAf8EBTADAQH/MA4GA1UdDwEB/wQEAwIBhjAd\n"
  "BgNVHQ4EFgQUs9tIpPmhxdiuNkHMEWNpYim8S8YwCgYIKoZIzj0EAwMDaAAwZQIx\n"
  "AK288mw/EkrRLTnDCgmXc/SINoyIJ7vmiI1Qhadj+Z4y3maTD/HMsQmP3Wyr+mt/\n"
  "oAIwOWZbwmSNuJ5Q3KjVSaLtx9zRSX8XAbjIho9OjIgrqJqpisXRAL34VOKa5Vt8\n"
  "sycX\n"
  "-----END CERTIFICATE-----\n"
  // USERTrust RSA Certification Authority
  "-----BEGIN CERTIFICATE-----\n"
  "MIIF3jCCA8agAwIBAgIQAf1tMPyjylGoG7xkDjUDLTANBgkqhkiG9w0BAQwFADCB\n"
  "iDELMAkGA1UEBhMCVVMxEzARBgNVBAgTCk5ldyBKZXJzZXkxFDASBgNVBAcTC0pl\n"
  "cnNleSBDaXR5MR4wHAYDVQQKExVUaGUgVVNFUlRSVVNUIE5ldHdvcmsxLjAsBgNV\n"
  "BAMTJVVTRVJUcnVzdCBSU0EgQ2VydGlmaWNhdGlvbiBBdXRob3JpdHkwHhcNMTAw\n"
  "MjAxMDAwMDAwWhcNMzgwMTE4MjM1OTU5WjCBiDELMAkGA1UEBhMCVVMxEzARBgNV\n"
  "BAgTCk5ldyBKZXJzZXkxFDASBgNVBAcTC0plcnNleSBDaXR5MR4wHAYDVQQKExVU\n"
  "aGUgVVNFUlRSVVNUIE5ldHdvcmsxLjAsBgNVBAMTJVVTRVJUcnVzdCBSU0EgQ2Vy\n"
  "dGlmaWNhdGlvbiBBdXRob3JpdHkwggIiMA0GCSqGSIb3DQEBAQUAA4ICDwAwggIK\n"
  "AoICAQCAEmUXNg7D2wiz0KxXDXbtzSfTTK1Qg2HiqiBNCS1kCdzOiZ/MPans9s/B\n"
  "3PHTsdZ7NygRK0faOca8Ohm0X6a9fZ2jY0K2dvKpOyuR+OJv0OwWIJAJPuLodMkY\n"
  "tJHUYmTbf6MG8YgYapAiPLz+E/CHFHv25B+O1ORRxhFnRghRy4YUVD+8M/5+bJz/\n"
  "Fp0YvVGONaanZshyZ9shZrHUm3gDwFA66Mzw3LyeTP6vBZY1H1dat//O+T23LLb2\n"
  "VN3I5xI6Ta5MirdcmrS3ID3KfyI0rn47aGYBROcBTkZTmzNg95S+UzeQc0PzMsNT\n"
  "79uq/nROacdrjGCT3sTHDN/hMq7MkztReJVni+49Vv4M0GkPGw/zJSZrM233bkf6\n"
  "c0Plfg6lZrEpfDKEY1WJxA3Bk1QwGROs0303p+tdOmw1XNtB1xLaqUkL39iAigmT\n"
  "Yo61Zs8liM2EuLE/pDkP2QKe6xJMlXzzawWpXhaDzLhn4ugTncxbgtNMs+1b/97l\n"
  "c6wjOy0AvzVVdAlJ2ElYGn+SNuZRkg7zJn0cTRe8yexDJtC/QV9AqURE9JnnV4ee\n"
  "UB9XVKg+/XRjL7FQZQnmWEIuQxpMtPAlR1n6BB6T1CZGSlCBst6+eLf8ZxXhyVeE\n"
  "Hg9j1uliutZfVS7qXMYoCAQlObgOK6nyTJccBz8NUvXt7y+CDwIDAQABo0IwQDAd\n"
  "BgNVHQ4EFgQUU3m/WqorSs9UgOHYm8Cd8rIDZsswDgYDVR0PAQH/BAQDAgEGMA8G\n"
  "A1UdEwEB/wQFMAMBAf8wDQYJKoZIhvcNAQEMBQADggIBAFzUfA3P9wF9QZllDHPF\n"
  "Up/L+M+ZBn8b2kMVn54CVVeWFPFSPCeHlCjtHzoBN6J2/FNQwISbxmtOuowhT6KO\n"
  "VWKR82kV2LyI48SqC/3vqOlLVSoGIG1VeCkZ7l8wXEskEVX/JJpuXior7gtNn3/3\n"
  "ATiUFJVDBwn7YKnuHKsSjKCaXqeYalltiz8I+8jRRa8YFWSQEg9zKC7F4iRO/Fjs\n"
  "8PRF/iKz6y+O0tlFYQXBl2+odnKPi4w2r78NBc5xjeambx9spnFixdjQg3IM8WcR\n"
  "iQycE0xyNN+81XHfqnHd4blsjDwSXWXavVcStkNr/+XeTWYRUc+ZruwXtuhxkYze\n"
  "Sf7dNXGiFSeUHM9h4ya7b6NnJSFd5t0dCy5oGzuCr+yDZ4XUmFF0sbmZgIn/f3gZ\n"
  "XHlKYC6SQK5MNyosycdiyA5d9zZbyuAlJQG03RoHnHcAP9Dc1ew91Pq7P8yF1m9/\n"
  "qS3fuQL39ZeatTXaw2ewh0qpKJ4jjv9cJ2vhsE/zB+4ALtRZh8tSQZXq9EfX7mRB\n"
  "VXyNWQKV3WKdwrnuWih0hKWbt5DHDAff9Yk2dDLWKMGwsAvgnEzDHNb842m1R0aB\n"
  "L6KCq9NjRHDEjf8tM7qtj3u1cIiuPhnPQCjY/MiQu12ZIvVS5ljFH4gxQ+6IHdfG\n"
  "jjxDah2nGN59PRbxYvnKkKj9\n"
  "-----END CERTIFICATE-----\n"
  // USERTrust ECC Certification Authority
  "-----BEGIN CERTIFICATE-----\n"
  "MIICjzCCAhWgAwIBAgIQXIuZxVqUxdJxVt7NiYDMJjAKBggqhkjOPQQDAzCBiDEL\n"
  "MAkGA1UEBhMCVVMxEzARBgNVBAgTCk5ldyBKZXJzZXkxFDASBgNVBAcTC0plcnNl\n"
  "eSBDaXR5MR4wHAYDVQQKExVUaGUgVVNFUlRSVVNUIE5ldHdvcmsxLjAsBgNVBAMT\n"
  "JVVTRVJUcnVzdCBFQ0MgQ2VydGlmaWNhdGlvbiBBdXRob3JpdHkwHhcNMTAwMjAx\n"
  "MDAwMDAwWhcNMzgwMTE4MjM1OTU5WjCBiDELMAkGA1UEBhMCVVMxEzARBgNVBAgT\n"
  "Ck5ldyBKZXJzZXkxFDASBgNVBAcTC0plcnNleSBDaXR5MR4wHAYDVQQKExVUaGUg\n"
  "VVNFUlRSVVNUIE5ldHdvcmsxLjAsBgNVBAMTJVVTRVJUcnVzdCBFQ0MgQ2VydGlm\n"
  "aWNhdGlvbiBBdXRob3JpdHkwdjAQBgcqhkjOPQIBBgUrgQQAIgNiAAQarFRaqflo\n"
  "I+d61SRvU8Za2EurxtW20eZzca7dnNYMYf3boIkDuAUU7FfO7l0/4iGzzvfUinng\n"
  "o4N+LZfQYcTxmdwlkWOrfzCjtHDix6EznPO/LlxTsV+zfTJ/ijTjeXmjQjBAMB0G\n"
  "A1UdDgQWBBQ64QmG1M8ZwpZ2dEl23OA1xmNjmjAOBgNVHQ8BAf8EBAMCAQYwDwYD\n"
  "VR0TAQH/BAUwAwEB/zAKBggqhkjOPQQDAwNoADBlAjA2Z6EWCNzklwBBHU6+4WMB\n"
  "zzuqQhFkoJ2UOQIReVx7Hfpkue4WQrO/isIJxOzksU0CMQDpKmFHjFJKS04YcPbW\n"
  "RNZu9YO6bVi9JNlWSOrvxKJGgYhqOkbRqZtNyWHa0V1Xahg=\n"
  "-----END CERTIFICATE-----\n"
  // Sectigo Public Server Authentication Root R46
  "-----BEGIN CERTIFICATE-----\n"
  "MIIFijCCA3KgAwIBAgIQdY39i658BwD6qSWn4cetFDANBgkqhkiG9w0BAQwFADBf\n"
  "MQswCQYDVQQGEwJHQjEYMBYGA1UEChMPU2VjdGlnbyBMaW1pdGVkMTYwNAYDVQQD\n"
  "Ey1TZWN0aWdvIFB1YmxpYyBTZXJ2ZXIgQXV0aGVudGljYXRpb24gUm9vdCBSNDYw\n"
  "HhcNMjEwMzIyMDAwMDAwWhcNNDYwMzIxMjM1OTU5WjBfMQswCQYDVQQGEwJHQjEY\n"
  "MBYGA1UEChMPU2VjdGlnbyBMaW1pdGVkMTYwNAYDVQQDEy1TZWN0aWdvIFB1Ymxp\n"
  "YyBTZXJ2ZXIgQXV0aGVudGljYXRpb24gUm9vdCBSNDYwggIiMA0GCSqGSIb3DQEB\n"
  "AQUAA4ICDwAwggIKAoICAQCTvtU2UnXYASOgHEdCSe5jtrch/cSV1UgrJnwUUxDa\n"
  "ef0rty2k1Cz66jLdScK5vQ9IPXtamFSvnl0xdE8H/FAh3aTPaE8bEmNtJZlMKpnz\n"
  "SDBh+oF8HqcIStw+KxwfGExxqjWMrfhu6DtK2eWUAtaJhBOqbchPM8xQljeSM9xf\n"
  "iOefVNlI8JhD1mb9nxc4Q8UBUQvX4yMPFF1bFOdLvt30yNoDN9HWOaEhUTCDsG3X\n"
  "ME6WW5HwcCSrv0WBZEMNvSE6Lzzpng3LILVCJ8zab5vuZDCQOc2TZYEhMbUjUDM3\n"
  "IuM47fgxMMxF/mL50V0yeUKH32rMVhlATc6qu/m1dkmU8Sf4kaWD5QazYw6A3OAS\n"
  "VYCmO2a0OYctyPDQ0RTp5A1NDvZdV3LFOxxHVp3i1fuBYYzMTYCQNFu31xR13NgE\n"
  "SJ/AwSiItOkcyqex8Va3e0lMWeUgFaiEAin6OJRpmkkGj80feRQXEgyDet4fsZfu\n"
  "+Zd4KKTIRJLpfSYFplhym3kT2BFfrsU4YjRosoYwjviQYZ4ybPUHNs2iTG7sijbt\n"
  "8uaZFURww3y8nDnAtOFr94MlI1fZEoDlSfB1D++N6xybVCi0ITz8fAr/73trdf+L\n"
  "HaAZBav6+CuBQug4urv7qv094PPK306Xlynt8xhW6aWWrL3DkJiy4Pmi1KZHQ3xt\n"
  "zwIDAQABo0IwQDAdBgNVHQ4EFgQUVnNYZJX5khqwEioEYnmhQBWIIUkwDgYDVR0P\n"
  "AQH/BAQDAgGGMA8GA1UdEwEB/wQFMAMBAf8wDQYJKoZIhvcNAQEMBQADggIBAC9c\n"
  "mTz8Bl6MlC5w6tIyMY208FHVvArzZJ8HXtXBc2hkeqK5Duj5XYUtqDdFqij0lgVQ\n"
  "YKlJfp/imTYpE0RHap1VIDzYm/EDMrraQKFz6oOht0SmDpkBm+S8f74TlH7Kph52\n"
  "gDY9hAaLMyZlbcp+nv4fjFg4exqDsQ+8FxG75gbMY/qB8oFM2gsQa6H61SilzwZA\n"
  "Fv97fRheORKkU55+MkIQpiGRqRxOF3yEvJ+M0ejf5lG5Nkc/kLnHvALcWxxPDkjB\n"
  "JYOcCj+esQMzEhonrPcibCTRAUH4WAP+JWgiH5paPHxsnnVI84HxZmduTILA7rpX\n"
  "DhjvLpr3Etiga+kFpaHpaPi8TD8SHkXoUsCjvxInebnMMTzD9joiFgOgyY9mpFui\n"
  "TdaBJQbpdqQACj7LzTWb4OE4y2BThihCQRxEV+ioratF4yUQvNs+ZUH7G6aXD+u5\n"
  "dHn5HrwdVw1Hr8Mvn4dGp+smWg9WY7ViYG4A++MnESLn/pmPNPW56MORcr3Ywx65\n"
  "LvKRRFHQV80MNNVIIb/bE/FmJUNS0nAiNs2fxBx1IK1jcmMGDw4nztJqDby1ORrp\n"
  "0XZ60Vzk50lJLVU3aPAaOpg+VBeHVOmmJ1CJeyAvP/+/oYtKR5j/K3tJPsMpRmAY\n"
  "QqszKbrAKbkTidOIijlBO8n9pu0f9GBj39ItVQGL\n"
  "-----END CERTIFICATE-----\n"
  // Sectigo Public Server Authentication Root E46
  "-----BEGIN CERTIFICATE-----\n"
  "MIICOjCCAcGgAwIBAgIQQvLM2htpN0RfFf51KBC49DAKBggqhkjOPQQDAzBfMQsw\n"
  "CQYDVQQGEwJHQjEYMBYGA1UEChMPU2VjdGlnbyBMaW1pdGVkMTYwNAYDVQQDEy1T\n"
  "ZWN0aWdvIFB1YmxpYyBTZXJ2ZXIgQXV0aGVudGljYXRpb24gUm9vdCBFNDYwHhcN\n"
  "MjEwMzIyMDAwMDAwWhcNNDYwMzIxMjM1OTU5WjBfMQswCQYDVQQGEwJHQjEYMBYG\n"
  "A1UEChMPU2VjdGlnbyBMaW1pdGVkMTYwNAYDVQQDEy1TZWN0aWdvIFB1YmxpYyBT\n"
  "ZXJ2ZXIgQXV0aGVudGljYXRpb24gUm9vdCBFNDYwdjAQBgcqhkjOPQIBBgUrgQQA\n"
  "IgNiAAR2+pmpbiDt+dd34wc7qNs9Xzjoq1WmVk/WSOrsfy2qw7LFeeyZYX8QeccC\n"
  "WvkEN/U0NSt3zn8gj1KjAIns1aeibVvjS5KToID1AZTc8GgHHs3u/iVStSBDHBv+\n"
  "6xnOQ6OjQjBAMB0GA1UdDgQWBBTRItpMWfFLXyY4qp3W7usNw/upYTAOBgNVHQ8B\n"
  "Af8EBAMCAYYwDwYDVR0TAQH/BAUwAwEB/zAKBggqhkjOPQQDAwNnADBkAjAn7qRa\n"
  "qCG76UeXlImldCBteU/IvZNeWBj7LRoAasm4PdCkT0RHlAFWovgzJQxC36oCMB3q\n"
  "4S6ILuH5px0CMk7yn2xVdOOurvulGu7t0vzCAxHrRVxgED1cf5kDW21USAGKcw==\n"
  "-----END CERTIFICATE-----\n"
  // GlobalSign Root CA - R3
  "-----BEGIN CERTIFICATE-----\n"
  "MIIDXzCCAkegAwIBAgILBAAAAAABIVhTCKIwDQYJKoZIhvcNAQELBQAwTDEgMB4G\n"
  "A1UECxMXR2xvYmFsU2lnbiBSb290IENBIC0gUjMxEzARBgNVBAoTCkdsb2JhbFNp\n"
  "Z24xEzARBgNVBAMTCkdsb2JhbFNpZ24wHhcNMDkwMzE4MTAwMDAwWhcNMjkwMzE4\n"
  "MTAwMDAwWjBMMSAwHgYDVQQLExdHbG9iYWxTaWduIFJvb3QgQ0EgLSBSMzETMBEG\n"
  "A1UEChMKR2xvYmFsU2lnbjETMBEGA1UEAxMKR2xvYmFsU2lnbjCCASIwDQYJKoZI\n"
  "hvcNAQEBBQADggEPADCCAQoCggEBAMwldpB5BngiFvXAg7aEyiie/QV2EcWtiHL8\n"
  "RgJDx7KKnQRfJMsuS+FggkbhUqsMgUdwbN1k0ev1LKMPgj0MK66X17YUhhB5uzsT\n"
  "gHeMCOFJ0mpiLx9e+pZo34knlTifBtc+ycsmWQ1z3rDI6SYOgxXG71uL0gRgykmm\n"
  "KPZpO/bLyCiR5Z2KYVc3rHQU3HTgOu5yLy6c+9C7v/U9AOEGM+iCK65TpjoWc4zd\n"
  "QQ4gOsC0p6Hpsk+QLjJg6VfLuQSSaGjlOCZgdbKfd/+RFO+uIEn8rUAVSNECMWEZ\n"
  "XriX7613t2Saer9fwRPvm2L7DWzgVGkWqQPabumDk3F2xmmFghcCAwEAAaNCMEAw\n"
  "DgYDVR0PAQH/BAQDAgEGMA8GA1UdEwEB/wQFMAMBAf8wHQYDVR0OBBYEFI/wS3+o\n"
  "LkUkrk1Q+mOai97i3Ru8MA0GCSqGSIb3DQEBCwUAA4IBAQBLQNvAUKr+yAzv95ZU\n"
  "RUm7lgAJQayzE4aGKAczymvmdLm6AC2upArT9fHxD4q/c2dKg8dEe3jgr25sbwMp\n"
  "jjM5RcOO5LlXbKr8EpbsU8Yt5CRsuZRj+9xTaGdWPoO4zzUhw8lo/s7awlOqzJCK\n"
  "6fBdRoyV3XpYKBovHd7NADdBj+1EbddTKJd+82cEHhXXipa0095MJ6RMG3NzdvQX\n"
  "mcIfeg7jLQitChws/zyrVQ4PkX4268NXSb7hLi18YIvDQVETI53O9zJrlAGomecs\n"
  "Mx86OyXShkDOOyyGeMlhLxS67ttVb9+E7gUJTb0o2HLO02JQZR7rkpeDMdmztcpH\n"
  "WD9f\n"
  "-----END CERTIFICATE-----\n"
  // GlobalSign Root R46
  "-----BEGIN CERTIFICATE-----\n"
  "MIIFWjCCA0KgAwIBAgISEdK7udcjGJ5AXwqdLdDfJWfRMA0GCSqGSIb3DQEBDAUA\n"
  "MEYxCzAJBgNVBAYTAkJFMRkwFwYDVQQKExBHbG9iYWxTaWduIG52LXNhMRwwGgYD\n"
  "VQQDExNHbG9iYWxTaWduIFJvb3QgUjQ2MB4XDTE5MDMyMDAwMDAwMFoXDTQ2MDMy\n"
  "MDAwMDAwMFowRjELMAkGA1UEBhMCQkUxGTAXBgNVBAoTEEdsb2JhbFNpZ24gbnYt\n"
  "c2ExHDAaBgNVBAMTE0dsb2JhbFNpZ24gUm9vdCBSNDYwggIiMA0GCSqGSIb3DQEB\n"
  "AQUAA4ICDwAwggIKAoICAQCsrHQy6LNl5brtQyYdpokNRbopiLKkHWPd08EsCVeJ\n"
  "OaFV6Wc0dwxu5FUdUiXSE2te4R2pt32JMl8Nnp8semNgQB+msLZ4j5lUlghYruQG\n"
  "vGIFAha/r6gjA7aUD7xubMLL1aa7DOn2wQL7Id5m3RerdELv8HQvJfTqa1VbkNud\n"
  "316HCkD7rRlr+/fKYIje2sGP1q7Vf9Q8g+7XFkyDRTNrJ9CG0Bwta/OrffGFqfUo\n"
  "0q3v84RLHIf8E6M6cqJaESvWJ3En7YEtbWaBkoe0G1h6zD8K+kZPTXhc+CtI4wSE\n"
  "y132tGqzZfxCnlEmIyDLPRT5ge1lFgBPGmSXZgjPjHvjK8Cd+RTyG/FWaha/LIWF\n"
  "zXg4mutCagI0GIMXTpRW+LaCtfOW3T3zvn8gdz57GSNrLNRyc0NXfeD412lPFzYE\n"
  "+cCQYDdF3uYM2HSNrpyibXRdQr4G9dlkbgIQrImwTDsHTUB+JMWKmIJ5jqSngiCN\n"
  "I/onccnfxkF0oE32kRbcRoxfKWMxWXEM2G/CtjJ9++ZdU6Z+Ffy7dXxd7Pj2Fxzs\n"
  "x2sZy/N78CsHpdlseVR2bJ0cpm4O6XkMqCNqo98bMDGfsVR7/mrLZqrcZdCinkqa\n"
  "ByFrgY/bxFn63iLABJzjqls2k+g9vXqhnQt2sQvHnf3PmKgGwvgqo6GDoLclcqUC\n"
  "4wIDAQABo0IwQDAOBgNVHQ8BAf8EBAMCAYYwDwYDVR0TAQH/BAUwAwEB/zAdBgNV\n"
  "HQ4EFgQUA1yrc4GHqMywptWU4jaWSf8FmSwwDQYJKoZIhvcNAQEMBQADggIBAHx4\n"
  "7PYCLLtbfpIrXTncvtgdokIzTfnvpCo7RGkerNlFo048p9gkUbJUHJNOxO97k4Vg\n"
  "JuoJSOD1u8fpaNK7ajFxzHmuEajwmf3lH7wvqMxX63bEIaZHU1VNaL8FpO7XJqti\n"
  "2kM3S+LGteWygxk6x9PbTZ4IevPuzz5i+6zoYMzRx6Fcg0XERczzF2sUyQQCPtIk\n"
  "pnnpHs6i58FZFZ8d4kuaPp92CC1r2LpXFNqD6v6MVenQTqnMdzGxRBF6XLE+0xRF\n"
  "FRhiJBPSy03OXIPBNvIQtQ6IbbjhVp+J3pZmOUdkLG5NrmJ7v2B0GbhWrJKsFjLt\n"
  "rWhV/pi60zTe9Mlhww6G9kuEYO4Ne7UyWHmRVSyBQ7N0H3qqJZ4d16GLuc1CLgSk\n"
  "ZoNNiTW2bKg2SnkheCLQQrzRQDGQob4Ez8pn7fXwgNNgyYMqIgXQBztSvwyeqiv5\n"
  "u+YfjyW6hY0XHgL+XVAEV8/+LbzvXMAaq7afJMbfc2hIkCwU9D9SGuTSyxTDYWnP\n"
  "4vkYxboznxSjBF25cfe1lNj2M8FawTSLfJvdkzrnE6JwYZ+vj+vYxXX4M2bUdGc6\n"
  "N3ec592kD3ZDZopD8p/7DEJ4Y9HiD2971KE9dJeFt0g5QdYg/NA6s/rob8SKunE3\n"
  "vouXsXgxT7PntgMTzlSdriVZzH81Xwj3QEUxeCp6\n"
  "-----END CERTIFICATE-----\n"
  // GlobalSign Root E46
  "-----BEGIN CERTIFICATE-----\n"
  "MIICCzCCAZGgAwIBAgISEdK7ujNu1LzmJGjFDYQdmOhDMAoGCCqGSM49BAMDMEYx\n"
  "CzAJBgNVBAYTAkJFMRkwFwYDVQQKExBHbG9iYWxTaWduIG52LXNhMRwwGgYDVQQD\n"
  "ExNHbG9iYWxTaWduIFJvb3QgRTQ2MB4XDTE5MDMyMDAwMDAwMFoXDTQ2MDMyMDAw\n"
  "MDAwMFowRjELMAkGA1UEBhMCQkUxGTAXBgNVBAoTEEdsb2JhbFNpZ24gbnYtc2Ex\n"
  "HDAaBgNVBAMTE0dsb2JhbFNpZ24gUm9vdCBFNDYwdjAQBgcqhkjOPQIBBgUrgQQA\n"
  "IgNiAAScDrHPt+ieUnd1NPqlRqetMhkytAepJ8qUuwzSChDH2omwlwxwEwkBjtjq\n"
  "R+q+soArzfwoDdusvKSGN+1wCAB16pMLey5SnCNoIwZD7JIvU4Tb+0cUB+hflGdd\n"
  "yXqBPCCjQjBAMA4GA1UdDwEB/wQEAwIBhjAPBgNVHRMBAf8EBTADAQH/MB0GA1Ud\n"
  "DgQWBBQxCpCPtsad0kRLgLWi5h+xEk8blTAKBggqhkjOPQQDAwNoADBlAjEA31SQ\n"
  "7Zvvi5QCkxeCmb6zniz2C5GMn0oUsfZkvLtoURMMA/cVi4RguYv/Uo7njLwcAjA8\n"
  "+RHUjE7AwWHCFUyqqx0LMV87HOIAl0Qx5v5zli/altP+CAezNIm8BZ/3Hobui3A=\n"
  "-----END CERTIFICATE-----\n"
  // Amazon Root CA 1
  "-----BEGIN CERTIFICATE-----\n"
  "MIIDQTCCAimgAwIBAgITBmyfz5m/jAo54vB4ikPmljZbyjANBgkqhkiG9w0BAQsF\n"
  "ADA5MQswCQYDVQQGEwJVUzEPMA0GA1UEChMGQW1hem9uMRkwFwYDVQQDExBBbWF6\n"
  "b24gUm9vdCBDQSAxMB4XDTE1MDUyNjAwMDAwMFoXDTM4MDExNzAwMDAwMFowOTEL\n"
  "MAkGA1UEBhMCVVMxDzANBgNVBAoTBkFtYXpvbjEZMBcGA1UEAxMQQW1hem9uIFJv\n"
  "b3QgQ0EgMTCCASIwDQYJKoZIhvcNAQEBBQADggEPADCCAQoCggEBALJ4gHHKeNXj\n"
  "ca9HgFB0fW7Y14h29Jlo91ghYPl0hAEvrAIthtOgQ3pOsqTQNroBvo3bSMgHFzZM\n"
  "9O6II8c+6zf1tRn4SWiw3te5djgdYZ6k/oI2peVKVuRF4fn9tBb6dNqcmzU5L/qw\n"
  "IFAGbHrQgLKm+a/sRxmPUDgH3KKHOVj4utWp+UhnMJbulHheb4mjUcAwhmahRWa6\n"
  "VOujw5H5SNz/0egwLX0tdHA114gk957EWW67c4cX8jJGKLhD+rcdqsq08p8kDi1L\n"
  "93FcXmn/6pUCyziKrlA4b9v7LWIbxcceVOF34GfID5yHI9Y/QCB/IIDEgEw+OyQm\n"
  "jgSubJrIqg0CAwEAAaNCMEAwDwYDVR0TAQH/BAUwAwEB/zAOBgNVHQ8BAf8EBAMC\n"
  "AYYwHQYDVR0OBBYEFIQYzIU07LwMlJQuCFmcx7IQTgoIMA0GCSqGSIb3DQEBCwUA\n"
  "A4IBAQCY8jdaQZChGsV2USggNiMOruYou6r4lK5IpDB/G/wkjUu0yKGX9rbxenDI\n"
  "U5PMCCjjmCXPI6T53iHTfIUJrU6adTrCC2qJeHZERxhlbI1Bjjt/msv0tadQ1wUs\n"
  "N+gDS63pYaACbvXy8MWy7Vu33PqUXHeeE6V/Uq2V8viTO96LXFvKWlJbYK8U90vv\n"
  "o/ufQJVtMVT8QtPHRh8jrdkPSHCa2XV4cdFyQzR1bldZwgJcJmApzyMZFo6IQ6XU\n"
  "5MsI+yMRQ+hDKXJioaldXgjUkK642M4UwtBV8ob2xJNDd2ZhwLnoQdeXeGADbkpy\n"
  "rqXRfboQnoZsG4q5WTP468SQvvG5\n"
  "-----END CERTIFICATE-----\n";
