mariofritzer/Trilumag/firmware/panel/bootloader/funconfig.h

#ifndef _FUNCONFIG_H
#define _FUNCONFIG_H

#define FUNCONF_USE_HSI 1
#define FUNCONF_SYSTEM_CORE_CLOCK 48000000
#define FUNCONF_SYSTICK_USE_HCLK 1
#define FUNCONF_TINYVECTOR 1          // keine Interrupts im Bootloader: Platz sparen
#define FUNCONF_USE_DEBUGPRINTF 0

#endif
