mariofritzer/Trilumag/(commit log)

2026-10-04 Trilumag v0.1: Firmware mit Simulation, Webinstaller und automatischem Build
    Claude-Session: https://claude.ai/code/session_01D8tQegdeuVQTuXDZnoeHuM
2026-10-04 ESP32-C6 als vierte Variante bauen
    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
2026-10-04 Echter RS-485-Bus, Panel-Firmware und Pin-Einstellungen
    - Bus-Protokoll v1 (docs/protokoll.md) mit Erkennung über SNS-Leitungen
    - Hauptpanel: Betriebsart Simulation oder Bus, Board-Vorlagen und Pinwahl
    mit Prüfung, MQTT-Einstellungen in der App, eigener WS2814-Strip,
    Farben pro Panel dauerhaft gespeichert, Farbtest für die LED-Reihenfolge
    - Panel-Firmware für CH32V003 (ch32fun), Build in GitHub Actions
    - Installer bietet die Panel-Firmware zum Download an
    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
2026-10-04 Effekte für die ganze Wand: App, HTTP-API und Home Assistant
    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
2026-10-04 Web-App im Stil von WLED, Paletten, Intensität, Presets, Gesamthelligkeit
    - Kopfzeile mit Ein/Aus und Gesamthelligkeit, Tabs Farben, Effekte, Wand, Presets, Optionen
    - Farbrad mit Schnellfarben, Hex und Weißanteil, Auswahl einzelner Panels in der Vorschau
    - Farbe färbt laufende Effekte ein (wie WLED), Einfarbig als eigener Effekt
    - 10 Paletten und Intensität für alle Effekte
    - bis zu 16 Presets, auch in Home Assistant (dazu Palette und Intensität)
    - WLAN in den Optionen änderbar
    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
2026-10-04 Build: Compiler-Fehler als Anmerkungen, Version aus der Firmware
    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
2026-10-04 pcol: Parameter als uint8_t wegen Arduino-Prototypen
    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
2026-10-04 Feste Verbindung wie WLED, Helligkeit in Prozent, MQTT-Schalter, Netzliste, Updates behalten Einstellungen
    - eigener WebSocket-Server auf Port 81: Zustand und Effektbild kommen von selbst, Befehle über dieselbe Verbindung, HTTP als Rückfall
    - feste Listen (Effekte, Paletten) nur beim ersten Mal
    - Gesamthelligkeit und Panel-Helligkeit in Prozent
    - Schalter MQTT aktiv, Zugangsdaten bleiben gespeichert; kurze Wartezeit bei nicht erreichbarem Broker
    - gefundene WLANs als Liste zum Antippen mit Signalstärke, Suche wiederholt sich bei Fehlschlag (auch im Webinstaller)
    - Webinstaller schreibt Einzelteile statt eines Gesamtabbilds, damit WLAN, Einstellungen und Presets bei Updates erhalten bleibe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
    [trilumag.ino, ws.h]
2026-10-04 Versionsverlauf (CHANGELOG.md), Link in README und Installer
    Text-Änderungen lösen keinen Build mehr aus. [skip ci]
    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
2026-10-04 Trilumag-Logo als Favicon der App (für den nächsten Build)
    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
2026-10-04 OTA mit Releases und Downgrades, Improv-Zeilenwechsel, App: Abstände, ausklappbare Kästchen, WLAN-Qualität, Ziehen am Handy
    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
2026-10-04 App: Änderungen zu jeder Version in der Update-Liste (changelog.json)
    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
2026-10-04 Simulation: Wand und Ablage bleiben über Neustarts und Updates erhalten
    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
2026-10-04 Update-Absicherung, weiche Übergänge, Stromlimit mit optionalem INA226, Sichern und Wiederherstellen
    - einheitliche Ausgabe über Bilder mit Überblendung und Stromlimit
    - neue Version bewährt sich 45 s, Wächter, Rückfall wird gemeldet und nicht erneut automatisch installiert
    - Strom/Leistung/Spannung in App und Home Assistant
    - Sicherung als JSON herunterladen und einspielen
    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
2026-10-04 Stromlimit-Karte mit Sensor-Pins, Bus-Diagnose, Kanten einzeln (FRAME3, Panel-Firmware 2), WLED-Schnittstelle
    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
2026-10-04 Kanten einzeln: Liste zum An-/Abhaken und alle gleichzeitig; Absturz beim Umschalten in der Vorschau behoben
    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
2026-10-04 App: Antippen, Panel-Firmware, Anklips-Zähler in Wand und Diagnose
2026-10-04 CI: Panel-Firmware und Bootloader vor dem Hauptpanel bauen, panel_fw.h erzeugen, Panel-Dateien im Release
    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
2026-10-04 Doku: Protokoll für Antippen, Anklips-Zähler und Panel-Updates, README
2026-10-05 Philips Hue über Zigbee (nur ESP32-C6): Wand als Farblampe, Karte in der App, eigene Speicheraufteilung
    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
    [partitions_c6_zigbee.csv]
2026-10-05 CI: Zigbee im C6-Build prüfen und Größe melden
2026-10-05 App: Stromsensor und Ereignisse als aufklappbare Unterbereiche mit Kurzstatus
    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
2026-10-05 Version 0.7.26: Philips Hue über Zigbee (ESP32-C6), aufklappbare Unterbereiche
    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
2026-10-05 Name der Wand: in App, Home Assistant, WLED und mDNS
    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
2026-10-05 Panel finden, Malen, Sleep-Timer, Verhalten nach Stromausfall, Energie (Tage/Monate/Jahre), Betriebsstunden, mehrere Wände im Gleichtakt
    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
2026-10-05 Energie-Typen in eigene Datei (Arduino-Prototypen)
2026-10-05 Version 0.7.31: Name, Panel finden, Malen, Sleep-Timer, Stromausfall, Energie, Betriebsstunden, Gleichtakt
    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
2026-10-05 7 neue Effekte, Welle beim Antippen, Einschalt-Animation (Tempo wählbar), Ansicht drehen und spiegeln
    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
2026-10-05 Signal (Blinken) und Fortschritt für Home Assistant, Testkästchen in der App
    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
2026-10-05 Version 0.7.34: neue Effekte, Welle, Einschalt-Animation, Ansicht, Signal und Fortschritt
    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
2026-10-05 Effekt-Richtung (auch drehend) für alle Effekte, Farbwechsel-Übergänge in der App sichtbar, Wellen/Signal starten zuverlässig
    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
2026-10-05 Version 0.7.35: Effekt-Richtung, Übergänge in der App, Fehlerbehebung
    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
2026-10-05 Panel tauschen: in der App starten, dann 5 Minuten Zeit
    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
2026-10-05 Panel tauschen: kleines Fenster unten, Simulation hängt die Panels dahinter wieder an
    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
2026-10-06 Kopfzeile: Name der Wand nicht mehr abgeschnitten, Statuszeile kürzt sich stattdessen
    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
2026-10-06 Simulation: Panels in der Ablage einzeln löschen oder Ablage leeren
    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
2026-10-06 Helligkeit aller Panels auf einmal (Wand → Alle Panels), neue Panels starten mit 100 %
    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
2026-10-06 Optionen: andere Trilumag im WLAN finden und öffnen
    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
2026-10-06 Wand: feiner Strich zeigt die Bus-Verbindung zum vorigen Panel, Punkt für Kante 1 entfällt
    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
2026-10-06 Punkt für Kante 1 wieder da, Panels in der Simulation drehbar
    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
2026-10-06 Version 0.7.39: andere Trilumag finden, Helligkeit aller Panels, Bus-Striche, Drehen und Löschen in der Simulation
    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
2026-10-06 Weißton, Tageslicht-Kurve, 7 Effekte (Herzschlag, Plasma, Regen, Sternenhimmel, Feuerwerk, Matrix, Wetter), Simon sagt, Störungsanzeige, Wand als Bild, WLED nachahmen; flüssigere Vorschau
    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
    [trilumag.ino, webapp_gz.h]
2026-10-06 Spiel: Zustandsnamen kollidierten mit dem Arduino-Makro INPUT
    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
2026-10-06 Kanten einzeln: Komet läuft Kante für Kante, Einschalt-Animation, Fortschritt und Antipp-Welle pro Kante
    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
2026-10-06 Komet mit Kanten einzeln: alle drei Kanten eines Panels nacheinander, dann von der letzten hinüber
    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
2026-10-06 Eigene Paletten (Vorlage Rot-Gold-Weiß), Farbwechsel blendet auch in der App-Vorschau weich über
    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
2026-10-06 Version 0.7.47: eigene Paletten, Komet Kante für Kante, weiche Übergänge in der Vorschau
    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
2026-10-06 Komet: Intensität steuert die Schweiflänge, bei 255 sehr lang
    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
2026-10-06 Version 0.7.48: Hue-Lampe nachahmen über die Bridge, längerer Komet-Schweif
    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
2026-10-06 Version 0.7.49: Hue-Nachahmen zeigt den gemeldeten Zustand und erkennt Hue Sync
    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
2026-10-06 Updates: Hue- und WLED-Abfragen ruhen währenddessen, Hue-Verbindung bleibt offen
    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
2026-10-06 README: Version der ersten App
    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
2026-10-06 Start: Hue- und WLED-Abfragen erst mit WLAN (sonst Absturzschleife), sicherer Start nach 3 Abstürzen
    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
2026-10-07 App: Update direkt in der App laden und installieren, mit Fortschritt über unscharfem Hintergrund
    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
2026-10-07 Version 0.7.55: App-Update direkt in der App
    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
2026-10-07 App 1.1: sucht bei jedem Öffnen (höchstens stündlich) nach Updates, Antippen der Versionsnummer sucht sofort
    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
2026-10-07 App 1.1: Knopf „Nach Update suchen“
    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
2026-10-07 Version 0.7.61: App 1.0.1 mit Knopf „Nach Update suchen“
    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
2026-10-07 Raum: Grundriss von oben, jede Raumwand von vorne, Raum-Effekte über alle Wände; Palettenfarben und Helligkeit werden mitgenommen; App 1.1.0 mit Raum-Knopf
    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
2026-10-07 Palette: Hilfsfunktion im Namensraum (Arduino-Prototypen)
    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
2026-10-07 Version 0.7.67: Raum mit Grundriss und Wandansichten, Raumhöhe einstellbar, Raum-Effekte, Palettenfarben und Helligkeit für alle Wände; App 1.1.0
    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
2026-10-07 Raum-Komet irrt wie der Komet von Panel zu Panel durch alle Wände; Raum-Version als ganze Zahl gespeichert
    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
2026-10-07 Raum-Komet wie der Komet einer Wand: Kante für Kante, ein Kopf für alle Wände; Raum gleicht sich zwischen den Wänden ab
    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
2026-10-09 Panelwand und Raumwand als Begriffe; Raumwand löschen, Raum löschen (geht an alle Panelwände); App 1.1.1
    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
2026-10-31 Hardware: Nebenplatine (Panel) Rev 0.2 als KiCad-Projekt mit Generator
    Dreieck 200 mm, 2 Lagen, Handlöt-Footprints, 24-V-Ring, Gerber, Stückliste, Schaltplan-PDF.
    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
2026-10-31 Hardware: Nebenplatine mit 6-poligen Kabelanschlüssen, komplett verlegt
    Pogo-Stecker sitzen per Kabel um 90° gedreht; Lötaugen RM 3,5 mm, Pin 1/6 dicker (GND/24 V).
    Eigener Raster-Router statt Freerouting, DRC ohne Fehler.
    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
2026-10-31 Nebenplatine: Beschriftung 0,8 mm, Leiterbahn-Stummel entfernt
    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
2026-10-31 Hauptplatine: KiCad-Projekt, Gerber, Schaltplan, Stückliste
    DRC: 0 Fehler, 0 offene Verbindungen (KiCad 7). USB-C- und INA226-Fanout
    von Hand, Rest mit eigenem Rasterrouter.
    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
2026-10-31 Hauptplatine: Lötloch im ESP-Massepad an GND
    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
2026-10-31 Nebenplatine Rev 0.3: 70 × 64 mm statt Dreieck
    Pogo-Stecker, -Buchsen und LED-Streifen kommen per Kabel, die Platine
    bleibt unter 100 × 100 mm. DRC: 0 Fehler, 0 offene Verbindungen.
    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
2026-10-31 Hauptplatine Rev 0.3: 90 × 80 mm statt Dreieck
    Pogo-Stecker/-Buchsen (Kante 2 und 3) und LED-Streifen per Kabel, Platine
    unter 100 × 100 mm. DRC: 0 Fehler, 0 offene Verbindungen.
    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
2026-11-01 Webinstaller: Simulationsseite ohne ESP32
    simulation.html ist die echte App; sim.js spielt im Browser das Hauptpanel
    (Effekte aus fxCompute übernommen, Panelwand, Presets und Paletten in
    localStorage). Dazu Farbrad-Fix: bei 300 px und Pixeldichte 1 blieb es leer.
    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
